z-XOF-z/FT150TS/README.md

<div align="center">

FT150TS Dashboard: tablero digital para la Italika FT150TS

<br/>

**El tablero que la FT150TS no traía de fábrica.**

Tablero digital + launcher para Android que funciona **solo con el teléfono** del manubrio
y está listo para una tarjeta **ESP32** en la moto.

[](#empezar)
[](app/src/main/java/com/xof/ft150ts)
[](app/src/main/java/com/xof/ft150ts/ui)
[](firmware/ft150ts_dashboard)
[](LEEME.md)

### [⬇ Descargar la app (APK v3.4 estable)](https://github.com/z-XOF-z/FT150TS/releases/latest)

**[Qué hace](#qué-hace)** · **[Empezar](#empezar)** · **[La tarjeta ESP32](#la-tarjeta-esp32)** · **[Historial completo](LEEME.md)**

</div>

---

## Por qué

El teléfono ya iba en el manubrio de la moto. En vez de solo mirar el mapa, se vuelve el **tablero completo**:
velocidad, RPM, marcha, inclinación, mantenimiento, gasolina y navegación, con un diseño pixel y deportivo
pensado para la FT150TS. Sin cables extra: las RPM salen de la **vibración del motor** que siente el teléfono.
Cuando llegue la tarjeta ESP32, ella manda los datos que el teléfono no puede medir (voltaje, temperatura, RPM
directas) y la app se cambia sola.

## Qué hace

<div align="center">
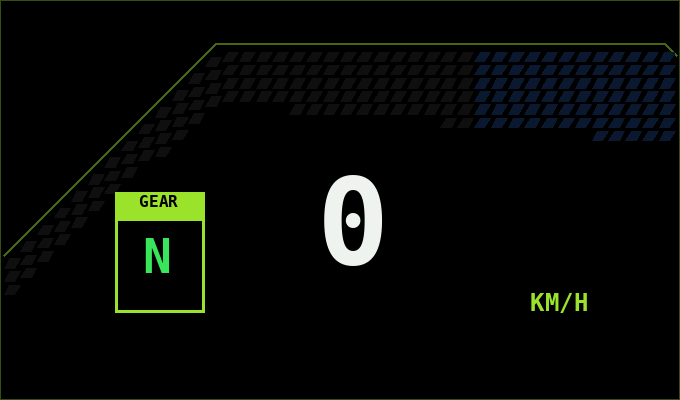
[picture p1: docs/entrada_tablero.gif]
Animación al entrar al tablero

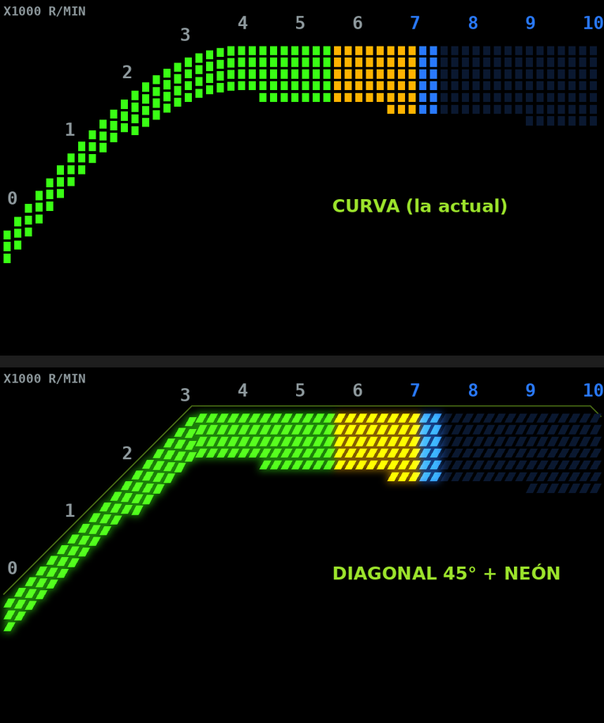
[picture p2: docs/barra_rpm.png]
Barra de RPM curva y diagonal a 45°

</div>

| Capacidad | Qué te da |
| --- | --- |
| **Tablero LCD Sport** | Barra de RPM curva o diagonal a 45°, dígitos de 7 segmentos, marcha, shift light y animación de arranque (las RPM suben al tope y regresan, como al dar switch). |
| **RPM sin sensor** | La vibración del motor por FFT de 3 ejes, peine de armónicos y filtro de Kalman. Se calibra en 6 s en ralentí. |
| **Marcha** | Velocidad + RPM + la marcha anterior en un filtro de probabilidad: no marca "4ª a 17 km/h". |
| **Aguja con PID** | La aguja tiene inercia de verdad; Kp, Ki y Kd ajustables con gráfica de respuesta. |
| **Mapa** | OpenStreetMap que gira suave con la brújula, satélites y doble frecuencia L5, dónde dejé la moto, límite de velocidad, "llévame a casa". |
| **Modo moto** | El cable de la moto hace de switch: carga = tablero, sin carga = tus apps. Etiqueta NFC del soporte y **modo sueño** cuando carga sin moverse. |
| **Launcher** | Pantalla de inicio con tus apps, 4 accesos directos y tres estilos de íconos (normales, pixel, LCD). |
| **Rodadas** | Cada rodada se graba sola; mírala en el mapa pintado por velocidad y **repítela** x10/x30/x60. Aviso de descanso. |
| **Arrancones** | 0-40/60/80, 100 m y 1/8 de milla con semáforo y tiempo de reacción, y prueba de frenado 40→0 (en lugar cerrado). |
| **Lluvia en tu ruta** | Revisa el pronóstico kilómetros adelante en la dirección en que vas y te avisa antes de mojarte. |
| **Velocímetro vs GPS** | Cuánto marca de más tu velocímetro y a cuánto vas de verdad. |
| **Mantenimiento** | Odómetro del teléfono, servicios por km, bitácora de gasolina con rendimiento y **alcance**. |
| **Respaldo** | Todos tus datos en un archivo: guárdalo, compártelo o deja el automático semanal. |
| **Seguridad** | Dashcam en bucle que guarda el video si detecta un golpe, aviso de teléfono caliente, batería del cel. |
| **Clima y alertas** | Lluvia próxima, huracanes (NHC), sismos (USGS) y clima severo en el tablero. |
| **Temas** | **Vértice** (riel lateral, nuevo), Carbono, Vidrio, Filo, Pixel, Táctico, Holo, Ácido y Circuito · efecto neón · 18 colores + uno personalizado · 4 fondos. |
| **Reposo** | Moto parada y cargando: reloj atenuado o pantalla apagada, GPS en pausa; despierta solo al dar marcha. |

### La idea en una línea

> El teléfono que ya va en el manubrio se vuelve el tablero; la ESP32 le da lo que el teléfono no puede medir.

## Empezar

### 1. Instala la app

**La rápida:** descarga el APK del [último release](https://github.com/z-XOF-z/FT150TS/releases/latest) en tu
teléfono (Android 8.0 o más nuevo), ábrelo y permite "Instalar apps desconocidas".

**Actualizar:** desde la 3.2-beta.1, en la app: Ajustes → Acerca de → **Buscar actualización** (prende "Versiones de prueba" para recibir betas). Se instala encima sin
borrar tus datos. Detalles y cómo publicar una versión en [docs/RELEASE.md](docs/RELEASE.md).

**Desde el código:**

Abre esta carpeta en **Android Studio**, conecta el teléfono (depuración USB) y:

```bash
./gradlew installDebug      # normal
./gradlew installRelease    # optimizada, más fluida (misma firma: no borra tus datos)
```

Requiere Android 8.0 o más nuevo. Siempre se instala **encima**: tu odómetro, marchas aprendidas y ajustes se quedan.

### 2. Calibra las RPM (una vez)

Moto en neutral, motor caliente en ralentí y el teléfono en el soporte:
**Ajustes > Sin la tarjeta > Calibrar en ralentí** (6 segundos).

### 3. Escoge tu estilo

**Ajustes > Apariencia**: tema, color de acento, neón, fondo, forma de la barra de RPM y la animación de entrada.

## La tarjeta ESP32

Firmware en [`firmware/ft150ts_dashboard`](firmware/ft150ts_dashboard), placa **ESP32-S3**, particiones *Huge APP*:

```bash
arduino-cli compile --fqbn espressif:esp32:esp32s3:PartitionScheme=huge_app firmware/ft150ts_dashboard
```

Desde la v1.4 cada tarjeta genera su propia clave de WiFi (se ve por USB al encender o con `wifi clave`) y los
comandos delicados solo se aceptan de un teléfono vinculado. Detalles en [SEGURIDAD.md](SEGURIDAD.md).

## Placa base y piezas 3D

- **Placa base v2.3** para el ESP32-S3 N16R8 (10×10 cm, 2 capas, piezas de agujero de tiendas de México): guía de armado y conexiones a la moto en [`pcb/ARMADO.md`](pcb/ARMADO.md), esquemático en [PDF](pcb/esquematico/ft150ts_B_esquema.pdf), gerbers para JLCPCB en [`pcb/fabricar/B_JLCPCB`](pcb/fabricar/B_JLCPCB) y piezas en [`pcb/LISTA_COMPRAS.md`](pcb/LISTA_COMPRAS.md).
- **Placas extra** (expansión I2C con 3 relevadores, fusibles y perforada): [`pcb/extras`](pcb/extras).
- **Simulaciones** de cada bloque (ngspice/KiCad): [`pcb/simulacion`](pcb/simulacion).
- **Piezas 3D** (CadQuery): soporte del teléfono para el manubrio y caja de la placa bajo el asiento, en [`carcasa`](carcasa) (STL y STEP).
- Mapa de todo el proyecto: [`docs/MAPA.md`](docs/MAPA.md).

## Temas

<div align="center">
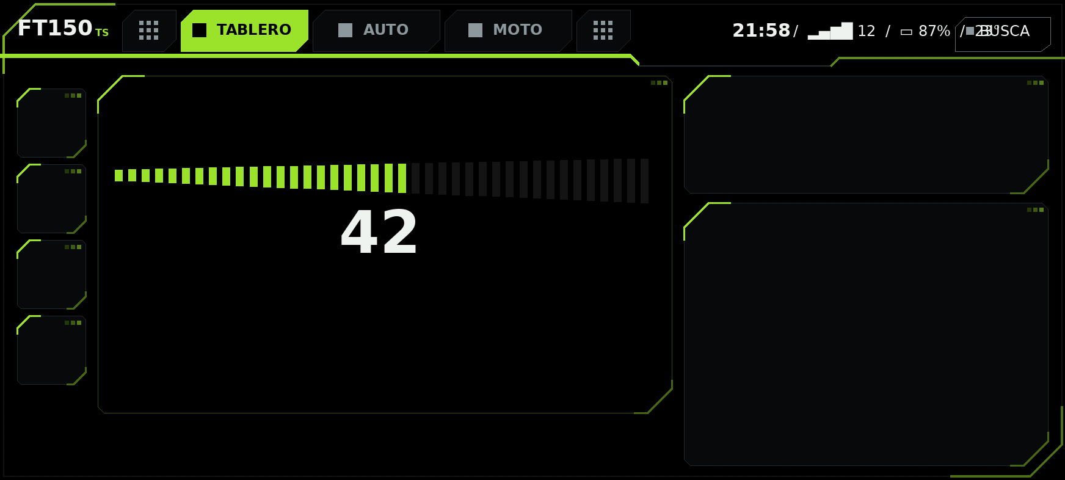
[picture p3: docs/maqueta_filo.png]
Tema Filo

<br/><sub>Tema Filo: barra integrada con segmentos a 45° y todo dentro de un marco tipo visor.</sub>
</div>

## Hoja de ruta

- [x] Tablero LCD Sport y Clásico con aguja PID
- [x] RPM por vibración, marcha por velocidad + RPM
- [x] Modo moto, NFC, modo sueño
- [x] Temas Filo, Pixel y Táctico, neón y colores personalizados
- [x] Respaldo y restaurar todos tus datos en un archivo
- [x] Modo arrancones (0–60 km/h, 1/8 de milla, semáforo) y prueba de frenado
- [x] Lluvia en tu ruta
- [x] Repetición de rodadas coloreada por velocidad
- [x] Error del velocímetro contra el GPS
- [x] Logros pixel (y un secreto)
- [x] Tema Vértice, modo reposo y medidor de fluidez
- [x] Auditoría de seguridad (WiFi y Bluetooth de la tarjeta, respaldo)
- [ ] Antirrobo (con la ESP32)
- [ ] Temperatura del motor, nivel de gasolina real y presión de llantas (con la ESP32)

## Estructura

```
app/                      App de Android (Kotlin + Jetpack Compose)
  src/main/java/com/xof/ft150ts/
    ui/                   Pantallas, temas, barra integrada, animaciones
    *.kt                  GPS, sensores, RPM, marcha, modo moto, modo sueño...
firmware/
  ft150ts_dashboard/      Firmware del ESP32-S3 (Arduino)
docs/                     Banner animado, GIFs e imágenes
releases/                 APK listo para instalar y notas de cada versión
LEEME.md                  Guía completa e historial de versiones
```

---

<div align="center">

Hecho por **XOF** para su Italika FT150TS.

<sub>Tipografías Chakra Petch, Russo One y Press Start 2P con licencia OFL ([LICENCIAS_FUENTES.txt](LICENCIAS_FUENTES.txt)) · Mapas © colaboradores de OpenStreetMap</sub>

</div>

[android-shield]: https://img.shields.io/badge/Android-8.0%2B-9BE22B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
[kotlin-shield]: https://img.shields.io/badge/Kotlin-2.1-9BE22B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
[compose-shield]: https://img.shields.io/badge/Jetpack%20Compose-Material%203-9BE22B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
[esp32-shield]: https://img.shields.io/badge/ESP32--S3-firmware-9BE22B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
[version-shield]: https://img.shields.io/badge/versi%C3%B3n-3.4-9BE22B?style=for-the-badge&labelColor=0E1113
