z-XOF-z/FT150TS/docs/MAPA.md

# Mapa del proyecto FT150TS

Tablero digital para la moto **Italika FT150TS**, en tres partes que trabajan juntas:

1. **App Android** (`app/`): Kotlin + Jetpack Compose. Paquete `com.xof.ft150ts`. Convierte el POCO F4 en tablero y launcher (HOME) de la moto: velocímetro, RPM, marcha, mapas, CarPlay (vía DiPlay), música, SOS, ahorro nocturno con root y temas.
2. **Firmware ESP32-S3** (`firmware/ft150ts_dashboard/`): lee los sensores de la moto, muestra una LCD 20x4 y le manda la telemetría a la app por Bluetooth (BLE).
3. **Hardware** (`pcb/`, `carcasa/`): la placa base para el ESP32 (KiCad → JLCPCB) y las piezas impresas en 3D (soporte del teléfono y caja bajo el asiento).

## Compilar, probar y publicar

| Qué | Comando o pasos |
|---|---|
| App: pruebas + APK | Git Bash: `export JAVA_HOME="/c/Program Files/Android/Android Studio/jbr"; ./gradlew :app:testDebugUnitTest :app:assembleRelease` (sin JAVA_HOME falla al arrancar; Gradle usa JDK 21 por `gradle/gradle-daemon-jvm.properties`) |
| App: instalar | `adb install -r app/build/outputs/apk/release/app-release.apk`. Misma firma (`debug.keystore` de esta PC); **nunca desinstalar** |
| App: publicar | Sube `versionCode`/`versionName` en `app/build.gradle.kts` → APK a `releases/FT150TS-vX.apk` + `releases/NOTAS-vX.md` → release `vX` en `z-XOF-z/FT150TS` con el APK adjunto. Guía: `docs/RELEASE.md`. Esta carpeta **no es repo git**: el código se sube con un clon aparte |
| Firmware | Arduino IDE o arduino-cli, placa "ESP32S3 Dev Module", **core esp32 3.2.1** (el 3.3 rompe el BLE), Flash 16MB, PSRAM OPI y particiones **"16M Flash (3MB APP/9.9MB FATFS)"** (`PartitionScheme=app3M_fat9M_16MB`): dos copias para actualizar desde la app (OTA). Para grabar por la app: Sketch > Exportar binario compilado |
| Placas | Python de KiCad 10: `pcb/generar_pcb.py B --rutear` (placa principal), `pcb/extras/generar_extra.py E|F`, `pcb/extras/generar_perforada.py`. Freerouting necesita Java 25 (JBR) |
| Piezas 3D | `carcasa/.venv` (CadQuery): `python carcasa/caja_tablero/caja_tablero.py`, `caja_bateria.py` |

## Carpetas

| Carpeta | Qué hay |
|---|---|
| `app/src/main/java/com/xof/ft150ts/` | Lógica de la app (≈70 archivos, uno por función) |
| `app/src/main/java/com/xof/ft150ts/ui/` | Pantallas y tableros en Compose (≈36 archivos) |
| `app/src/test/` | Pruebas unitarias (104 a la v3.10.0) de las partes `*Logica.kt` y protocolos |
| `firmware/ft150ts_dashboard/` | El `.ino` (~4 150 líneas) + `certificados.h` (raíces de api.telegram.org, vencen en 2037) |
| `firmware/simulador_wokwi/` | Copia del sketch + `diagram.json` para simular en Wokwi/Velxio |
| `firmware/HARDWARE-CORTE-CHISPA.md` | Circuito del corte de chispa (PC817 + IRF840) |
| `docs/` | `CARPLAY.md`, `AHORRO_NOCTURNO.md`, `SOS.md`, `RELEASE.md`, `ESP32_ARRANQUE_XMC.md` (arranque, particiones y falla XMC del N16R8), este mapa |
| `bootloader_reparado_XMC.bin` | Bootloader de 2.ª etapa con parche XMC `0x70` (ESP-IDF 5.4.2 local). Se graba solo en `0x0`; ver `docs/ESP32_ARRANQUE_XMC.md` |
| `releases/` | APK de cada versión + `NOTAS-v*.md` (la app muestra las notas como "qué hay de nuevo") |
| `modulo-magisk/` | Módulo "ft150ts_sin_barra": quita la barra de 3 puntos de las ventanas libres (CarPlay) |
| `scripts/` | Diagnósticos de solo lectura por ADB (`diagnostico-carplay.ps1`, `diagnostico-energia.ps1`) |
| `pcb/` | Diseño de la placa base (ver la sección Placas) |
| `carcasa/` | Piezas 3D (ver la sección Piezas 3D) |
| `llavero/` | **TamaXOF**, el llavero (ESP32-C3 SuperMini + OLED 0.96" + TP4056 + pila de control de PS4). `firmware/tamaxof/` es el llavero: caritas, llave por ESP-NOW cifrada, paro de motor, música BLE y extras. `moto/tamaxof_moto.h` es el lado moto, **todavía no está en el .ino**. `moto/probador_moto/` es una moto falsa para la mesa. `comun/` tiene el protocolo y la clave (`generar_secreto.py`, la clave no se sube). `pcb/generar_placa.py` es la placa casera de una cara con planchado y revisión de cortos y separación. `carcasa/carcasa_tamaxof.py` es la caja con revisión de choques. Todo explicado en `llavero/LEEME.md` |

## App: archivos por área

| Área | Archivos | Qué hacen |
|---|---|---|
| Arranque y navegación | `MainActivity.kt`, `ui/AppFT150.kt`, `ui/Barra.kt`, `ui/Arranque.kt`, `ui/PantallaInicio.kt`, `ui/InicioNeon.kt` | Launcher HOME; pager Tablero · Auto · Moto · Ajustes; pantallas de inicio |
| Conexión con el ESP32 | `BleManager.kt`, `Moto.kt`, `ServicioMoto.kt`, `Modelo.kt` (`Estado`, `Rapida`) | BLE, comandos a la tarjeta, servicio en segundo plano, modelo de datos |
| Tableros | `ui/PantallaTablero.kt`, `ui/Tableros*.kt`, `ui/Tablero*.kt`, `ui/TinteTableros.kt`, `ui/TableroUniversal.kt` | LCD, deportivos, instrumento, neón, morado, telemetría, dual neón |
| Datos de manejo | `Velocimetro.kt`, `Marcha.kt`, `RpmVibracion.kt`, `Sensores.kt`, `Termico.kt`, `Odometro.kt`, `Gasolina.kt`, `Estadisticas.kt`, `Arrancones.kt`, `Baches.kt`, `LimitesVia.kt` | Velocidad, marcha estimada, RPM por vibración, mantenimiento, consumo |
| Auto, mapas y CarPlay | `ui/PantallaAuto.kt`, `CarPlay.kt`, `CarPlayPestana.kt`, `ui/MapaCarPlay.kt`, `GestosCarPlay*.kt`, `Mapas.kt`, `Ubicacion.kt`, `Gpx.kt`, `Rodadas.kt`, `Rutinas*.kt`, `LluviaRuta.kt`, `Clima.kt` | CarPlay de DiPlay dentro de la pestaña, mapas, rodadas y rutinas |
| Música y audio | `Musica.kt`, `AudioSalida.kt`, `VolumenAuto.kt`, `VolumenLogica.kt`, `Sonoridad.kt`, `ui/AjustesAudio.kt` | Control de música y volumen según la velocidad |
| Teléfono y apps | `Lanzador.kt`, `ui/PantallaApps.kt`, `Acciones.kt`, `NotifListener.kt`, `TelefonoMoto.kt`, `ComandosVoz.kt`, `Voz.kt` | Lista de apps, notificaciones, voz |
| Root y energía | `Root.kt`, `AyudanteRoot.kt`, `Energia.kt`, `Nocturno*.kt`, `Reposo.kt`, `Encendido.kt`, `DiagnosticoEnergia.kt`, `ModoRendimiento*.kt`, `Pantalla.kt`, `Fluidez.kt`, `PantallaEncendidaLogica.kt` | Sesión `su` con lista permitida, ahorro nocturno, modo rendimiento, 90/120 Hz; cuándo se fuerza la pantalla prendida y cuándo se cierra CarPlay escondido (guardián en `CarPlayPestana.kt`) |
| Seguridad | `Emergencia.kt`, `ui/SosUi.kt`, `Dashcam.kt`, `Estacionamiento.kt`, `ZonaWifi.kt`, `NfcMoto.kt` | SOS con cuenta regresiva, dashcam (con `.srt`), dónde quedó la moto |
| Funciones avanzadas | `FuncionesAvanzadas.kt`, `ui/AjustesAvanzadas.kt` | Limitador, launch, quickshifter y diagnóstico (todo apagado; protocolo `av`) |
| Apariencia | `Apariencia.kt`, `Estilos.kt`, `ui/Tema.kt`, `ui/MotorEstilos.kt`, `ui/Vertice.kt`, `ui/IconosApp.kt` | Temas, estilos de tablero, íconos |
| Ajustes y respaldo | `ui/PantallaAjustes.kt`, `ui/Ajustes*.kt`, `Respaldo.kt`, `Actualizador.kt` | Configuración, respaldo y actualizador desde GitHub |
| Herramientas de la tarjeta | `TarjetaHerramientas.kt` (`OtaTarjeta`, `RegistrosTarjeta`, `CasaTarjeta`, `OtaLogica`, `LogicaTelegram`), `ui/TarjetaHerramientasUi.kt` | Actualizar el firmware por Bluetooth, bajar los CSV de la SD a Descargas/FT150TS, WiFi de casa + bot de Telegram (firmware v1.6+) |
| Placa B | `PlacaB.kt`, `ui/PlacaBUi.kt` | Nombres y control de los relevadores 2/3 y la salida, alarma, IA de vibraciones, luz del teléfono a la tarjeta (`luz N` cada 10 s), avisos de direccional olvidada / vibración rara |
| Antirrobo del teléfono | `Vigilancia.kt` (+ `TelegramTel`), `VigilanciaLogica.kt`, `ui/MotoExtrasUi.kt` | Con la moto estacionada: si mueven el teléfono (o la tarjeta manda `m`) y no eres tú en 20 s, fotos de las 2 cámaras + audio + ubicación por Telegram. Cámara y micrófono con la pantalla apagada: `ServicioMoto` con tipos camera/microphone |
| Estado y baterías | `Voltajes.kt`, `ui/MotoExtrasUi.kt` (`SeccionEstadoMoto`, `SeccionBaterias`) | Estado de la moto (`salud`) y gráficas de voltaje de 24 h |
| Red de seguridad | `Seguro.kt` | `Seguro.manejador` en todas las `CoroutineScope`: un error de fondo se anota (`FT150-ERR`) en vez de cerrar el launcher |
| Otros | `Logros.kt`, `Alertas.kt`, `ui/AlertasUi.kt`, `BateriaTel.kt`, `Brujula.kt`, `Luz.kt`, `Pid.kt`, `Sueno.kt`, `BluetoothAdmin.kt` | Logros, alertas, sensores del teléfono |

Archivos `*Logica.kt`: lógica pura sin Android, para que se pueda probar en `app/src/test/`.

## Firmware: secciones del `.ino`

| Línea aprox. | Sección |
|---|---|
| 64 | 0) Interruptores generales (`MODO_SIMULADOR`, `USAR_*`) |
| 292 | 2) Configuración: pines, valores `<-- X` que hay que llenar |
| 620 / 674 | 5) Memoria NVS · 6) Tarjeta SD (CSV) |
| 724–1044 | 7) Analógicos · 8) RPM y velocidad (interrupciones) · 9) GPS · 10) MPU6050 · 11) DS18B20 · 12) Marcha e ignición · 13) Botones |
| 1076–1617 | 14) Pantalla · 15) Mantenimiento · 16) Viajes · 17) Motor · 18) Baterías · 19) Shift light · 20) Modo pista · 21) Corte de motor |
| 1617 | 21b) Funciones avanzadas (`USAR_CORTE_CHISPA 0`, tarea FreeRTOS `tareaChispa`) |
| ~1850 | 21c) Placa B: entradas (freno, direccional olvidada), relevadores 2/3 y salida (`rele`), carga de la celda · 21d) Alarma de movimiento (`alarma`, MPU en modo ciclo + INT despierta a la tarjeta, 20 s para girar la llave) · 21e) IA de vibraciones (`vibra`: FIFO del MPU a 100 Hz, Goertzel, promedio y variación por rango de 500 rpm, alerta > 3.5) |
| ~2530 | 21g) Placa E (`placaETick`, PCF8574 0x20 leído cada 100 ms, BOMBA con tope 10 min/descanso 5, corte por batería < 10.5 V o moto en movimiento; `FUNCION_E` para sus 4 entradas) · 21h) Guardián (`guardianBegin/Tick/Vigilar`: vigilante de 30 s en loop, motivo del reinicio, modo seguro tras 3 fallas, temperatura del chip, memoria, regulador, componentes; bitácora NVS de 12 renglones → Telegram y evento `w`) |
| ~2900 | 21i) IA del motor (`iaMotorTick`: embrague que patina = relación RPM/vel vs lo aprendido a velocidad constante por marcha (Welford), acelerando en 3a+; aceite por km efectivos con factor por RPM/temperatura/frío; NVS "ia"; comando `ia`, renglón "Embrague" en `salud`). `USAR_PLACA_E` (sección 0) apaga la búsqueda de la placa E |
| ~2300 | 21f) IA de baches (`bachesRevisar`, adaptativa, `baches.csv` + evento `b`), estado de los componentes (`salud`), llave de proximidad (`llave`, APAGADA de fábrica, código de botones), resumen semanal (Telegram los lunes) |
| 1851–2310 | 22) Alertas · 23) Vistas · 24) Menú · 25) Modo demo · 26) Lectura real |
| 2328 / 2478 | 27) Notificaciones · 27b) iPhone |
| 2903 | 28) Consola (Serial y web, mismos comandos) |
| ~3090 | 28b) `ota …` (firmware desde la app), `sd lista/leer` (registros), `casa …` (WiFi de casa + Telegram: `casaAlDespertar`, `casaTick`, `tgRevisarMensajes`) |
| 3175 / 3296 | 29) WiFi · 29b) Telemetría BLE para la app |
| 3488 / 3548 | 30) Sueño profundo · 31) setup/loop |

## Cómo fluye la información

- Sensores (bobina → RPM, Hall → velocidad, GPS, MPU6050, temperatura, voltajes) → **ESP32** → LCD 20x4.
- ESP32 → **BLE** (sección 29b) → `BleManager` → `Moto` → `Estado` → tableros de la app.
- App → comandos de texto por BLE (`Moto.comando`, protocolo de la consola, sección 28): calibración y funciones avanzadas (`av ...`).
- Respuestas especiales: JSON `{"av":1,...}` (estado avanzado) y `"d"` cada 3 s (diagnóstico).
- **v1.6 / app v3.11:**
  - Al conectar, la app pide `tel bin`: el mensaje rápido llega en **binario**, 18 bytes, 10 veces por segundo (`binRapido` ↔ `Protocolo.parseRapidaBin`). Una tarjeta vieja lo ignora y sigue con JSON.
  - **OTA:** característica `…0006` (solo enlace cifrado). La app manda `ota inicio <bytes> <md5>`, después los pedazos `[desde 4 B][datos]` con escritura confirmada y al final `ota fin`.
  - **Registros:** `sd lista` → `@SDL [...]`; `sd leer <archivo> <desde>` → `@SD archivo desde n total\n` + texto.
  - **Casa:** `casa` → `{"casa":1,...}` (sin claves); `casa ssid|clave|tg|cada|prueba|borrar`.
  - Delicados (solo enlace cifrado o USB): `ota …`, `casa …`, `borrar`, `dormir`.
- **Eventos de la tarjeta a la app:** `m` (movieron la moto), `b` (bache), `g` (cargaste gasolina), `w` (el guardián anotó una falla), por `bleEvento`.
- **v1.7 / app 3.11.0-beta.2:** `e` → `{"e":{"hay","s":[bomba,r2,r3,sal],"in":[4],"bt","des","corto","mot"}}`; `e bomba|2|3|s on [seg]|off` (delicado). `errores` → `{"err":[{t,c,x}],"seguro","tc","hp"}`; `errores borrar`. cfgjson trae `pe` (placa E) y `seg` (modo seguro). Telegram `/errores`. App: `ui/PlacaEUi.kt` (`SeccionPlacaE`, `SeccionGuardian`), `PlacaB.placaE/errores`, prueba `PlacaETest`.
- **Telegram:** también `/salud` y `/semana`. La tarjeta despierta cada `casa cada` min (15 de fábrica), se conecta a tu WiFi, avisa (batería baja, la movieron) y obedece `/estado`, `/bloquear`, `/desbloquear` y `/ubicacion`, solo de tu chat. Con la batería de la moto < 11.8 V despierta cada 4 h y no prende el WiFi.

## Placas (`pcb/`)

| Archivo | Qué es |
|---|---|
| `diseno.py` | Netlist de la placa A/B en texto: pieza, huella, valor y red de cada pin. **Se edita aquí, no en KiCad** |
| `generar_pcb.py` | Acomoda (ANCLAS + acomodo automático), rutea con Freerouting y pone el plano de tierra |
| `esquematico/generar_esquematico.py` | Esquemático de la B a partir de `diseno.py` |
| `simulacion/` | 6 circuitos para simular con ngspice + `modelos.lib` |
| `extras/` | Placas E (expansión I2C), F (fusibles) y P (perforada) |
| `fabricar/<X>_JLCPCB/` | Gerbers en zip, listos para JLCPCB |
| `LISTA_COMPRAS.md`, `LEEME.md` | Piezas (tiendas de México) y guía |
| `guia_armado_B.html` | Guía interactiva para soldar la B (publicada como artifact "Armado Placa B"). `agregar_cuerpos_guia.py` le dibuja las piezas en su posición real leyendo `ft150ts_B.kicad_pcb` con `leer_huellas.py` (capas, zoom, altura y orden); se puede volver a correr |

**Pines de la placa B:** ya aplicados en el firmware v1.6 (sección 2). Relevadores 40/38/45 (alto = prendido), carga 43, entradas aisladas 21 llave / 18 neutral / 3 freno / 46 direccionales (LOW = el cable tiene voltaje), salida 44, corte de chispa 47, quickshifter 48 y la INT del MPU en GPIO5 (J11, en lugar de la LDR). Guía: `pcb/ARMADO.md`.

## Piezas 3D (`carcasa/`)

- `*.py` en la raíz + `stl/`: soporte del POCO F4 con rótula de 24.5 mm (bandeja, marco, tapa, perilla, sockets y anillos de calibración).
- `caja_tablero/`: caja de la placa (`caja_tablero.py`), que se atornilla a los 4 birlos M6 del asiento, y porta-batería (`caja_bateria.py`).

## Si quiero… → toca aquí

| Quiero | Archivo |
|---|---|
| Un tablero nuevo | Composable en `ui/Tableros*.kt` → valor en `enum EstiloTablero` (`Apariencia.kt`) → nombre en `ui/Tableros.kt` → caso en `ui/PantallaTablero.kt` → botón en `ui/PantallaAjustes.kt` |
| Un ajuste nuevo | `ui/PantallaAjustes.kt` (o su `ui/Ajustes*.kt`) |
| Un dato nuevo de la moto en la app | Firmware 29b (enviarlo) → `Modelo.kt` (`Estado`) → `Moto.kt` (leerlo) |
| Un comando nuevo para la tarjeta | Firmware sección 28 (consola) → `Moto.comando(...)` en la app |
| Cambiar un pin | Firmware sección 2 (y `pcb/diseno.py` si es de la placa) |
| Cambiar la placa | `pcb/diseno.py` → `generar_pcb.py B --rutear` → revisar DRC → exportar gerbers |
| Publicar versión | `docs/RELEASE.md` |
| Algo de CarPlay | `CarPlay.kt` / `CarPlayPestana.kt` + `docs/CARPLAY.md` |
| Una orden nueva de Telegram | Firmware `tgResponder` (28b) |
| Un dato nuevo en la telemetría rápida | Firmware `binRapido` + `Protocolo.parseRapidaBin` (subir el tamaño en los dos) + prueba en `LogicaTarjetaTest` |

## Trampas conocidas

- **App:**
  - No cambiar `applicationId` ni la firma: se perderían los datos del teléfono.
  - El `versionCode` siempre debe subir.
  - El modo demo nunca se deja prendido.
  - Las apps que se abren desde VS Code heredan `ELECTRON_RUN_AS_NODE=1`, y Arduino IDE y Code se cierran al instante: hay que quitar esa variable antes de abrirlas.
  - La pantalla de CarPlay de DiPlay trae `FLAG_KEEP_SCREEN_ON`: escondida fuera de la pantalla (modo Pestaña) sigue manteniendo el teléfono prendido. Para ver quién la mantiene: `adb shell dumpsys window | grep mHoldScreenWindow`.
  - "Cargando" no siempre es la moto: `Energia.cargaDeMoto()` excluye la computadora (`enComputadora`, aviso del sistema `USB_STATE` con `configured=true`). Úsalo en lugar de `Energia.cargando` cuando quieras decir "switch prendido".
  - Para medir el tablero: `gfxinfo framestats` o Perfetto (`-a com.xof.ft150ts gfx view sched`) con el modo demo. En Git Bash hace falta `MSYS_NO_PATHCONV=1` para rutas `/data/...`. Medido en v3.10.1: ~43 cuadros/s en demo, el costo está repartido (no hay un solo efecto caro).
- **HyperOS (POCO F4):**
  - `grep` no soporta `\|`: usa `grep -E`.
  - SurfaceFlinger imprime la escala como fila de matriz.
  - DiPlay reinicia las medidas de su ventana.
  - Más detalles en `docs/CARPLAY.md`.
- **Firmware:**
  - No actualizar el core del ESP32 a 3.3 (NimBLE rompe el BLE).
  - Con la N16R8 no usar GPIO35–37 (los ocupa la PSRAM).
  - Falla `XMC flash startup fail`: es del bootloader, no del `.ino`. No usar "Subir" ni `merged`/`-completo.bin` (reponen el bootloader sin parche); la app va sola a `0x10000` ("Subir con programador"). Detalles en `docs/ESP32_ARRANQUE_XMC.md`.
- **Arduino:** un `struct` que use una función con prototipo automático tiene que ir arriba, con los tipos (sección 1). Si no, falla con "was not declared".
- **Placas:**
  - El archivo de reglas de Freerouting debe llamarse igual que el DSN.
  - Una pieza del lado equivocado del DevKit hace que Freerouting reporte "0 sin rutear" sin haberla ruteado: siempre revisar el DRC.

Última revisión: 2026-10-30 (v3.11.0-beta.2, firmware v1.7 con placa E y guardián, placa B v2.3)
