z-XOF-z/FT150TS/llavero/pcb/cobre_1200dpi.pdf

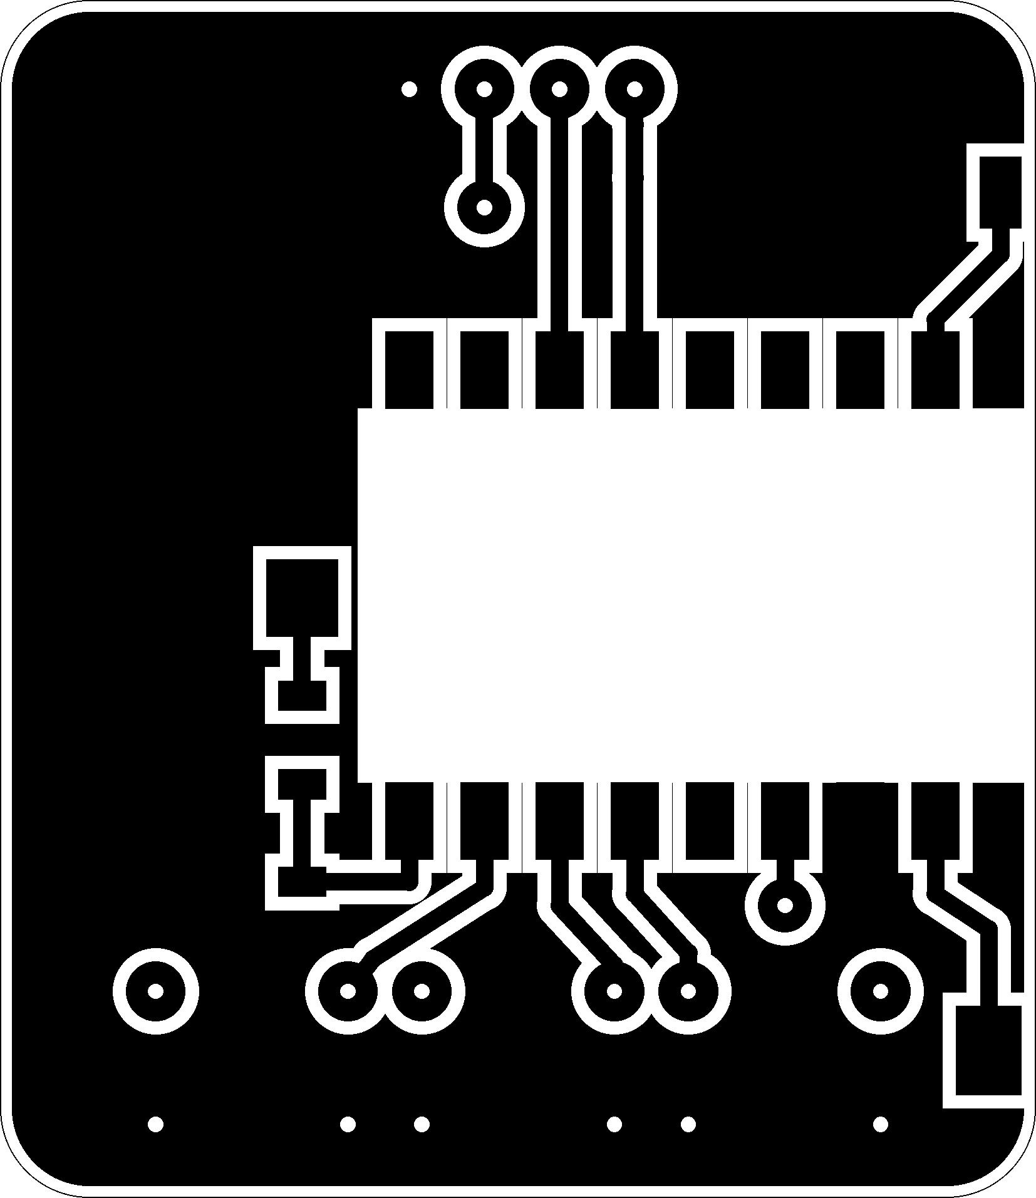
[picture p4: page 1]
