z-XOF-z/FT150TS/releases/NOTAS-v3.8.0.md

## FT150TS Dashboard v3.8.0 (estable)

### Zona Wi-Fi con el switch (root)
Abres el switch → se prende tu zona Wi-Fi guardada (la que conoce el iPhone para CarPlay). Lo cierras → se apaga 1 min después; si lo vuelves a abrir antes, sigue prendida. Solo apaga la zona que prendió la app. Ajustes > Modo moto.

### Rutinas: el mapa aprende a dónde vas
Con tus rodadas aprende Casa, Escuela y tus horarios (también entre semana con días distintos). Una tarjeta en Tablero y Auto: "Escuela · 18 min · llegas 7:36 (14 min antes)" contra tu horario de entrada. Aviso por voz opcional si vas tarde. Todo se queda en el teléfono. Ajustes > Rutinas.

### Gestos de CarPlay (root)
En Widgets desliza a la derecha → Tablero; en tu última página de apps, a la izquierda → Moto. FT150TS reconoce la página de CarPlay mirando el botón del dock y los puntitos (sirve con cualquier tamaño de CarPlay); dentro de una app o del mapa no hace nada.

### Bluetooth y audio (Ajustes)
- Tus dispositivos con su estado real, buscar y emparejar, conectar y desconectar (root) y un preferido que se reconecta al abrir el switch.
- Volumen progresivo con la velocidad: suave, con histéresis, respeta tus cambios y regresa tu volumen.
- Sonoridad +: hasta +6 dB sin saturar (+3.5 dB ≈ 150 %). Botón directo a Efectos de sonido (Dolby Atmos).
- Música al cerrar el switch: baja suave, sigue bajita 30 s (configurable) y luego se pausa; si abres antes, regresa.

### Interfaz principal
- Con bloqueo sin PIN, el tablero lo quita solo al prender la pantalla (CarPlay ya aparece). Con PIN no se salta nada.
- HyperOS le quita a FT150TS sus permisos (inicio automático, sobre el bloqueo) en cada actualización: la app se los vuelve a dar con root.
- Si la app se cierra sola estando en la moto, el tablero vuelve al frente.

88 pruebas pasan. Probado en un POCO F4 con HyperOS 1 (zona Wi-Fi, gestos de CarPlay, bloqueo, rutinas con 38 rodadas reales y la música al cerrar el switch).
