z-XOF-z/FT150TS/carcasa/caja_tablero/placa_B_reles_SRD.png

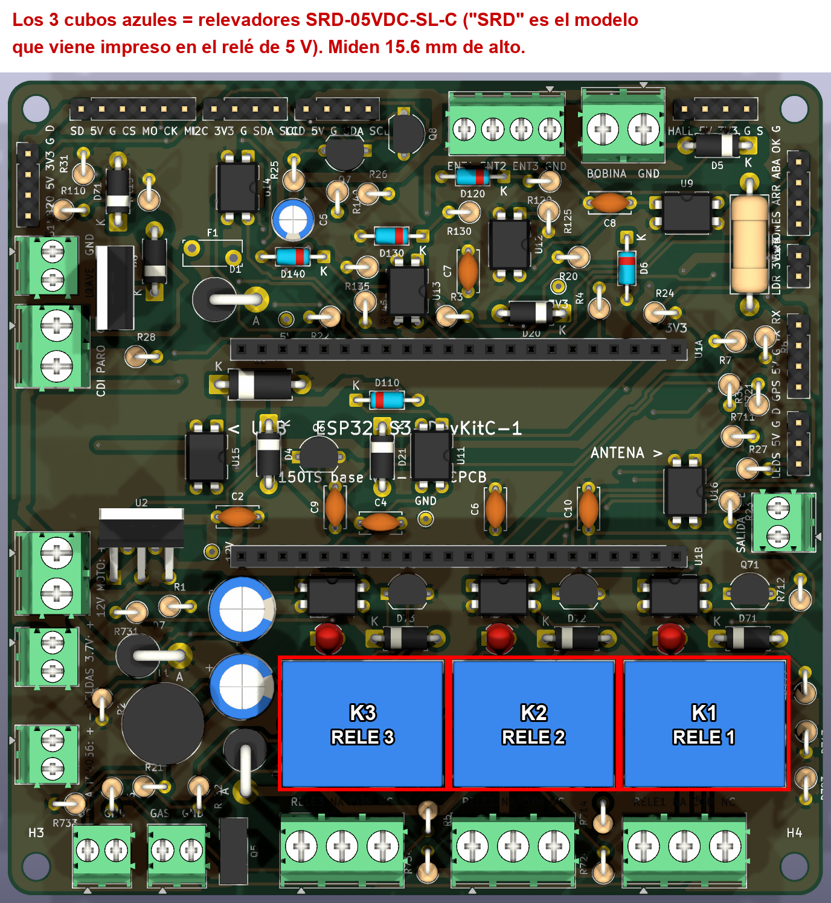
carcasa/caja_tablero/placa_B_reles_SRD.png
