z-XOF-z/FT150TS/carcasa/caja_tablero/vista_caja_v5.png

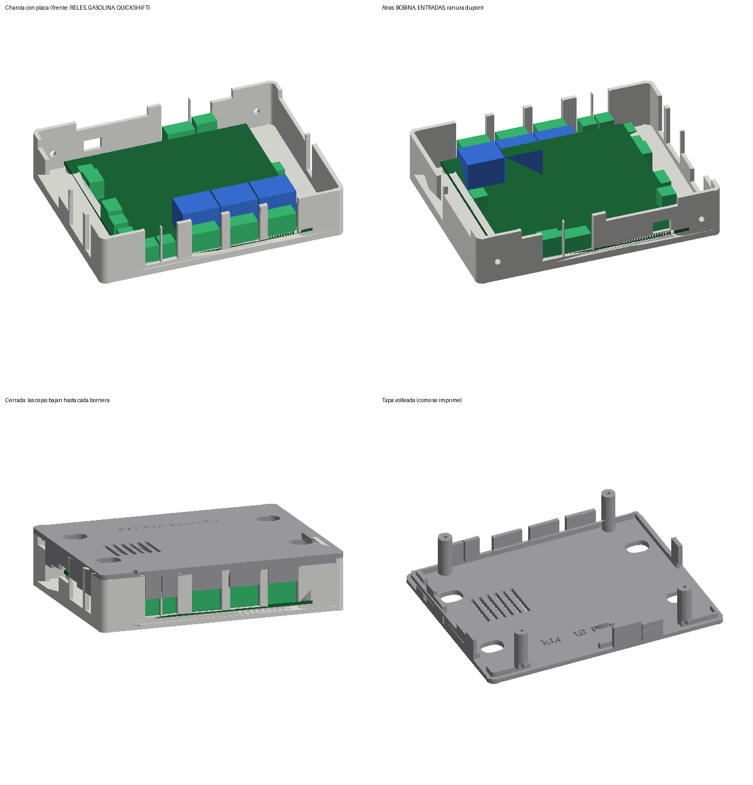
carcasa/caja_tablero/vista_caja_v5.png
