z-XOF-z/FT150TS/carcasa/caja_tablero/vista_charola.png

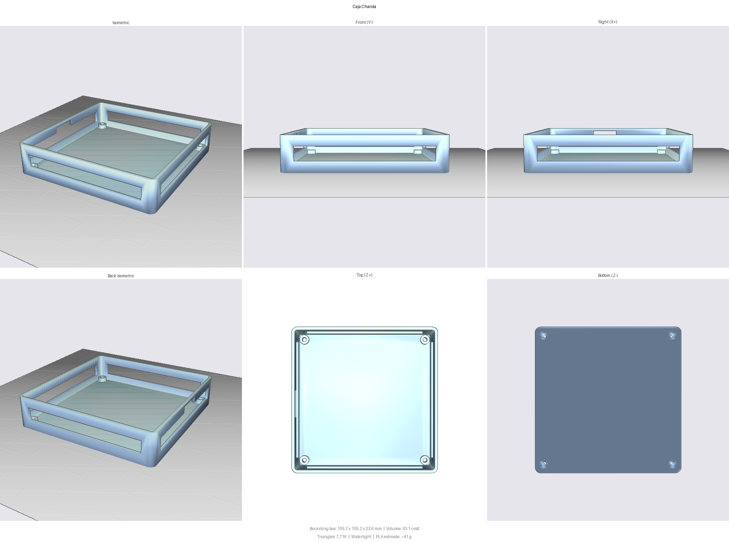
carcasa/caja_tablero/vista_charola.png
