z-XOF-z/FT150TS/carcasa/caja_tablero/vista_con_bateria.png

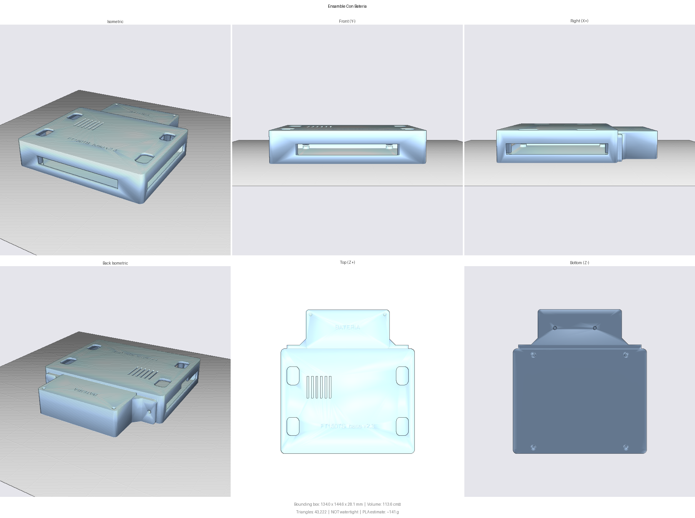
carcasa/caja_tablero/vista_con_bateria.png
