z-XOF-z/FT150TS/carcasa/caja_tablero/vista_tapa.png

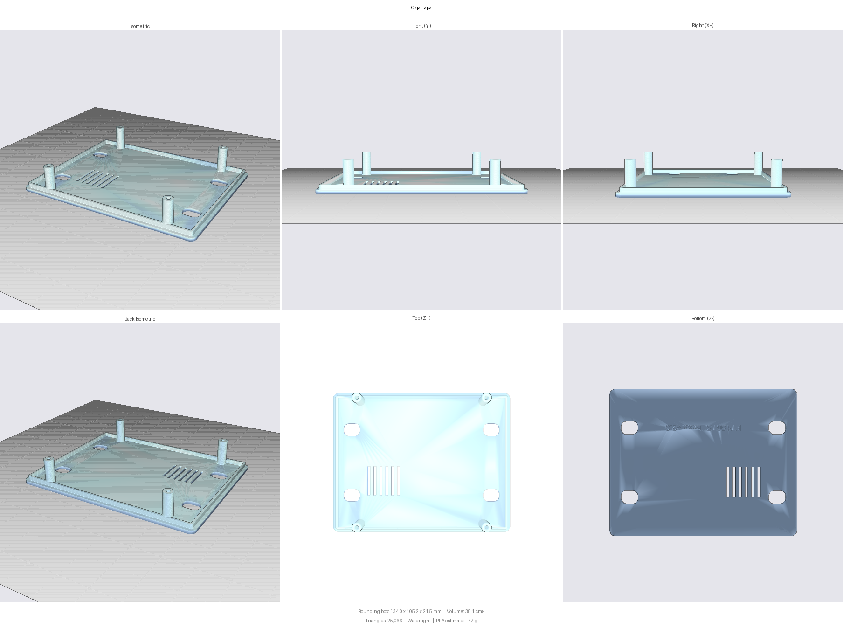
carcasa/caja_tablero/vista_tapa.png
