z-XOF-z/FT150TS/carcasa/vistas/esc_bola_ajuste.png

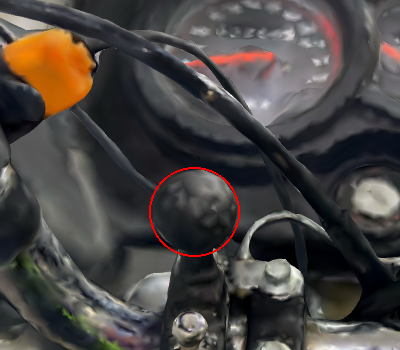
carcasa/vistas/esc_bola_ajuste.png
