z-XOF-z/FT150TS/carcasa/vistas/esc_cerca.png

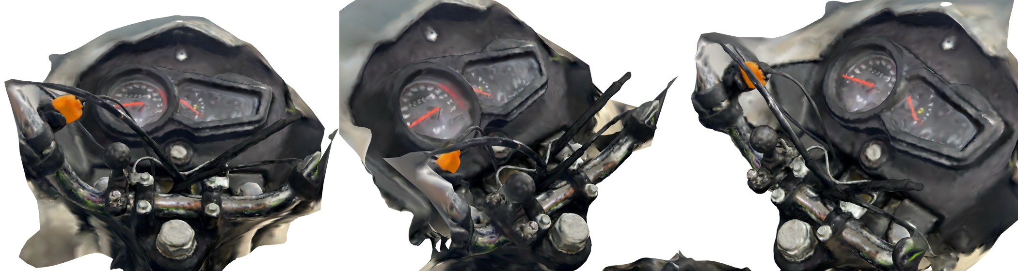
carcasa/vistas/esc_cerca.png
