z-XOF-z/FT150TS/carcasa/vistas/esc_der.png

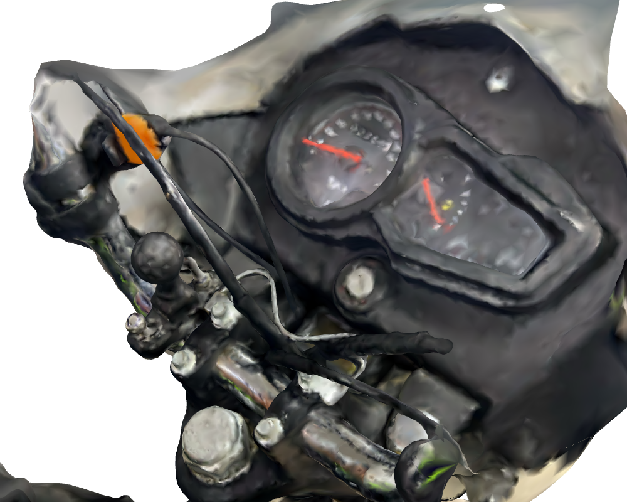
carcasa/vistas/esc_der.png
