z-XOF-z/FT150TS/carcasa/vistas/esc_frente.png

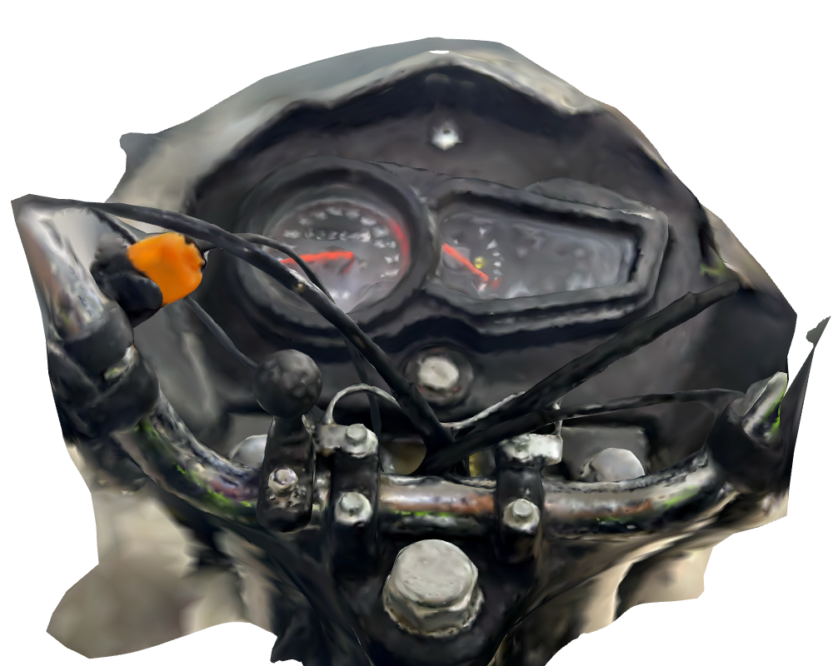
carcasa/vistas/esc_frente.png
