z-XOF-z/FT150TS/carcasa/vistas/esc_izq.png

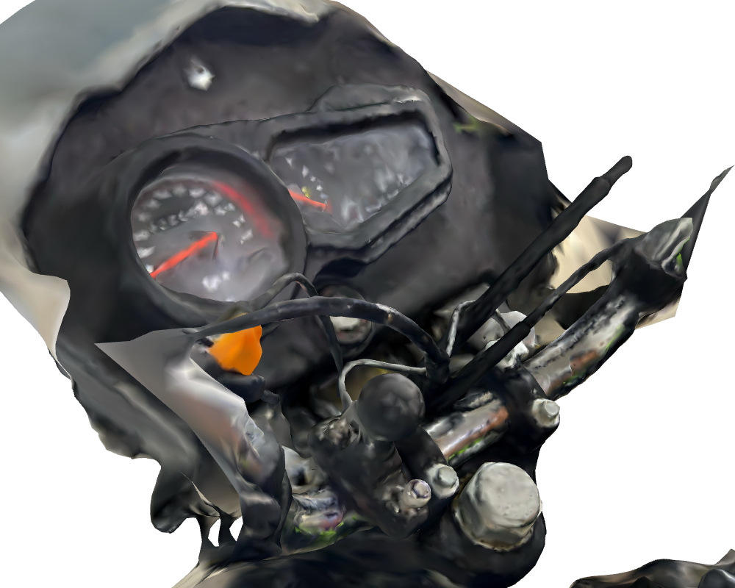
carcasa/vistas/esc_izq.png
