z-XOF-z/FT150TS/carcasa/vistas/escaneo_22-10.png

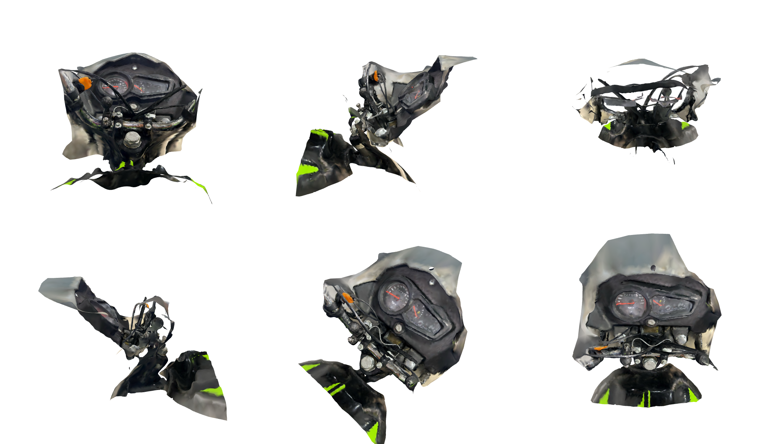
carcasa/vistas/escaneo_22-10.png
