z-XOF-z/FT150TS/carcasa/vistas/escaneo_con_carcasa.png

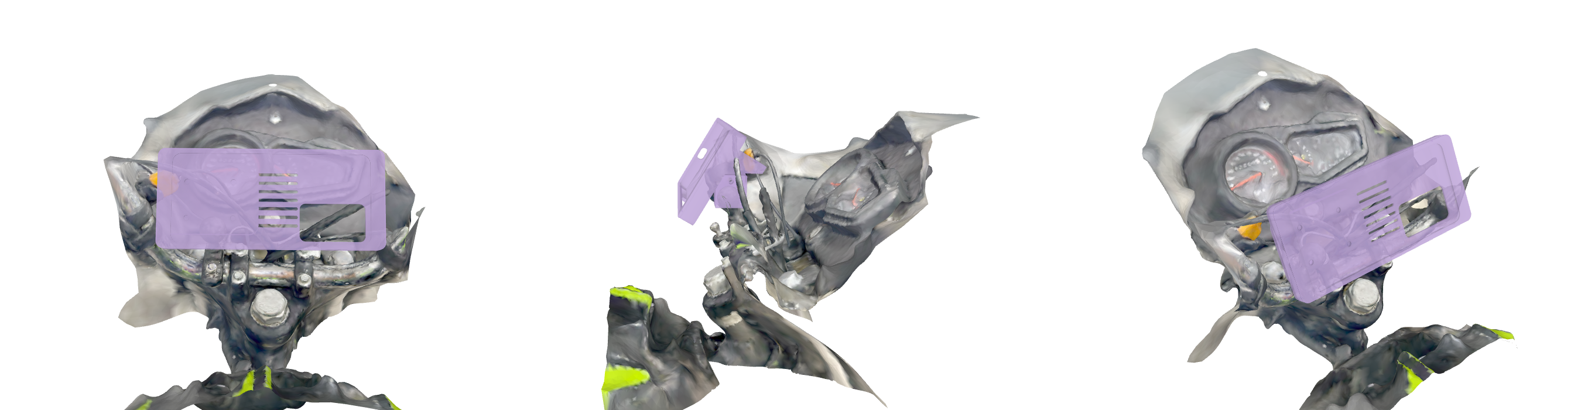
carcasa/vistas/escaneo_con_carcasa.png
