z-XOF-z/FT150TS/carcasa/vistas/piezas_por_color.png

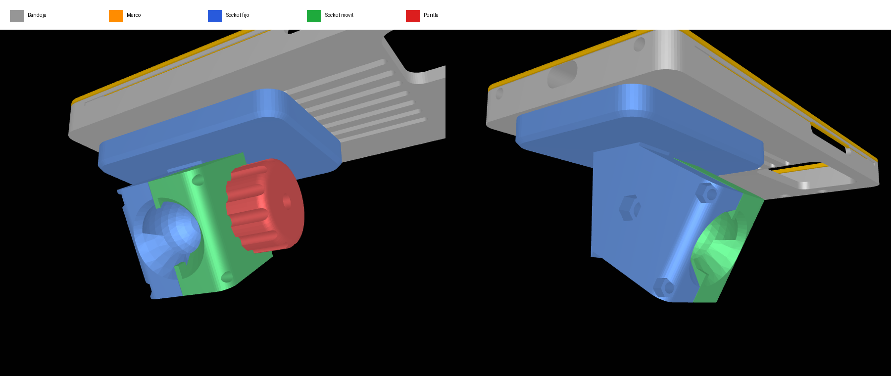
carcasa/vistas/piezas_por_color.png
