z-XOF-z/FT150TS/carcasa/vistas/ref_ball_mount.png

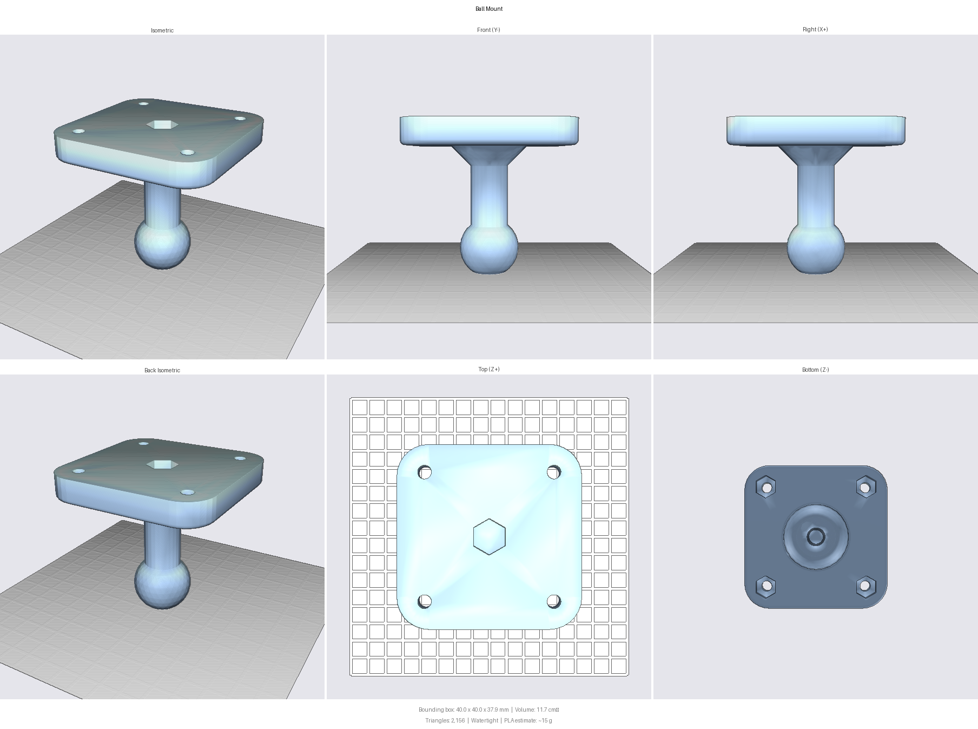
carcasa/vistas/ref_ball_mount.png
