z-XOF-z/FT150TS/carcasa/vistas/ref_bottom.png

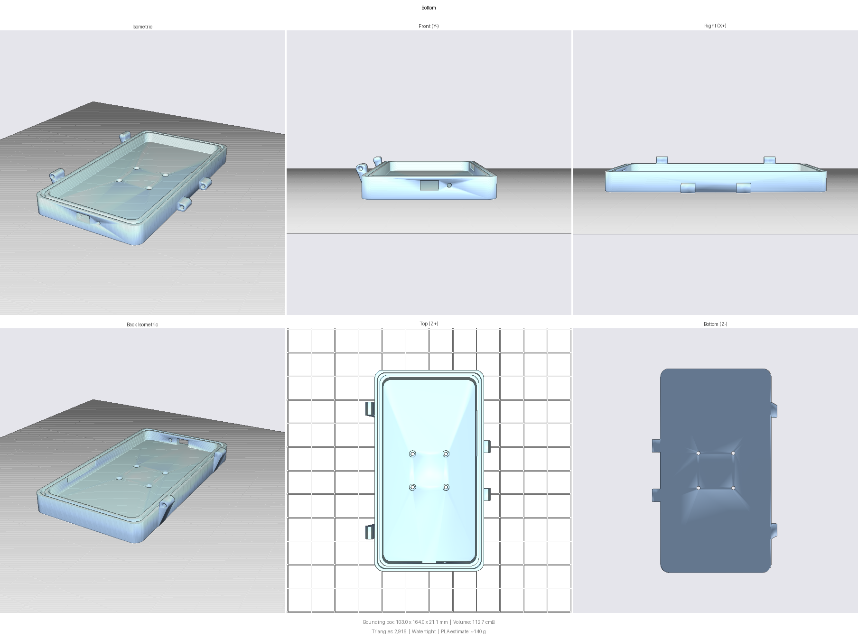
carcasa/vistas/ref_bottom.png
