z-XOF-z/FT150TS/carcasa/vistas/ref_latch.png

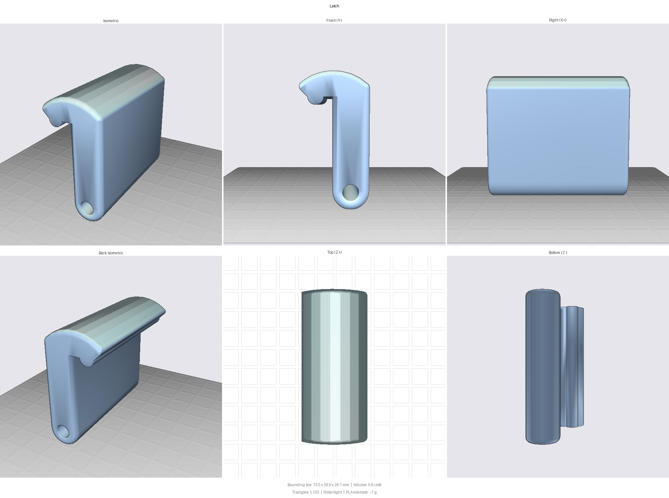
carcasa/vistas/ref_latch.png
