z-XOF-z/FT150TS/carcasa/vistas/revision_marco.png

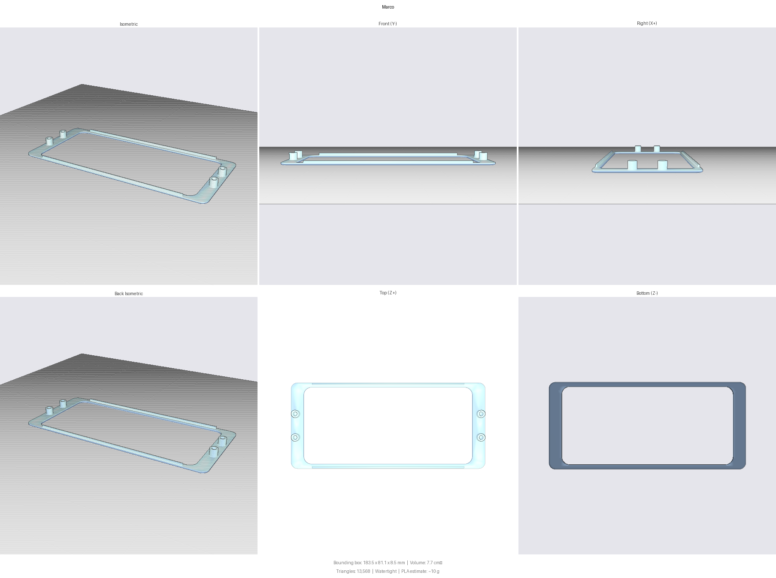
carcasa/vistas/revision_marco.png
