z-XOF-z/FT150TS/carcasa/vistas/revision_socket_movil.png

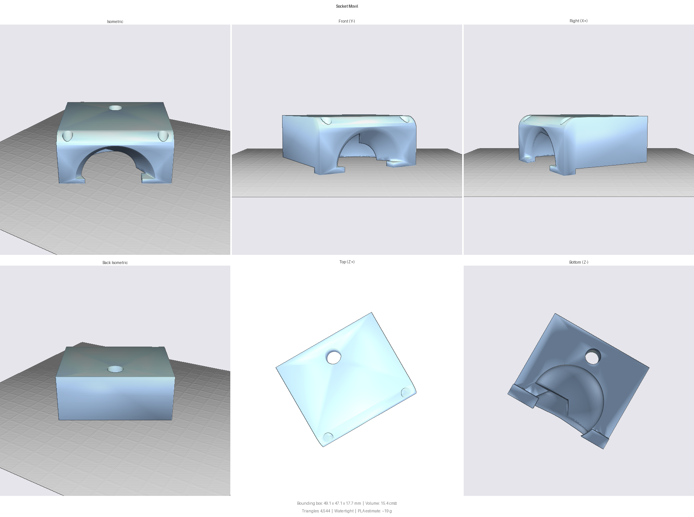
carcasa/vistas/revision_socket_movil.png
