z-XOF-z/FT150TS/carcasa/vistas/socket_fijo.png

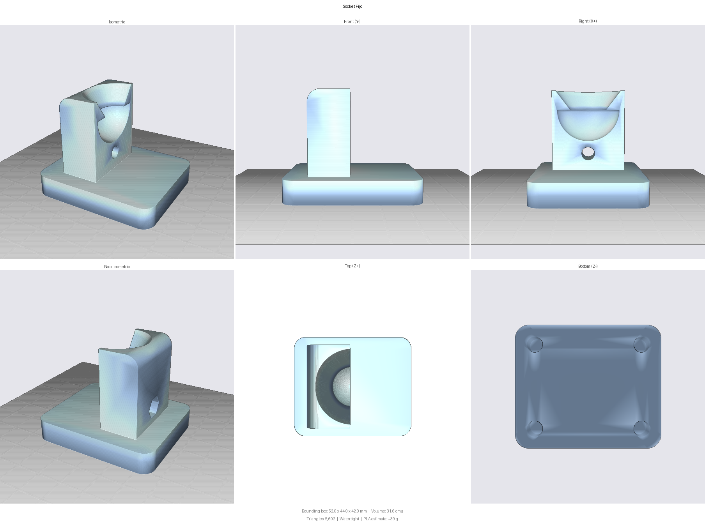
carcasa/vistas/socket_fijo.png
