z-XOF-z/FT150TS/carcasa/vistas/socket_movil.png

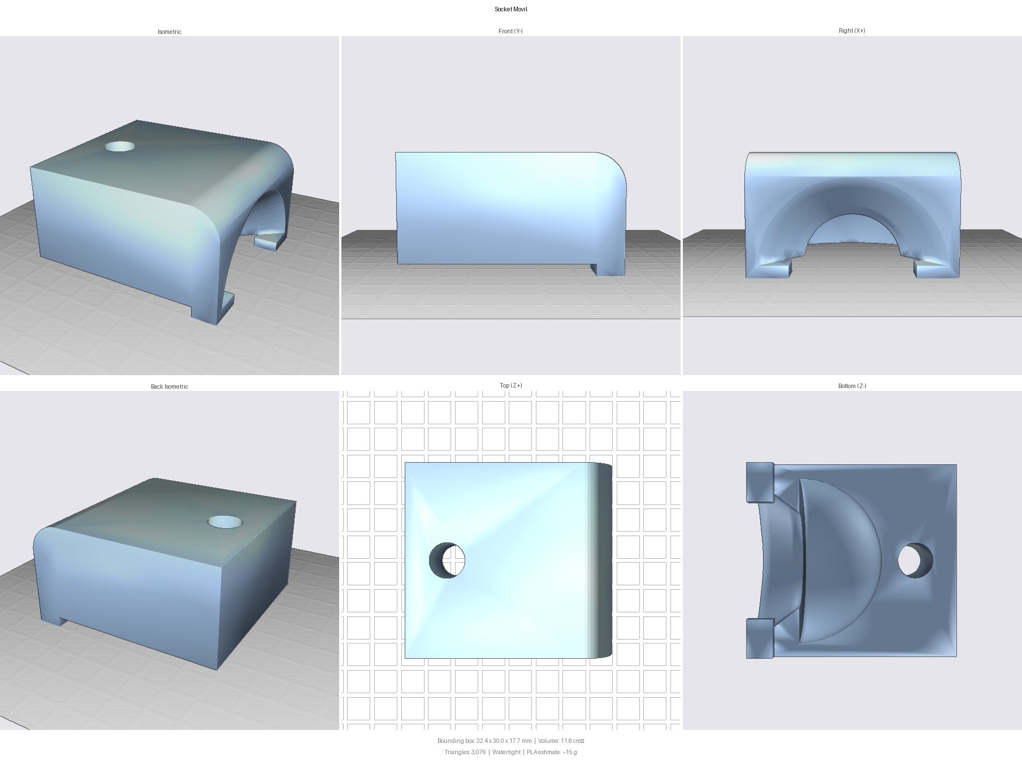
carcasa/vistas/socket_movil.png
