z-XOF-z/FT150TS/docs/social_preview.png

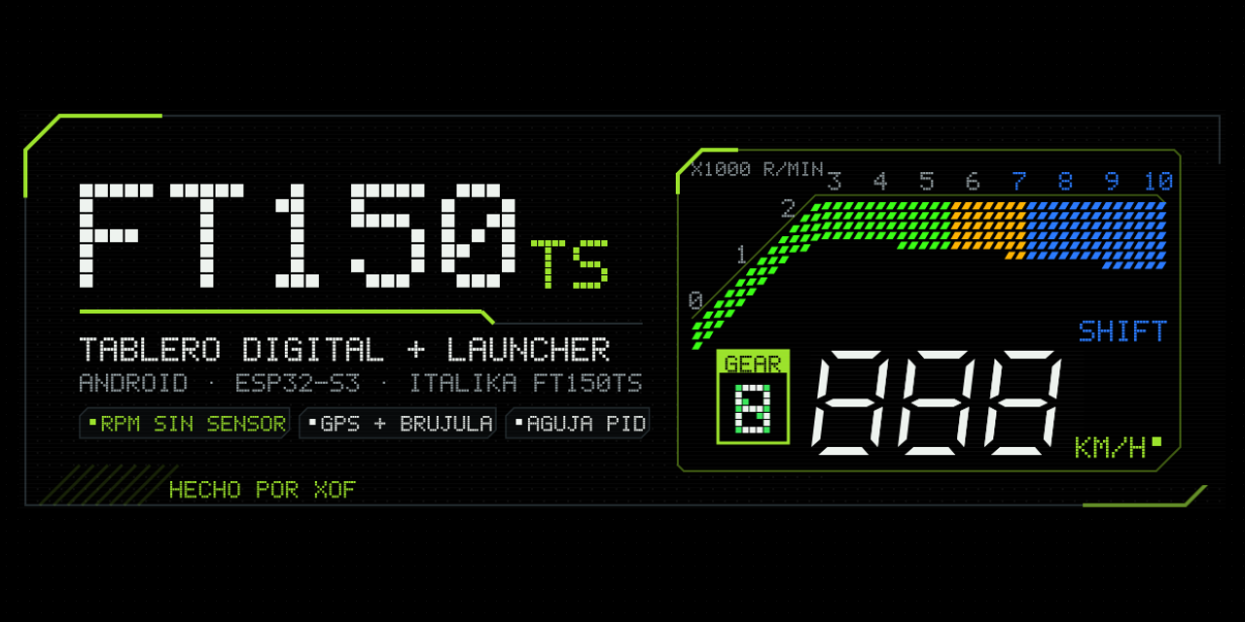
docs/social_preview.png
