z-XOF-z/FT150TS/docs/tablero_lcd_sport.png

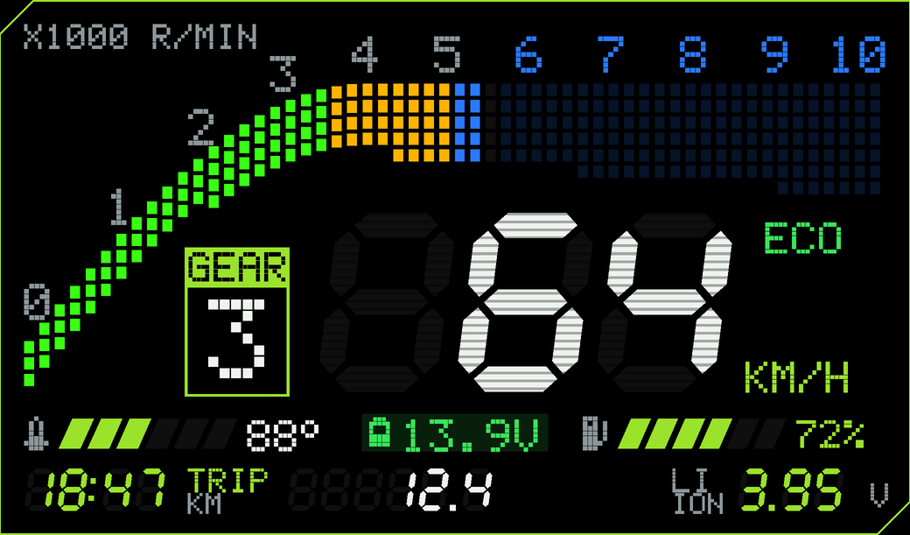
docs/tablero_lcd_sport.png
