z-XOF-z/FT150TS/llavero/carcasa/vista.png

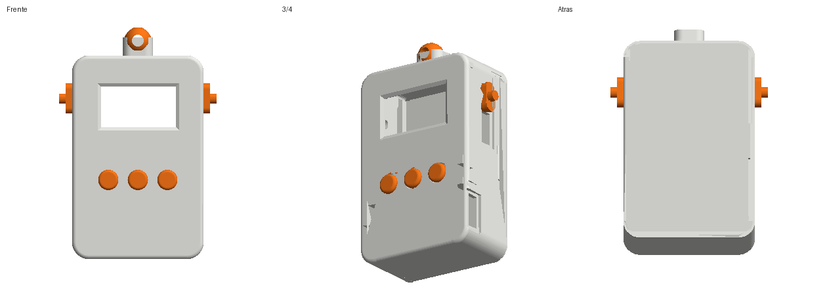
llavero/carcasa/vista.png
