z-XOF-z/FT150TS/llavero/pcb/barrenos.png

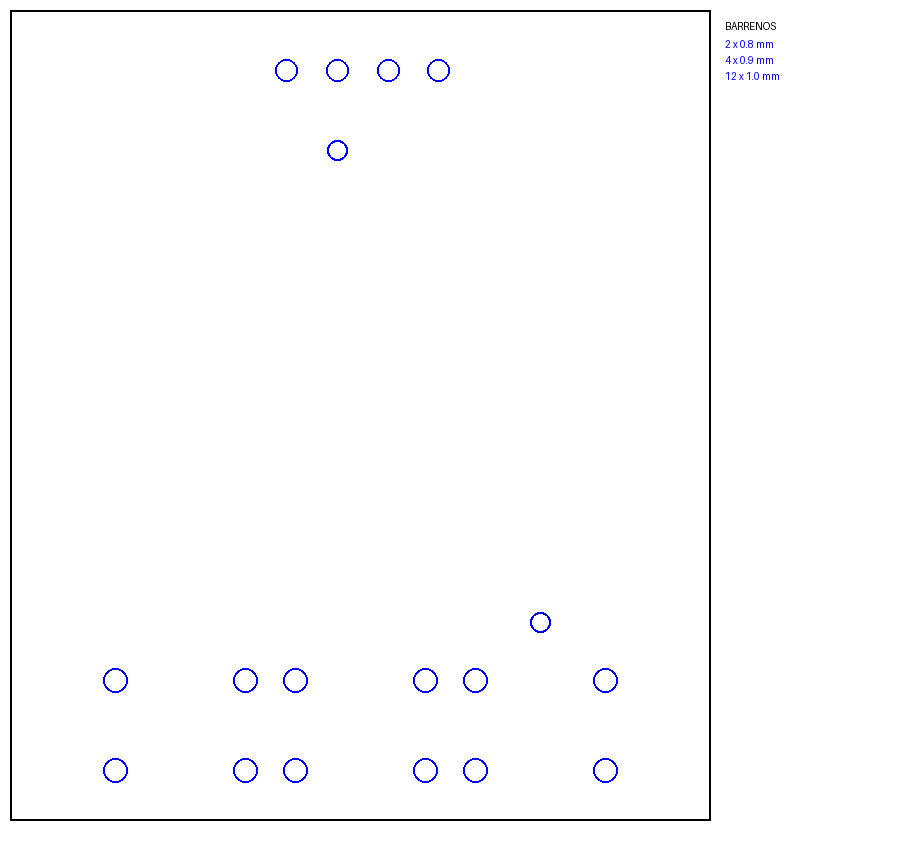
llavero/pcb/barrenos.png
