z-XOF-z/FT150TS/pcb/vista_A.png

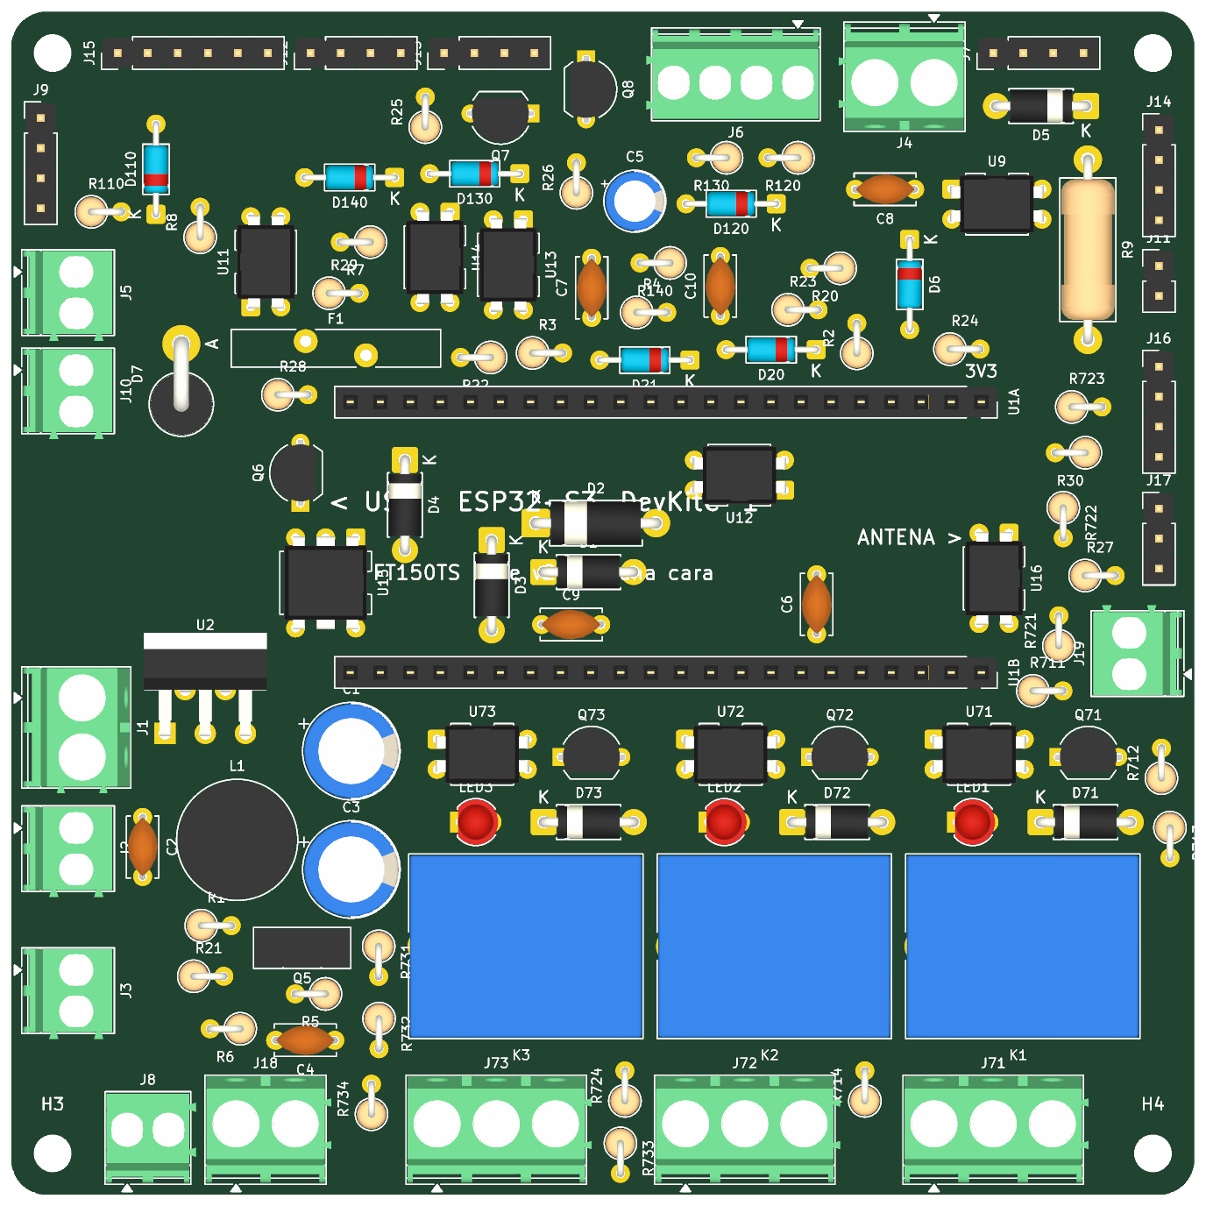
pcb/vista_A.png
