z-XOF-z/FT150TS/pcb/vista_abajo.png

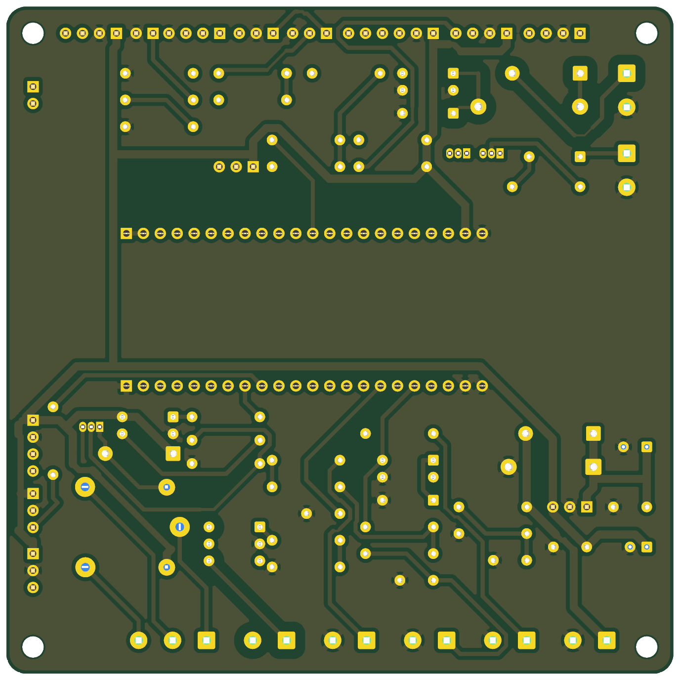
pcb/vista_abajo.png
