z-XOF-z/FT150TS/pcb/vista_arriba.png

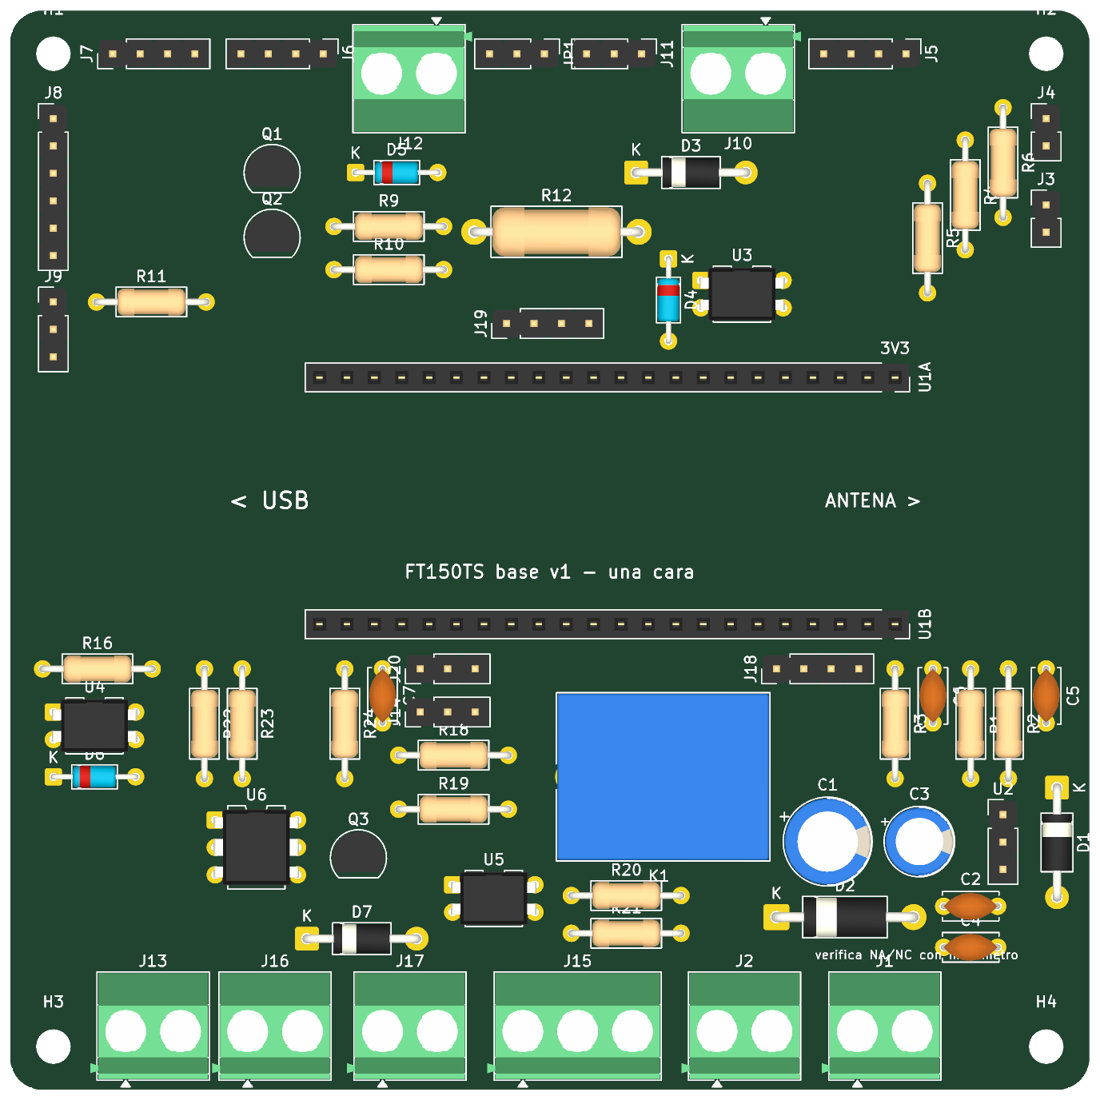
pcb/vista_arriba.png
