z-XOF-z/FT150TS/pcb/vista_B_v2c.png

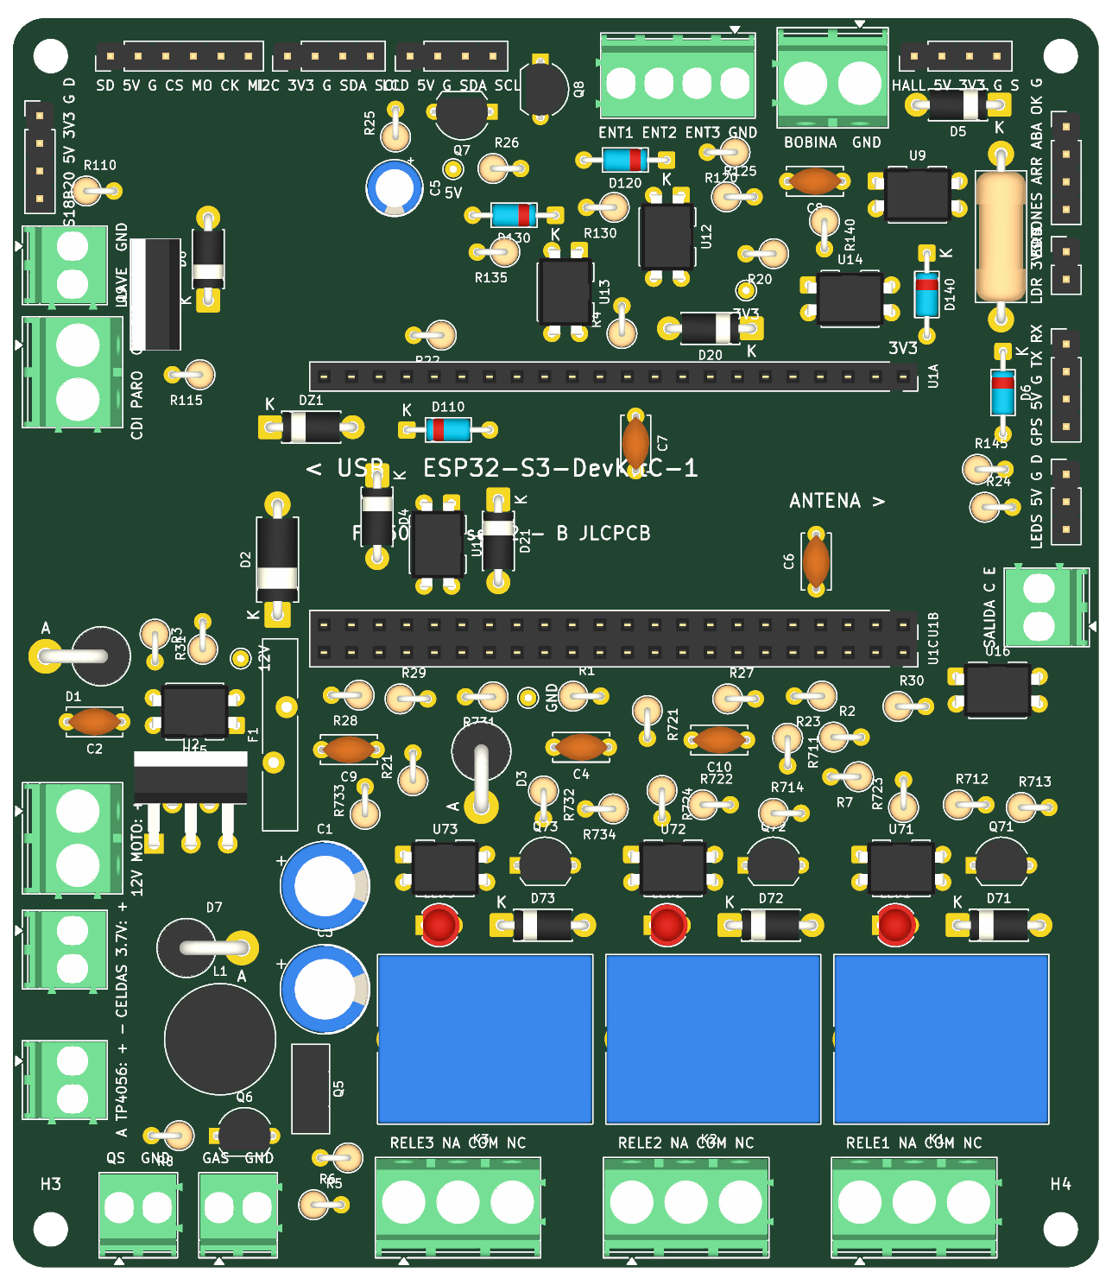
pcb/vista_B_v2c.png
