z-XOF-z/FT150TS/pcb/vista_C.png

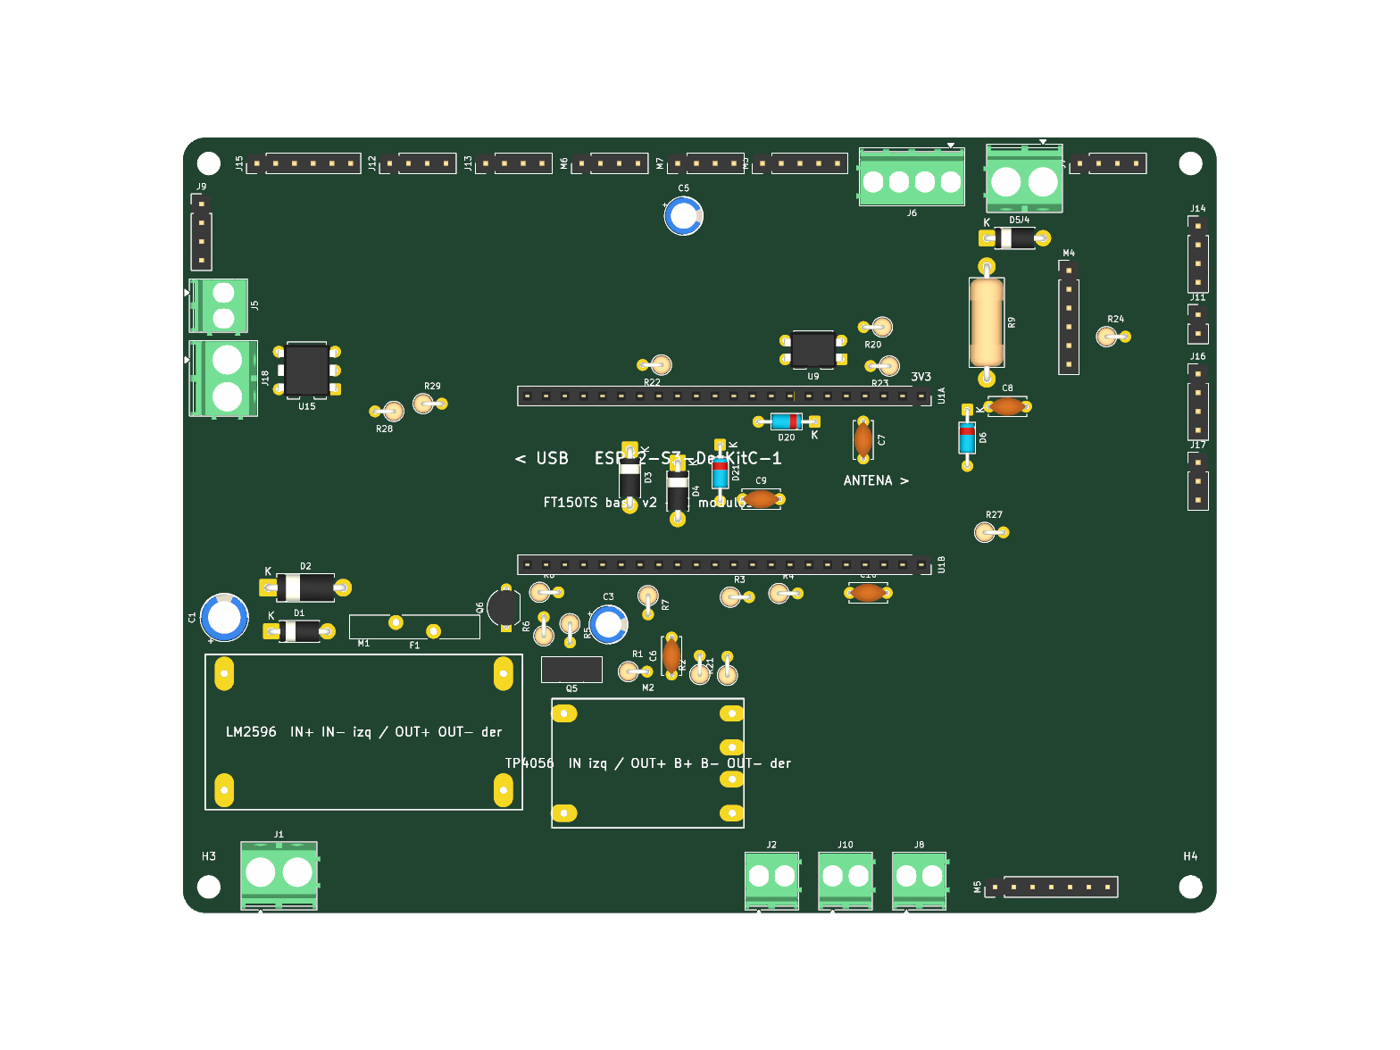
pcb/vista_C.png
