z-XOF-z/FT150TS/carcasa/caja_tablero/caja_ensamble.stl

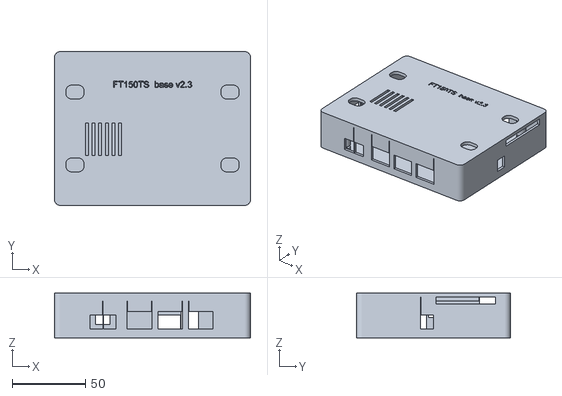
[picture p35: CAD file, 2026-11-08]
carcasa/caja_tablero/caja_ensamble.stl
134.0 x 105.2 x 30.6
