z-XOF-z/FT150TS/llavero/carcasa/stl/tamaxof_ensamble_con_piezas.stl

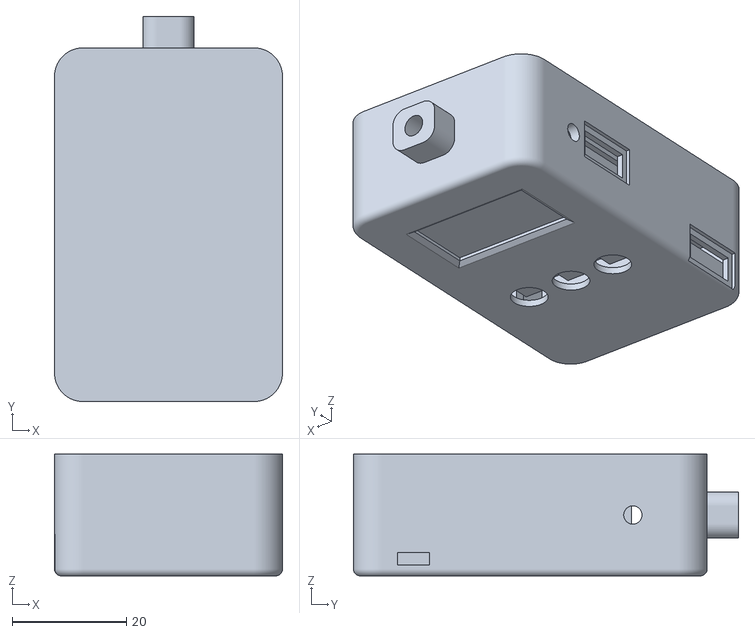
[picture p36: CAD file, 2026-11-08]
llavero/carcasa/stl/tamaxof_ensamble_con_piezas.stl
39.9 x 67.4 x 21.3
