z-XOF-z/FT150TS/carcasa/autocad/ensamble_completo.step

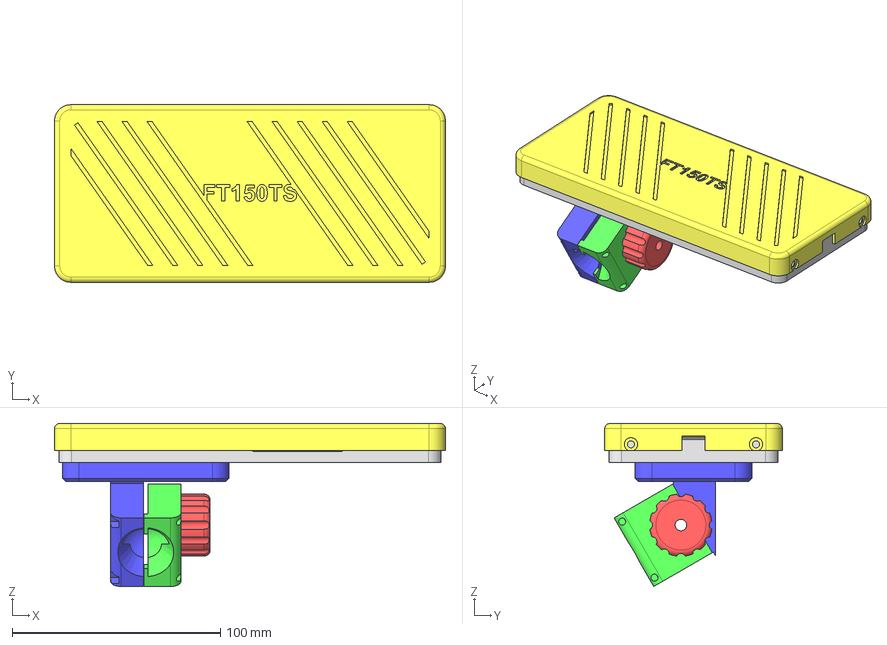
[picture p37: CAD file, 2026-10-26]
carcasa/autocad/ensamble_completo.step
187.6 x 85.2 x 78.2 mm
bandeja
marco
socket_fijo
socket_movil
perilla
tapa
