z-XOF-z/FT150TS/carcasa/caja_tablero/bateria_ensamble.stl

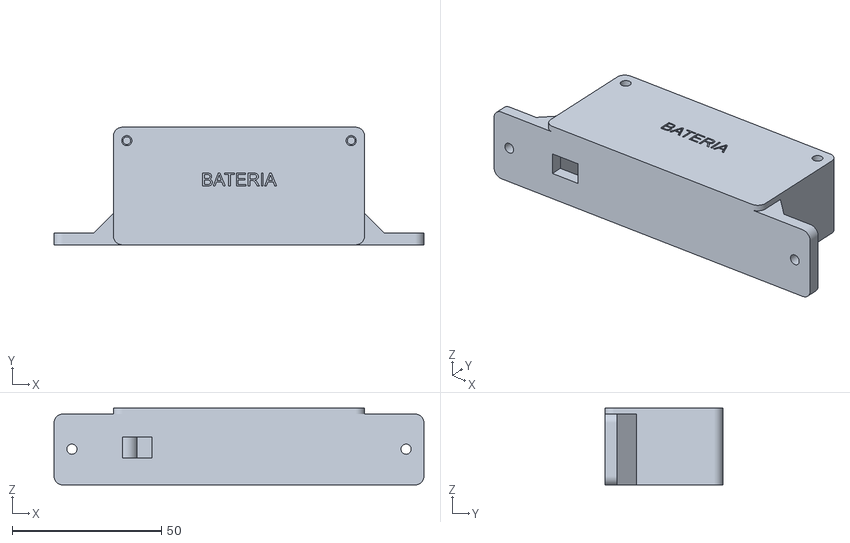
[picture p38: CAD file, 2026-10-26]
carcasa/caja_tablero/bateria_ensamble.stl
124.0 x 39.4 x 25.8
