z-XOF-z/FT150TS/carcasa/caja_tablero/ensamble_con_bateria.stl

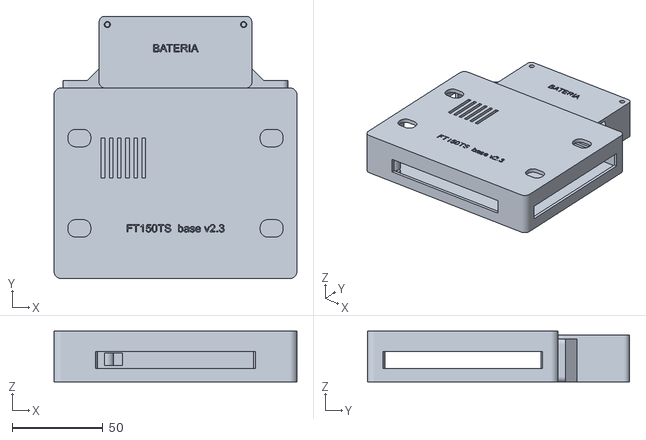
[picture p39: CAD file, 2026-10-26]
carcasa/caja_tablero/ensamble_con_bateria.stl
134.0 x 144.6 x 28.1
