z-XOF-z/FT150TS/carcasa/stl/ensamble_vista.stl

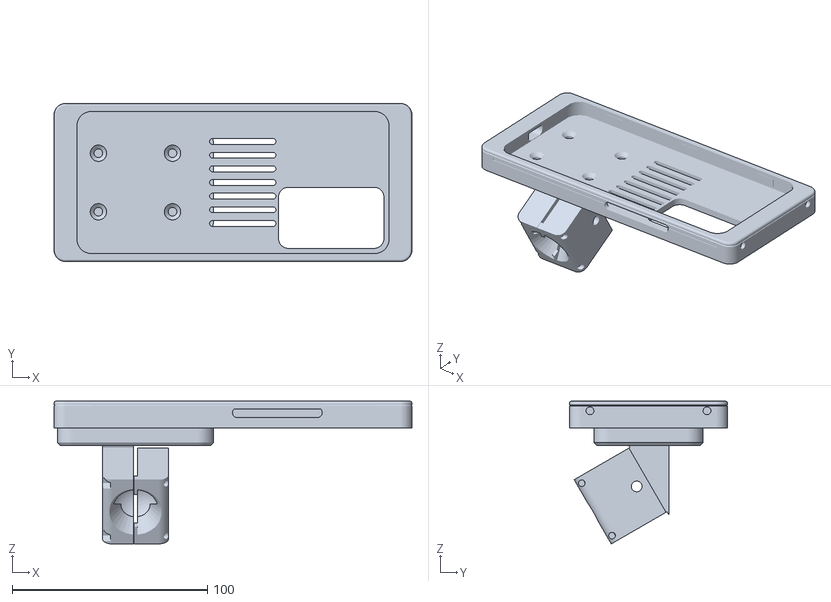
[picture p40: CAD file, 2026-10-26]
carcasa/stl/ensamble_vista.stl
183.5 x 81.1 x 73.2
