z-XOF-z/FT150TS/carcasa/stl/ensamble_con_tapa.stl

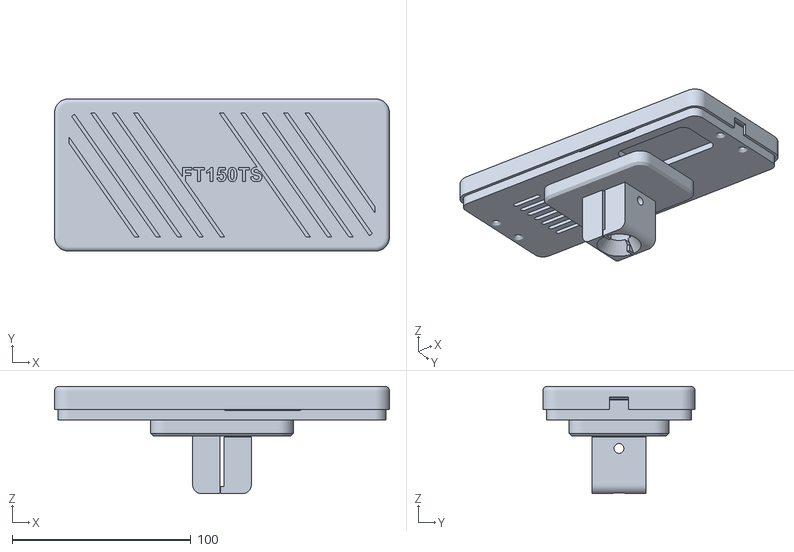
[picture p41: CAD file, 2026-10-26]
carcasa/stl/ensamble_con_tapa.stl
187.6 x 85.2 x 60.1
