z-XOF-z/FT150TS/carcasa/autocad/tapa.step

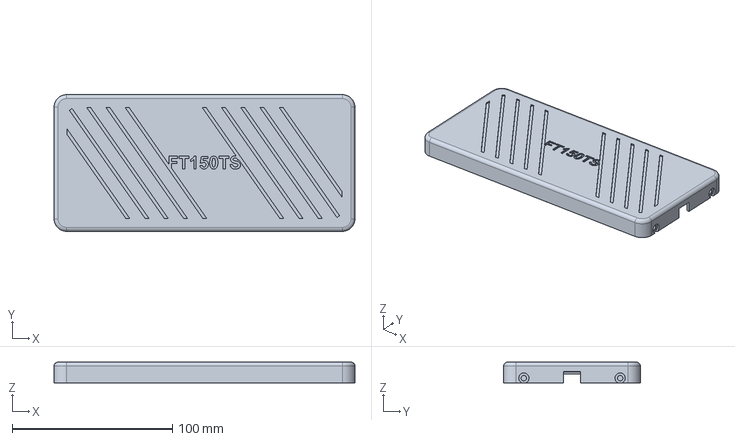
[picture p42: CAD file, 2026-10-26]
carcasa/autocad/tapa.step
187.6 x 85.2 x 13.0 mm
