z-XOF-z/FT150TS/carcasa/caja_tablero/caja_charola.step

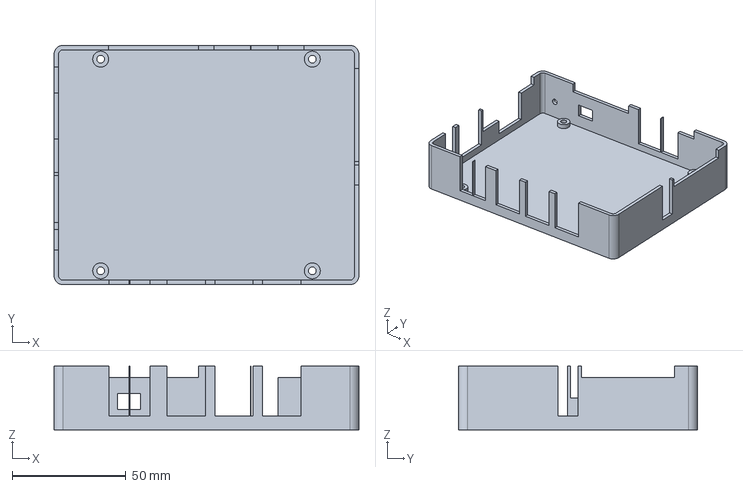
[picture p43: CAD file, 2026-11-08]
carcasa/caja_tablero/caja_charola.step
134.0 x 105.2 x 28.1 mm
