z-XOF-z/FT150TS/carcasa/stl/calibracion_05.stl

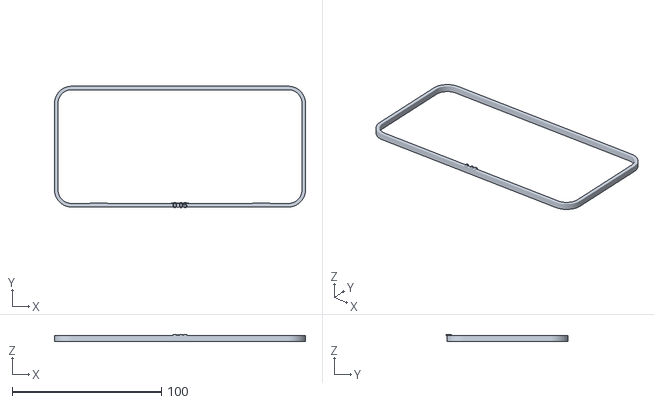
[picture p44: CAD file, 2026-10-26]
carcasa/stl/calibracion_05.stl
168.1 x 81.4 x 4.60
