z-XOF-z/FT150TS/llavero/carcasa/stl/tamaxof_tapa.step

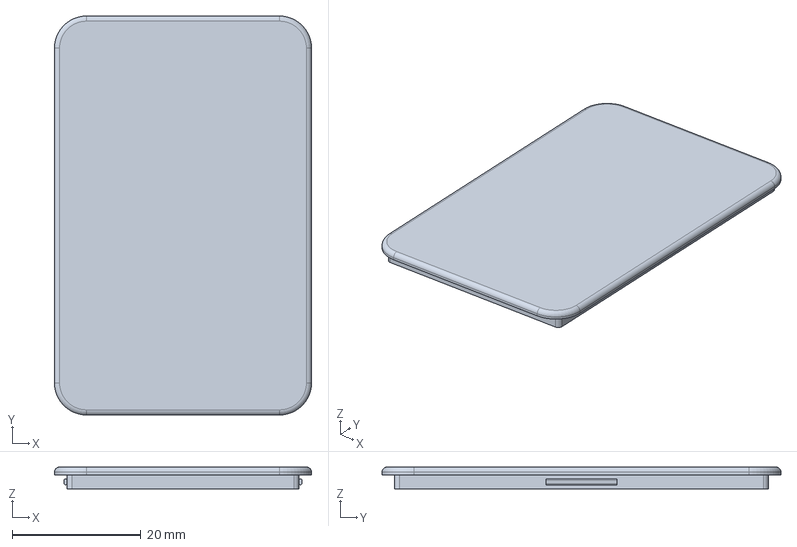
[picture p45: CAD file, 2026-11-08]
llavero/carcasa/stl/tamaxof_tapa.step
39.9 x 61.9 x 3.40 mm
