z-XOF-z/FT150TS/carcasa/autocad/socket_fijo.step

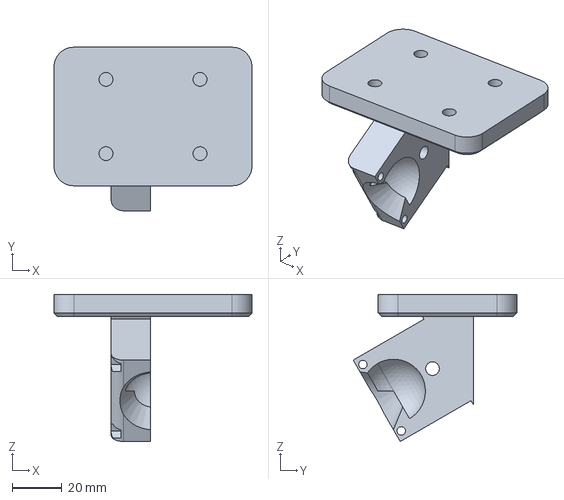
[picture p46: CAD file, 2026-10-26]
carcasa/autocad/socket_fijo.step
80.0 x 66.1 x 59.4 mm
