z-XOF-z/FT150TS/carcasa/stl/calibracion_25.stl

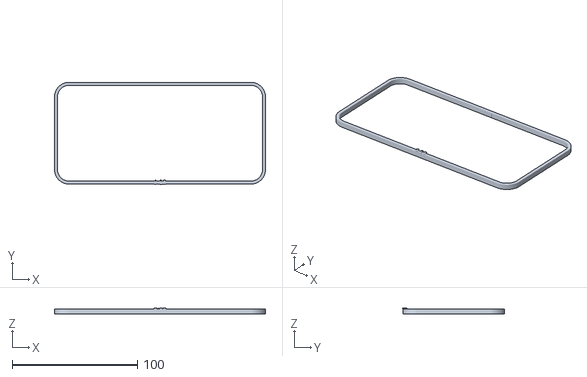
[picture p47: CAD file, 2026-10-26]
carcasa/stl/calibracion_25.stl
168.5 x 81.8 x 4.60
