z-XOF-z/FT150TS/carcasa/caja_tablero/cama_220_caja_ft150ts.stl

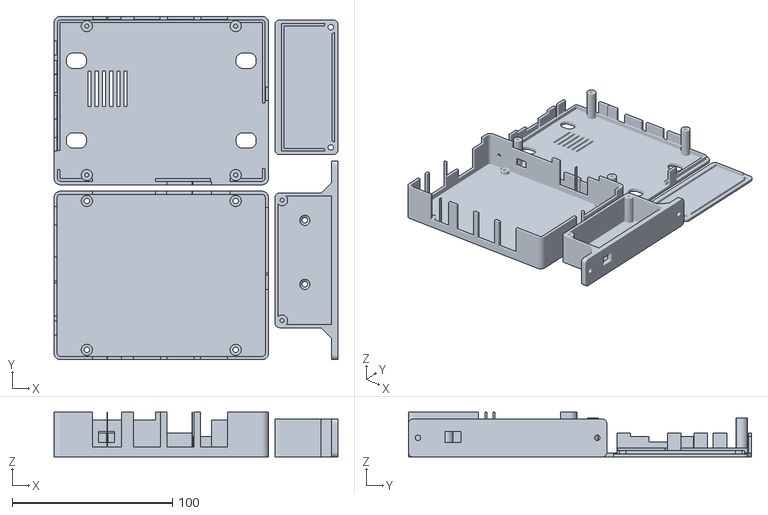
[picture p48: CAD file, 2026-11-08]
carcasa/caja_tablero/cama_220_caja_ft150ts.stl
177.4 x 214.4 x 28.1
