z-XOF-z/FT150TS/llavero/carcasa/stl/tamaxof_botones.step

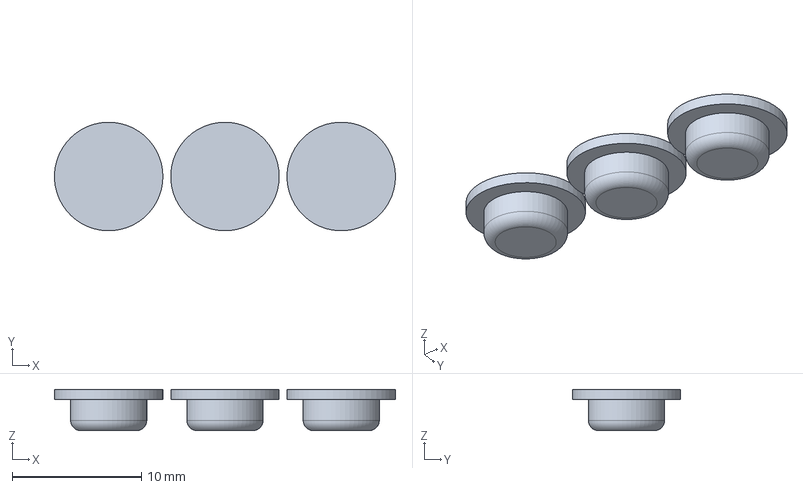
[picture p49: CAD file, 2026-11-08]
llavero/carcasa/stl/tamaxof_botones.step
26.4 x 8.40 x 3.20 mm
