z-XOF-z/FT150TS/carcasa/caja_tablero/caja_tapa.step

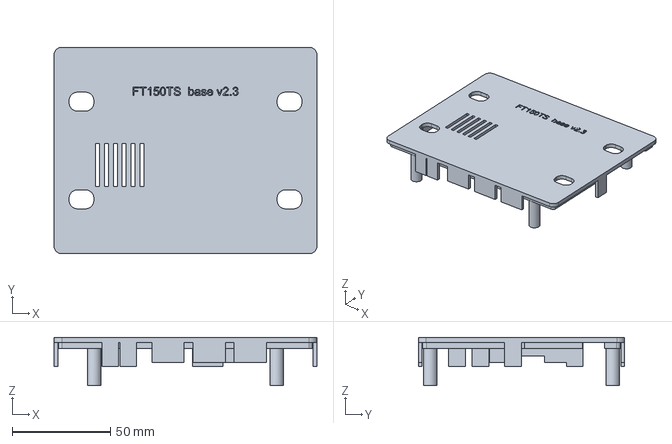
[picture p50: CAD file, 2026-11-08]
carcasa/caja_tablero/caja_tapa.step
134.0 x 105.2 x 24.5 mm
