z-XOF-z/FT150TS/llavero/carcasa/stl/tamaxof_bolita.step

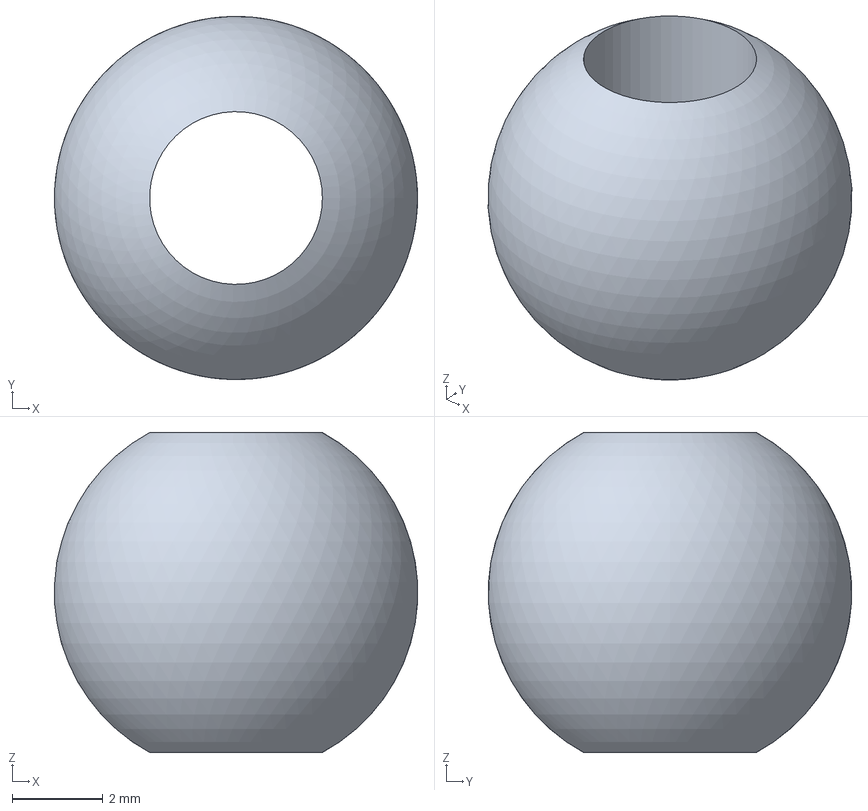
[picture p51: CAD file, 2026-11-08]
llavero/carcasa/stl/tamaxof_bolita.step
7.99 x 7.98 x 7.04 mm
