z-XOF-z/FT150TS/carcasa/caja_tablero/bateria_cuerpo.step

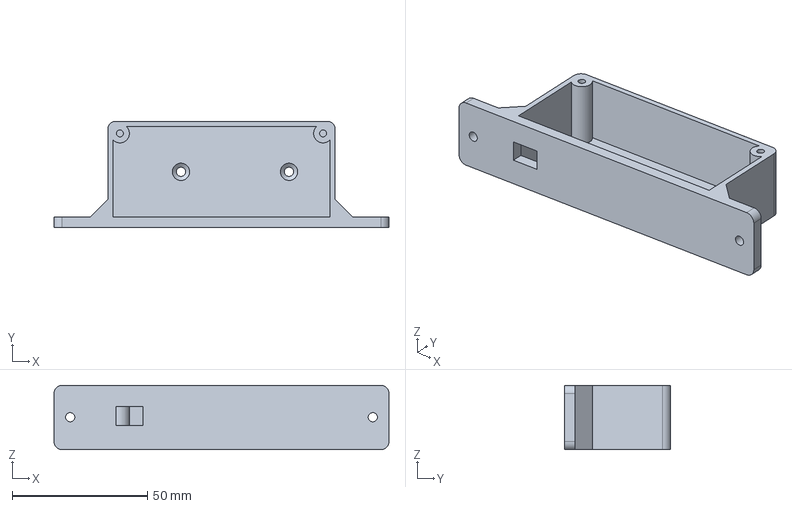
[picture p52: CAD file, 2026-10-26]
carcasa/caja_tablero/bateria_cuerpo.step
124.0 x 39.4 x 23.8 mm
