z-XOF-z/FT150TS/carcasa/stl/socket_movil.stl

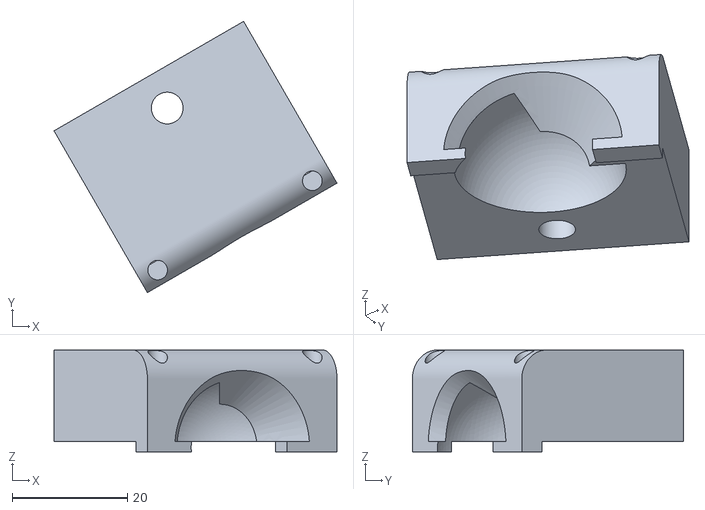
[picture p53: CAD file, 2026-10-26]
carcasa/stl/socket_movil.stl
49.1 x 47.1 x 17.7
