z-XOF-z/FT150TS/llavero/carcasa/stl/tamaxof_frente.step

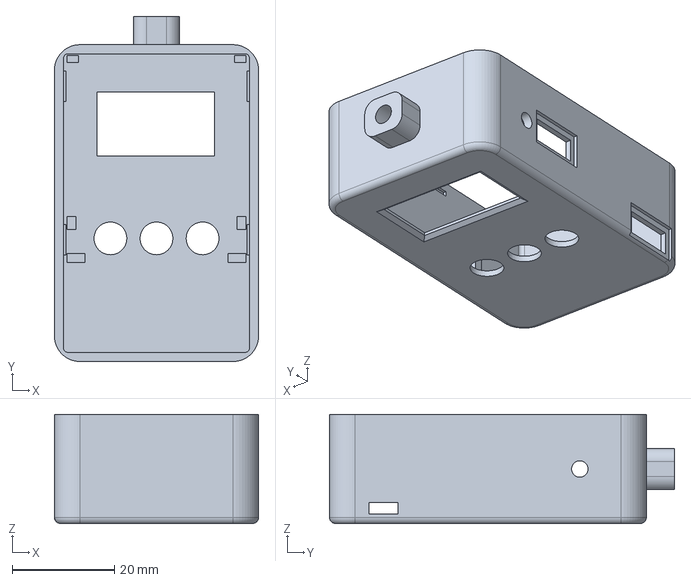
[picture p54: CAD file, 2026-11-08]
llavero/carcasa/stl/tamaxof_frente.step
39.9 x 67.4 x 21.3 mm
