z-XOF-z/FT150TS/carcasa/autocad/marco.step

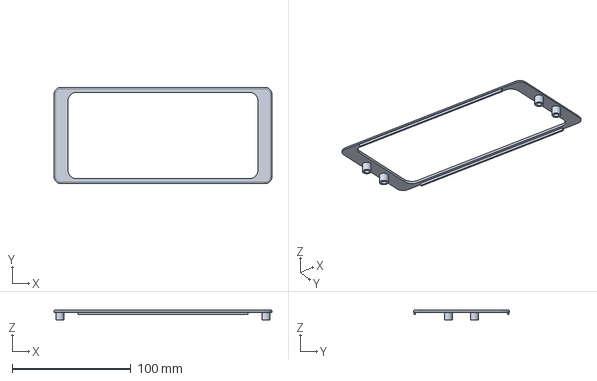
[picture p55: CAD file, 2026-10-26]
carcasa/autocad/marco.step
183.5 x 81.1 x 8.50 mm
