z-XOF-z/FT150TS/carcasa/stl/perilla.stl

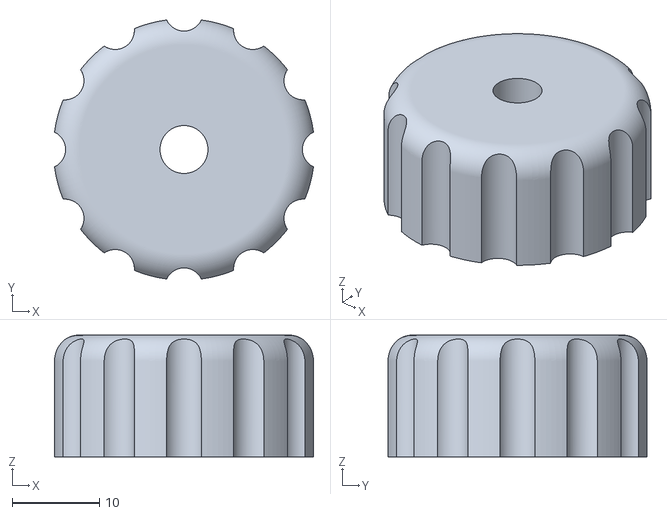
[picture p56: CAD file, 2026-10-26]
carcasa/stl/perilla.stl
29.7 x 29.7 x 14.0
