z-XOF-z/FT150TS/llavero/carcasa/stl/tamaxof_orejas.step

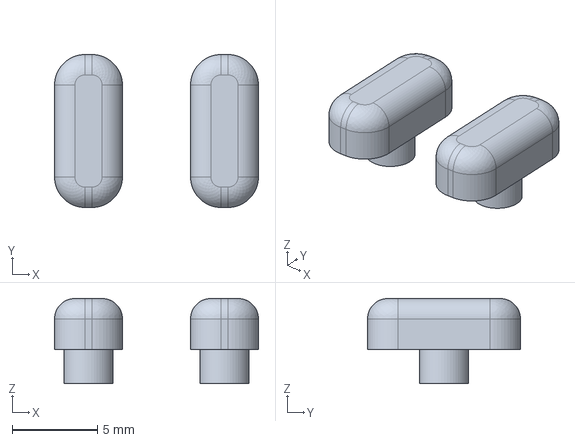
[picture p57: CAD file, 2026-11-08]
llavero/carcasa/stl/tamaxof_orejas.step
12.0 x 9.00 x 5.00 mm
