z-XOF-z/FT150TS/carcasa/stl/socket_armado_vista.stl

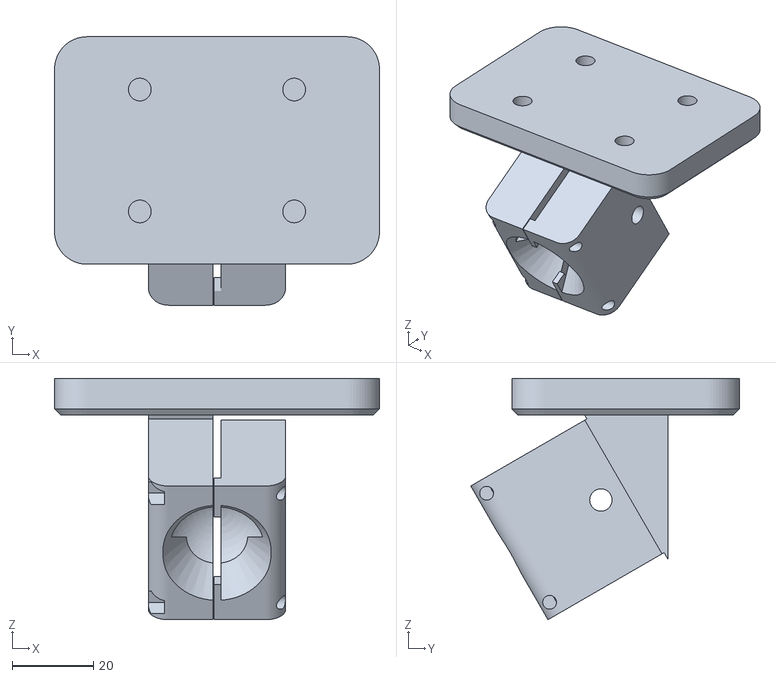
[picture p58: CAD file, 2026-10-26]
carcasa/stl/socket_armado_vista.stl
80.0 x 66.1 x 59.4
