z-XOF-z/FT150TS/carcasa/caja_tablero/bateria_tapa.step

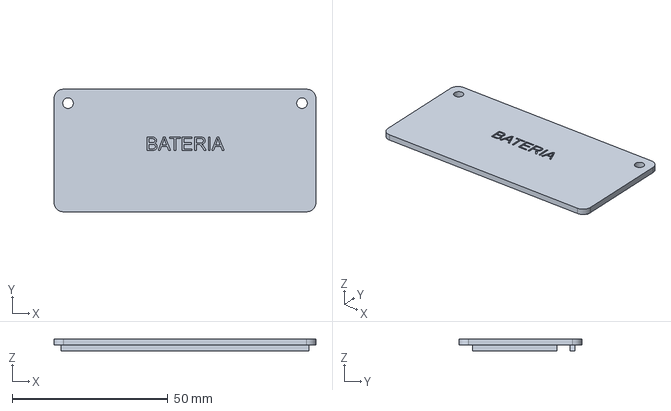
[picture p59: CAD file, 2026-10-26]
carcasa/caja_tablero/bateria_tapa.step
84.2 x 39.4 x 4.00 mm
