z-XOF-z/FT150TS/carcasa/stl/bandeja.stl

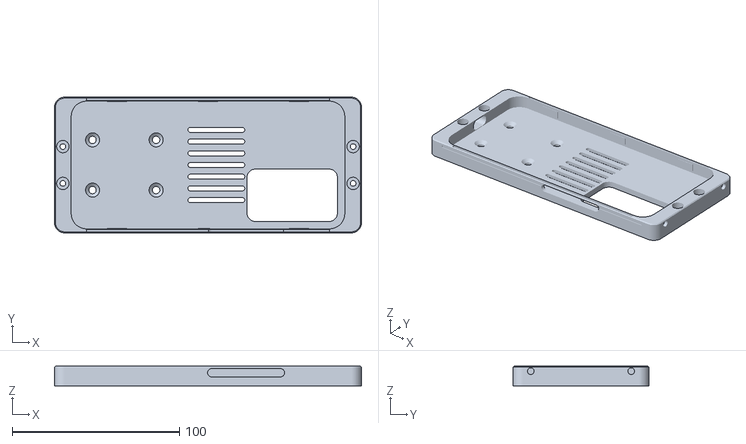
[picture p60: CAD file, 2026-10-26]
carcasa/stl/bandeja.stl
183.5 x 81.1 x 11.8
