z-XOF-z/FT150TS/(list of files, cad)

Other CAD files:
carcasa/autocad/calibracion_05.step
carcasa/stl/tapa.stl
carcasa/autocad/calibracion_15.step
carcasa/stl/calibracion_15.stl
carcasa/autocad/socket_movil.step
carcasa/autocad/perilla.step
carcasa/autocad/calibracion_25.step
carcasa/autocad/bandeja.step
carcasa/stl/marco.stl
carcasa/stl/socket_fijo.stl
carcasa/caja_tablero/bateria_cuerpo.stl
carcasa/caja_tablero/bateria_tapa.stl
carcasa/caja_tablero/caja_charola.stl
carcasa/caja_tablero/caja_charola_v4.stl
carcasa/caja_tablero/caja_tapa.stl
carcasa/caja_tablero/caja_tapa_v4.stl
llavero/carcasa/stl/tamaxof_bolita.stl
llavero/carcasa/stl/tamaxof_botones.stl
llavero/carcasa/stl/tamaxof_frente.stl
llavero/carcasa/stl/tamaxof_orejas.stl
llavero/carcasa/stl/tamaxof_tapa.stl
