z-XOF-z/FT150TS/pcb/guia_armado_B.html

FT150TS · placa base B v2.3 · 100 × 100 mm · 119 piezas

# Guía de armado

0 / 0 soldadas

pad pad cuadrado (pata 1, cátodo, +) pieza elegida ya soldada

Piezas encima Transparencia Serigrafía real Pistas de cobre ESP32 puesto

＋ － Acercar a la pieza Ver toda

Estas piezas solo funcionan en una posición. Revisa cada una contra el dibujo antes de soldar: al revés, no funcionan o se queman.

Pieza | Valor | Cómo va

Qué se conecta en cada bornera y tira. El pin 1 es siempre el pad cuadrado. Confirma cada cable de la moto con el multímetro antes de conectarlo: los colores cambian según el año.

Conector | Para qué | Pines (1 → último)

Lo básico para que cada soldadura quede bien. Las piezas de cada etapa ya están ordenadas de la más baja a la más alta: si las sueldas en ese orden, la placa se apoya sola en la mesa al voltearla.

1. Herramienta: cautín de 40–60 W (mejor con control, a 330–350 °C), estaño 60/40 o 63/37 de 0.8 mm con resina, pasta o pluma de flux, pinzas de corte, malla o chupón para desoldar y el multímetro.
2. Limpia la punta en la esponja húmeda o la lana de latón y ponle un poquito de estaño antes de empezar (que brille).
3. Mete la pieza por el lado de la serigrafía (la cara con letras), revisa el lado con el dibujo de esta guía y abre un poco las patas por abajo para que no se salga al voltear.
4. Calienta pad y pata a la vez 1–2 s, acerca el estaño al otro lado de la pata (no a la punta) y deja que corra solo. Quita el estaño y luego el cautín. En total 2–3 s; en patas gruesas (borneras, relevadores, L1, 1N5822) hasta 4–5 s.
5. Una buena soldadura es un cono brillante que cubre todo el pad. Si quedó una bola o se ve gris y rugosa, ponle flux y recaliéntala.
6. Corta las patas a ~1 mm sobre la soldadura, con la pinza de lado y tapando con el dedo (las patas salen volando).
7. Revisa puentes entre pads vecinos (sobre todo en las tiras del ESP32 y los PC817) con una lupa o la cámara del cel. Para quitar uno: flux y pasa el cautín limpio entre los pads, o usa la malla.
8. Al terminar cada etapa: limpia el flux con alcohol isopropílico y un cepillo de dientes, y haz la prueba de la etapa antes de seguir.
9. Antes de dar 12 V: con el multímetro en continuidad, revisa que TP1–TP4 (12V, 5V, 3V3) no estén en corto con GND.

Lo máximo que aguanta cada entrada y salida. "Normal" es para usarlo todo el día; pasarse del máximo quema la pieza. Antes de conectar, mide cada cable de la moto con el multímetro: con la llave puesta y quitada, y con el motor prendido.

### Placa B: alimentación

Conector | Normal | Máximo | Notas
J1 BAT MOTO 12V | 11 – 14.8 V | 16 V seguido · picos hasta ~22 V | El PTC de 2 A corta en un corto y se rearma solo. El 1N5822 protege si inviertes los cables. El TVS P6KE22A se come los picos del arranque. La placa gasta 0.3 – 1 A.
5 V interno (LM2596) | hasta 1.5 A | 2 A (3 A con disipador) | Reparte así: ESP32 0.25 A, LCD 0.1, GPS 0.05, relevadores 0.07 c/u, LEDs WS2812 hasta 0.06 A c/u. Con 16 LEDs a blanco total ya son 1 A: deja el brillo en la mitad.
J2 BATERIA 3.7V | 3.0 – 4.2 V | 4.2 V | Una celda 18650, o varias en paralelo con su BMS. Nunca en serie (8.4 V quema el ESP32).
J3 CARGADOR 5V | 5 V, 1 A | 1 A | Va a IN+/IN- del TP4056. El BD140 aguanta 1.5 A. No le conectes otra cosa.

### Placa B: entradas

Conector | Normal | Máximo | Notas
LLAVE y J6 ENT1-3 | 3.3 – 14.8 V | 18 V seguido | Aisladas con PC817 (1.5k + 2.2k): detectan desde ~1.9 V y consumen ~10 mA a 12 V. Arriba de 18 V la resistencia de 1.5k se calienta de más.
J4 BOBINA | pulsos del primario | ~400 V en pulsos | Solo el cable que va del CDI a la bobina (no el de la bujía). La 47k de 1 W y el 1N4007 bajan el pulso.
J7 HALL · J8 QS | señal de 3.3 o 5 V | 5.5 V | Llevan 2.2k + Schottky: aceptan colector abierto. La tira da 5 V y 3V3 para el sensor; del 3V3 no saques más de ~100 mA en total.
J9 DS18B20 | 3.3 V | 3.6 V en el dato | Pull-up de 4.7k a 3.3 V. Cable de hasta ~5 m.
J10 GASOLINA | flotador a tierra | 0 V externos | La placa le pone 3.3 V por la R23. Nunca le llegue voltaje de la moto: lee abajo "Medidor de gasolina".
J11 · J12 I2C 3V3 | lógica de 3.3 V | 3.6 V | J11 = INT del MPU (GPIO5). J12: RTC, MPU y placa E. Cable I2C de menos de 50 cm.

### Placa B: salidas

Conector | Normal | Máximo | Notas
J71-J73 RELE 1-3 | hasta 3 A, 12 V | 3 A (la pista; el relevador dice 10 A) | Contacto seco NA / COM / NC (SRD-05VDC). Para algo de más de 3 A (claxon de aire, faros extra), úsalo para prender un relevador automotriz de 30/40 A.
J18 CDI PARO | solo el cable de paro | 500 V / 8 A (IRF840) | Únicamente el cable que apaga el motor (el del switch de paro). Sin señal la moto sigue normal.
J19 SALIDA AISLADA | hasta 30 mA | 50 mA · 30 V | Transistor del PC817, colector abierto: C al negativo de lo que quieras prender y E a tierra. Si es una bobina, ponle un 1N4007 en paralelo.
J13 · J16 · J17 (5 V) | LCD · GPS · LEDs | ver los 2 A del LM2596 | LEDs WS2812: hasta 16 a medio brillo sin problema.

### Placa E (expansión I2C)

Conector | Normal | Máximo | Notas
12V MOTO | 11 – 14.8 V | 16 V | Solo alimenta las bobinas de los relevadores (30 mA c/u). Tiene diodo contra polaridad invertida. Fusible de 1 A en el cable.
BOMBA (BAT+ MOT+ MOT- BAT-) | hasta 3 A | 5 A con fusible de 5 A | Pistas de 3 mm y diodo 1N5408. Un inflador de auto jala 8 – 15 A: no lo conectes directo, mira abajo.
RELE2 · RELE3 | hasta 3 A, 12 V | 3 A | NA / COM / NC, como en la placa B.
SAL (C E) | hasta 30 mA | 50 mA · 30 V | Igual que J19.
IN1-IN4 | 3.3 – 14.8 V | 18 V | Aisladas. En el firmware se eligen en FUNCION_E (libre, freno, direccional).
I2C ENTRADA | 3V3 GND SDA SCL | 3.6 V | Del J12 de la placa B. Dirección 0x20: sin puentes en A0-A2.

### Inflador (BOMBA) bien conectado

1. Mide cuánto jala tu inflador: la etiqueta dice watts o amperes (watts ÷ 12 = amperes). Los de auto jalan 8 – 15 A; los mini de bicicleta, 3 – 5 A.
2. Hasta 4 A: directo a la bornera BOMBA: BAT+ al positivo de la batería con fusible de 5 A, MOT+ y MOT- al inflador, BAT- a tierra.
3. Más de 4 A: usa la bornera BOMBA solo para prender un relevador automotriz de 30/40 A (de 4 o 5 patas, se consigue en refaccionarias y Steren): MOT+ a la pata 86 y MOT- a la 85. La 30 va a la batería con un fusible de 15 A, y la 87 al inflador.
4. Infla con el motor prendido: el estator de una 150 da poco, y con el motor apagado un inflador de 10 A deja la batería muerta en minutos. Por eso la tarjeta no arranca la BOMBA con la batería abajo de 11.8 V.
5. El firmware la apaga sola: al terminar el tiempo, a los 10 min (luego descansa 5), si la moto se mueve o si la batería baja de 10.5 V.

### Medidor de gasolina (J10)

El flotador del tanque es una resistencia variable a tierra: cambia de valor según el nivel. La placa le pone 3.3 V por la R23 y lee el voltaje que queda (GPIO2).

1. Mide tu flotador. Desconecta su conector y pon el multímetro en ohms entre el cable de señal y tierra. Anota el valor con el tanque casi vacío y otra vez recién llenado (o saca el flotador y muévelo de tope a tope). En motos chinas e Italika suele estar entre ~10 Ω y ~100 – 250 Ω; según el modelo, el valor alto puede ser vacío o lleno.
2. Escoge la R23 cerca de la raíz de (mínimo × máximo), sin bajar de 150 Ω para no calentar el flotador (que no pase de 20 mA). Ejemplos: 10 – 100 Ω → 150 Ω; 30 – 250 Ω → 150 Ω; 100 – 1000 Ω → 330 Ω. Con la de 1k de fábrica, un flotador de 10 – 100 Ω casi no se mueve.
3. ¿Quieres seguir usando la aguja original? Entonces el cable del flotador ya trae voltaje del tablero de la moto: no lo conectes directo a J10, porque podría meterle hasta 12 V al ESP32. En ese caso quita la R23 y pon un divisor (10k del cable a GPIO2 y 3.3k de GPIO2 a tierra). Así lees el voltaje que ya pone el tablero, hasta 13 V → 3.2 V.
4. Calibra: con el tanque vacío manda cal gas vacio, y lleno, cal gas lleno (desde la consola de la app). La tarjeta guarda los dos y sola sabe cuál es vacío y cuál lleno.
5. Si marca "falla" (abajo de 80 mV o arriba de 3.2 V): cable suelto o flotador abierto.

Referencias de valores medidos en otros flotadores: Fazer Owners Club (https://foc-u.co.uk/mybb/printthread.php?tid=78483), Polaris (https://sites.google.com/view/polaris-pwc-knowledge/Home/electrical/fuel-and-oil-level-senders), For A-Bodies Only (https://www.forabodiesonly.com/mopar/threads/fuel-level-sender-resistance.601753/). Siempre manda tu medición.
