z-XOF-z/FT150TS/carcasa/caja_tablero/vista_ensamble.png

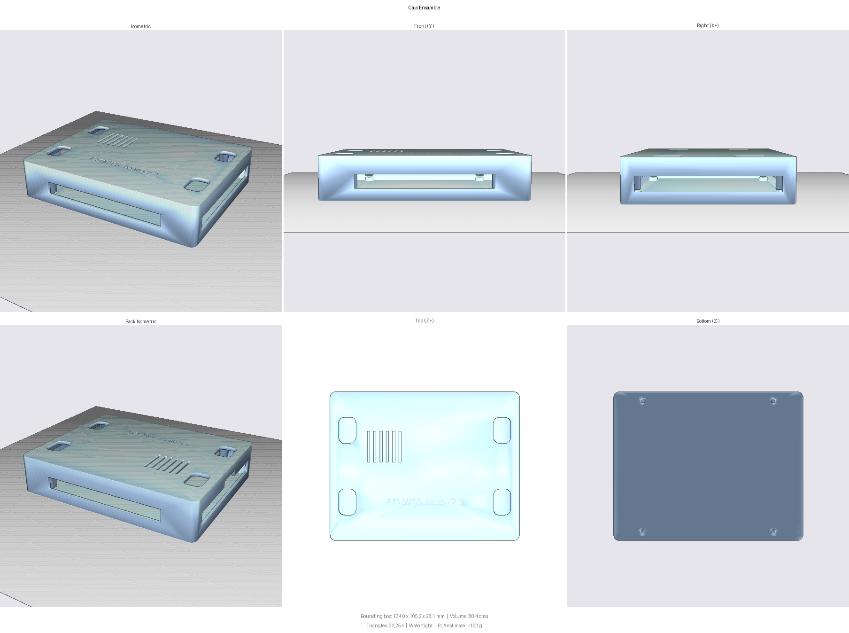
carcasa/caja_tablero/vista_ensamble.png
