z-XOF-z/FT150TS/carcasa/vistas/ensamble_con_tapa.png

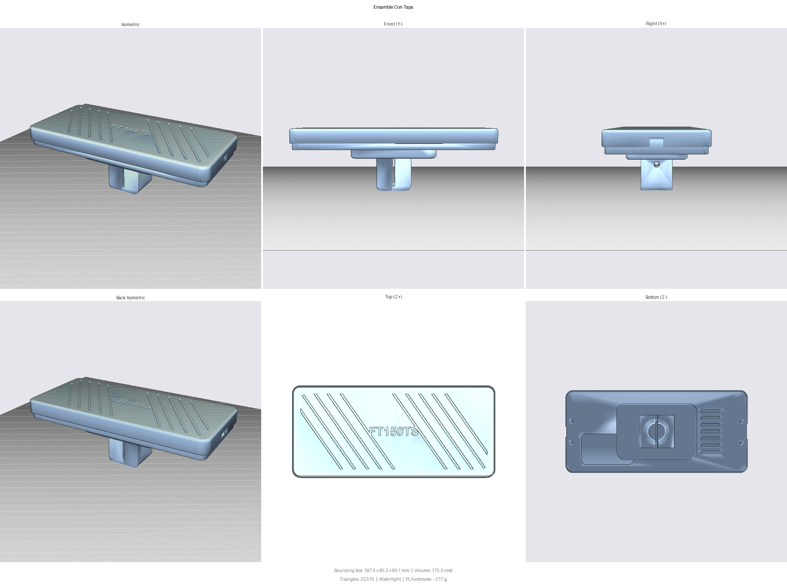
carcasa/vistas/ensamble_con_tapa.png
