z-XOF-z/FT150TS/carcasa/vistas/ensamble_vista.png

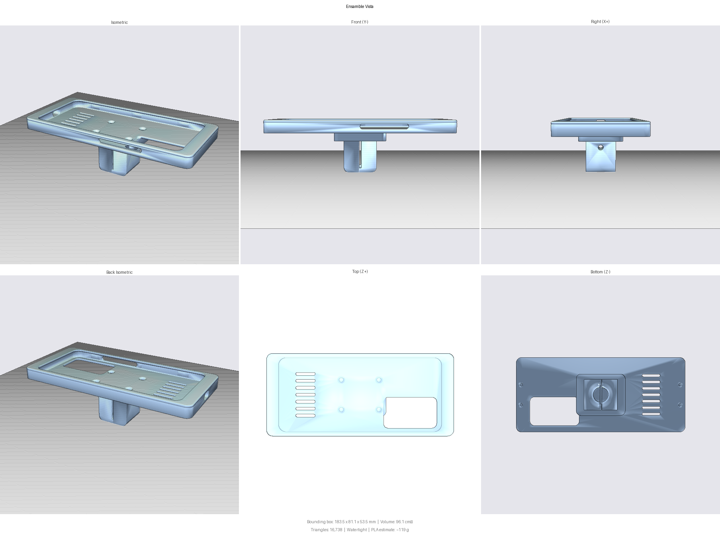
carcasa/vistas/ensamble_vista.png
