z-XOF-z/FT150TS/carcasa/vistas/socket_armado.png

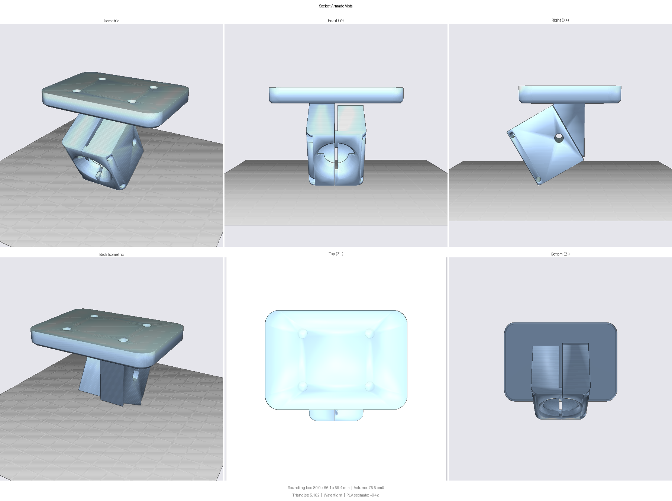
carcasa/vistas/socket_armado.png
