z-XOF-z/FT150TS/llavero/pcb/armado.png

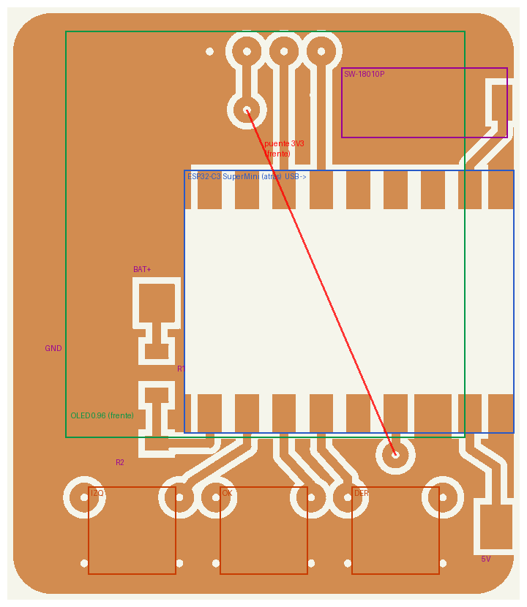
llavero/pcb/armado.png
