z-XOF-z/FT150TS/pcb/fabricar/B_JLCPCB/B_bottom.png

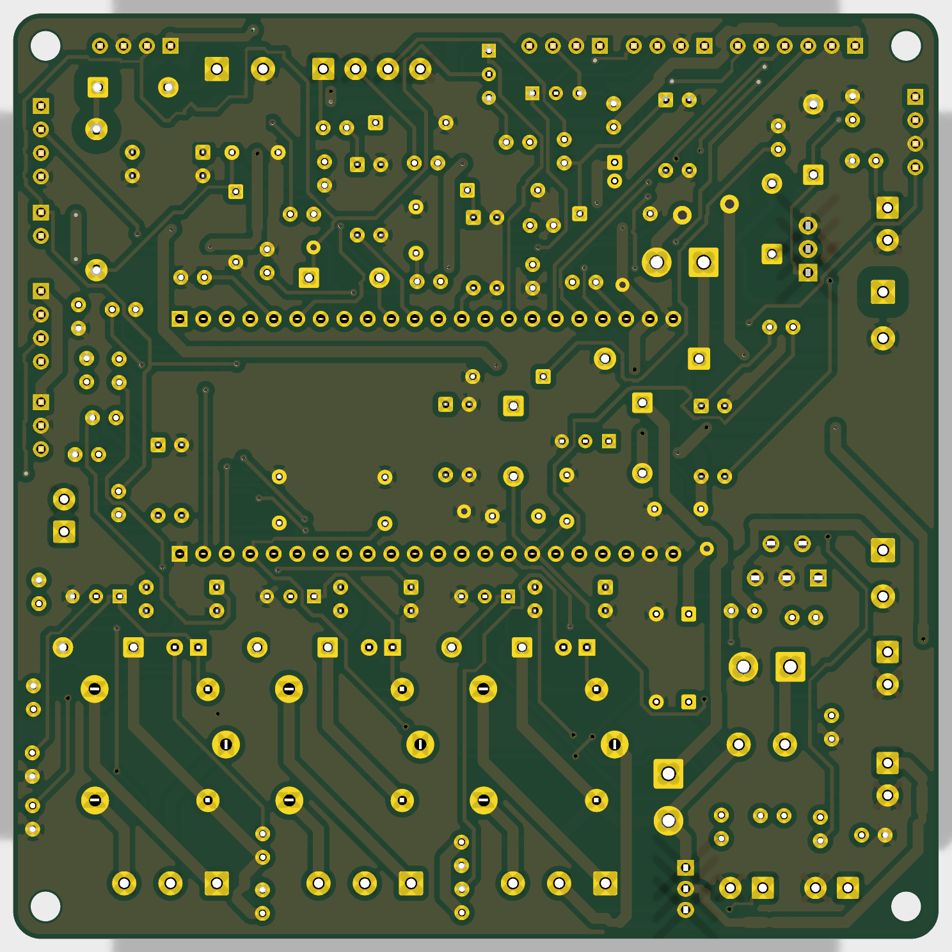
pcb/fabricar/B_JLCPCB/B_bottom.png
