z-XOF-z/FT150TS/pcb/fabricar/B_JLCPCB/B_top.png

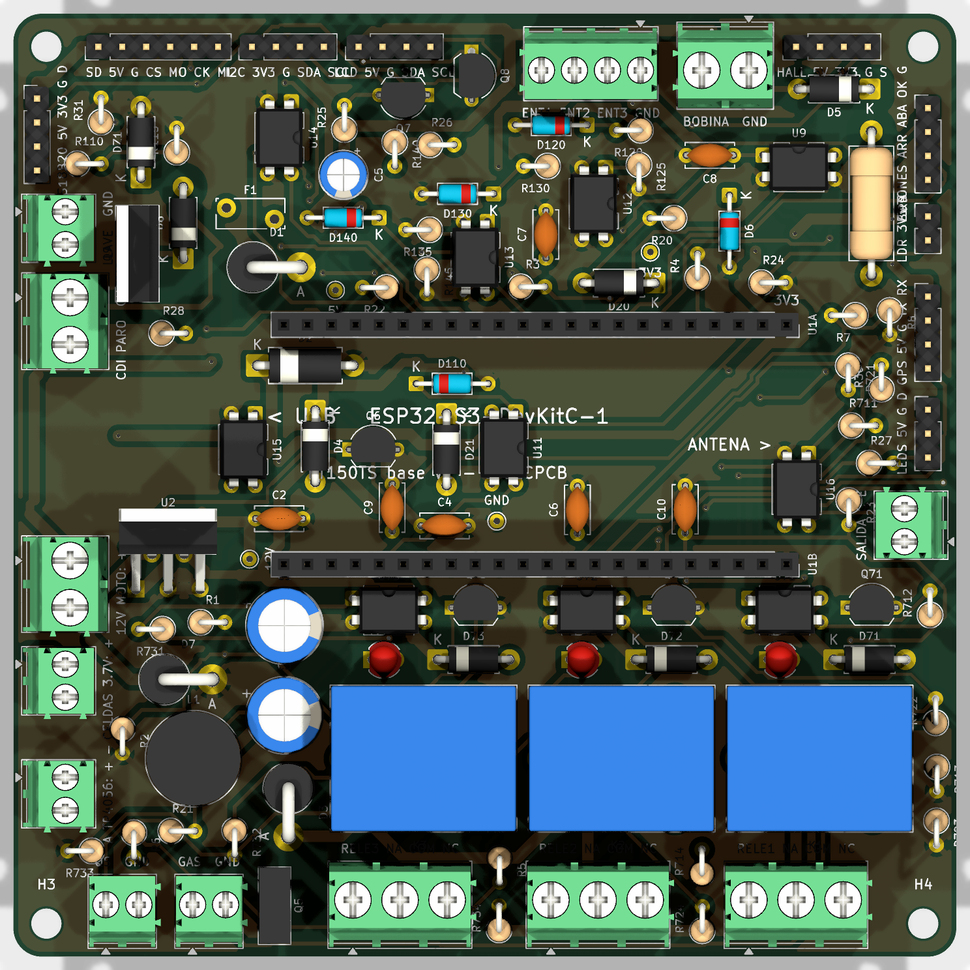
pcb/fabricar/B_JLCPCB/B_top.png
