z-XOF-z/FT150TS/pcb/fabricar/E_JLCPCB/E_bottom.png

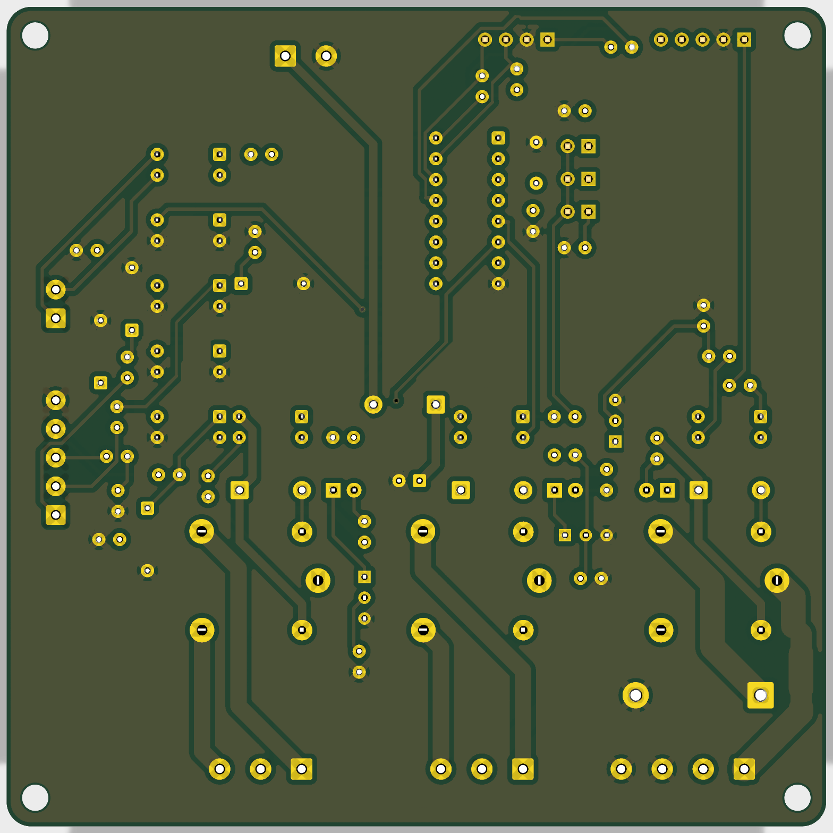
pcb/fabricar/E_JLCPCB/E_bottom.png
