z-XOF-z/FT150TS/pcb/fabricar/E_JLCPCB/E_top.png

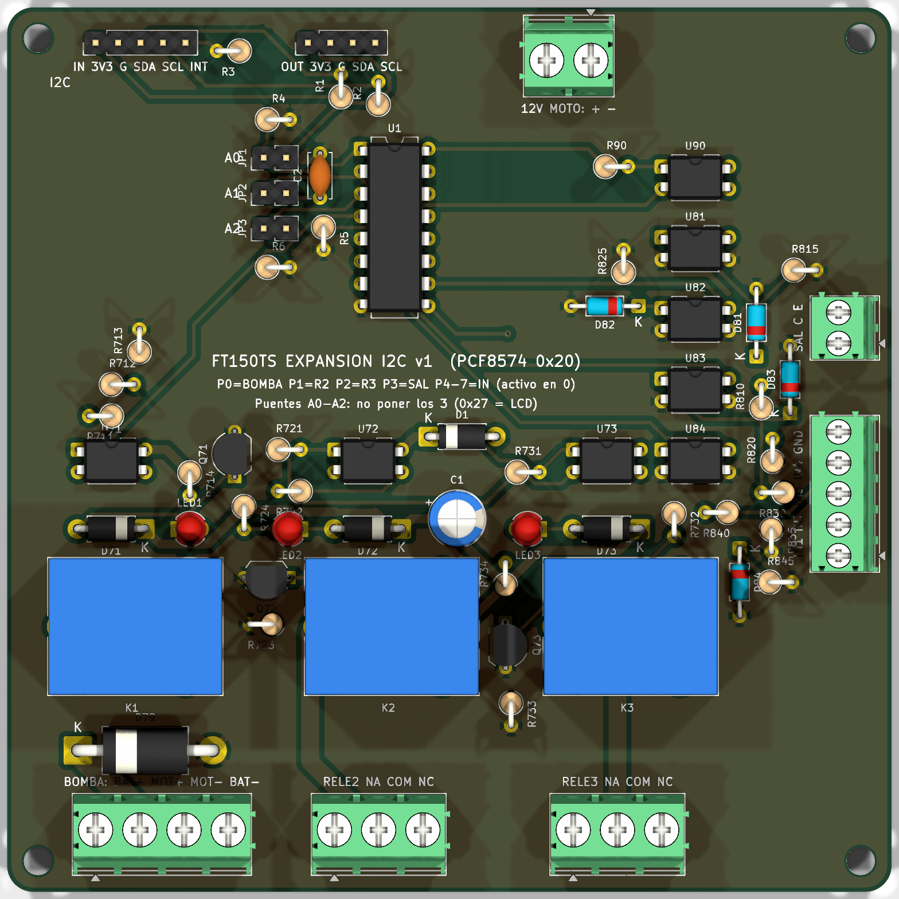
pcb/fabricar/E_JLCPCB/E_top.png
