z-XOF-z/FT150TS/pcb/fabricar/F_JLCPCB/F_bottom.png

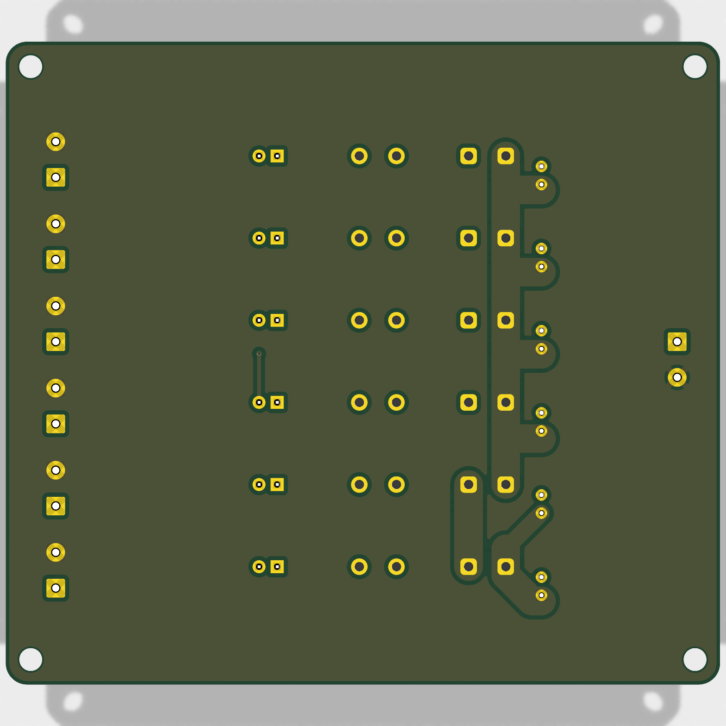
pcb/fabricar/F_JLCPCB/F_bottom.png
