z-XOF-z/FT150TS/pcb/fabricar/F_JLCPCB/F_top.png

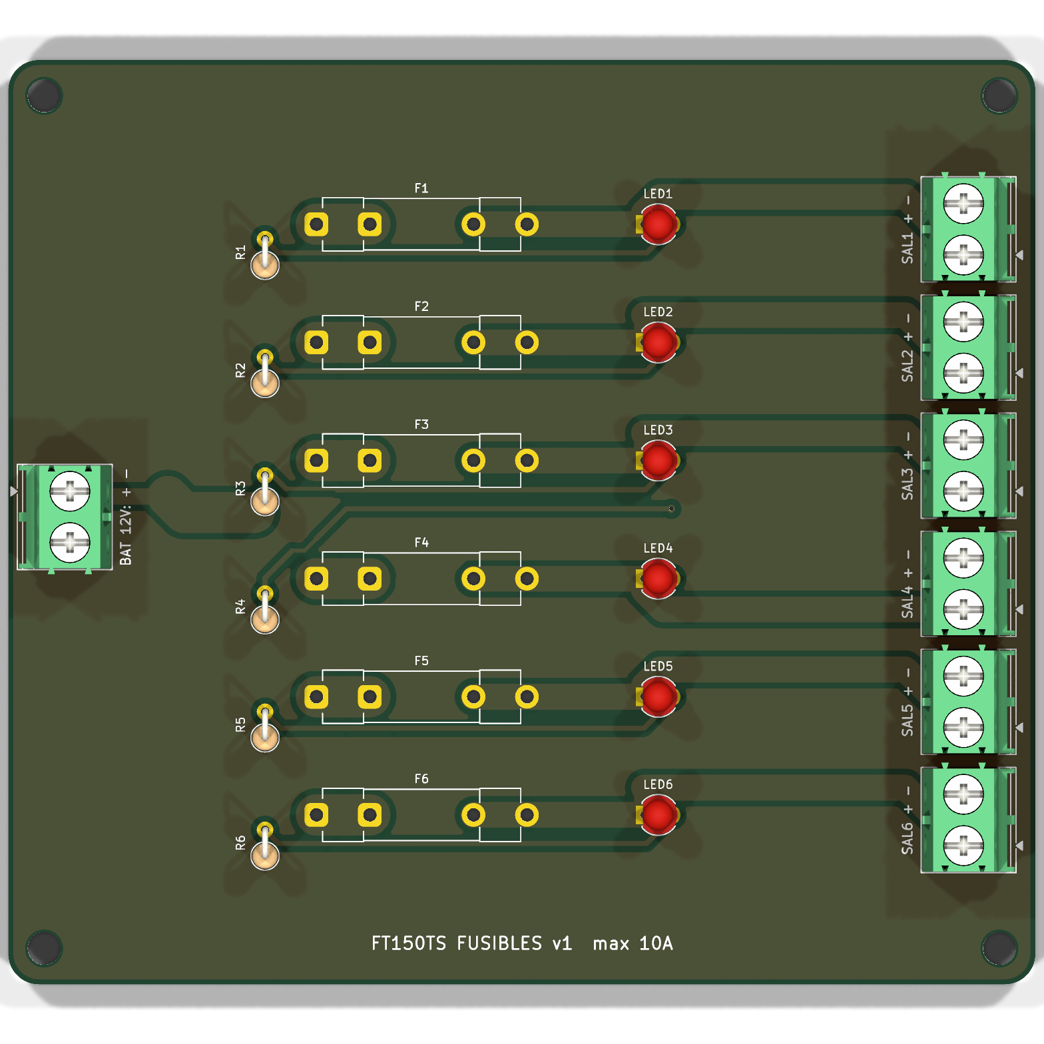
pcb/fabricar/F_JLCPCB/F_top.png
