z-XOF-z/FT150TS/pcb/fabricar/P_JLCPCB/P_bottom.png

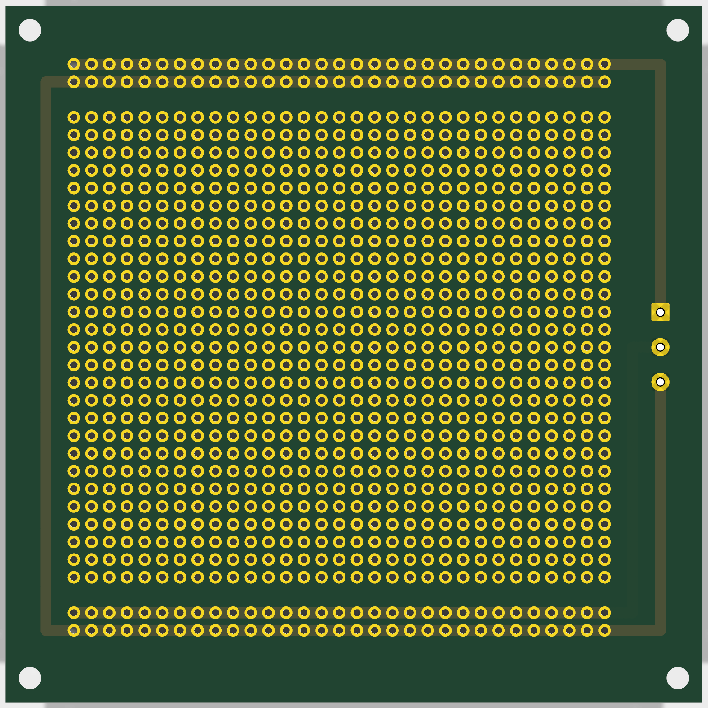
pcb/fabricar/P_JLCPCB/P_bottom.png
