z-XOF-z/FT150TS/pcb/fabricar/P_JLCPCB/P_top.png

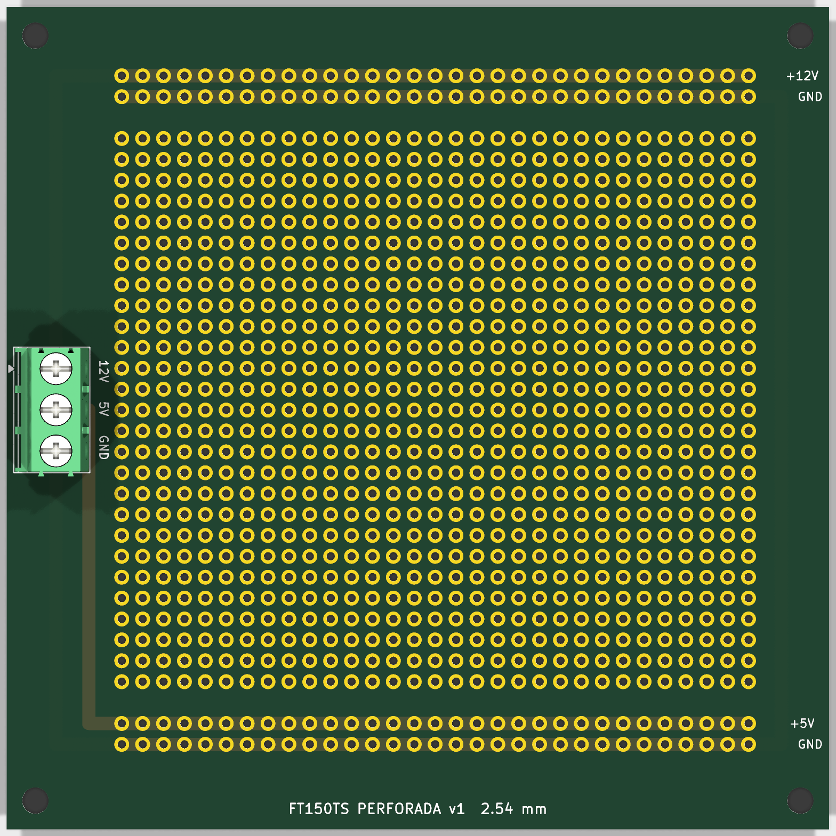
pcb/fabricar/P_JLCPCB/P_top.png
