z-XOF-z/FT150TS/pcb/esquematico/ft150ts_B_esquema.pdf

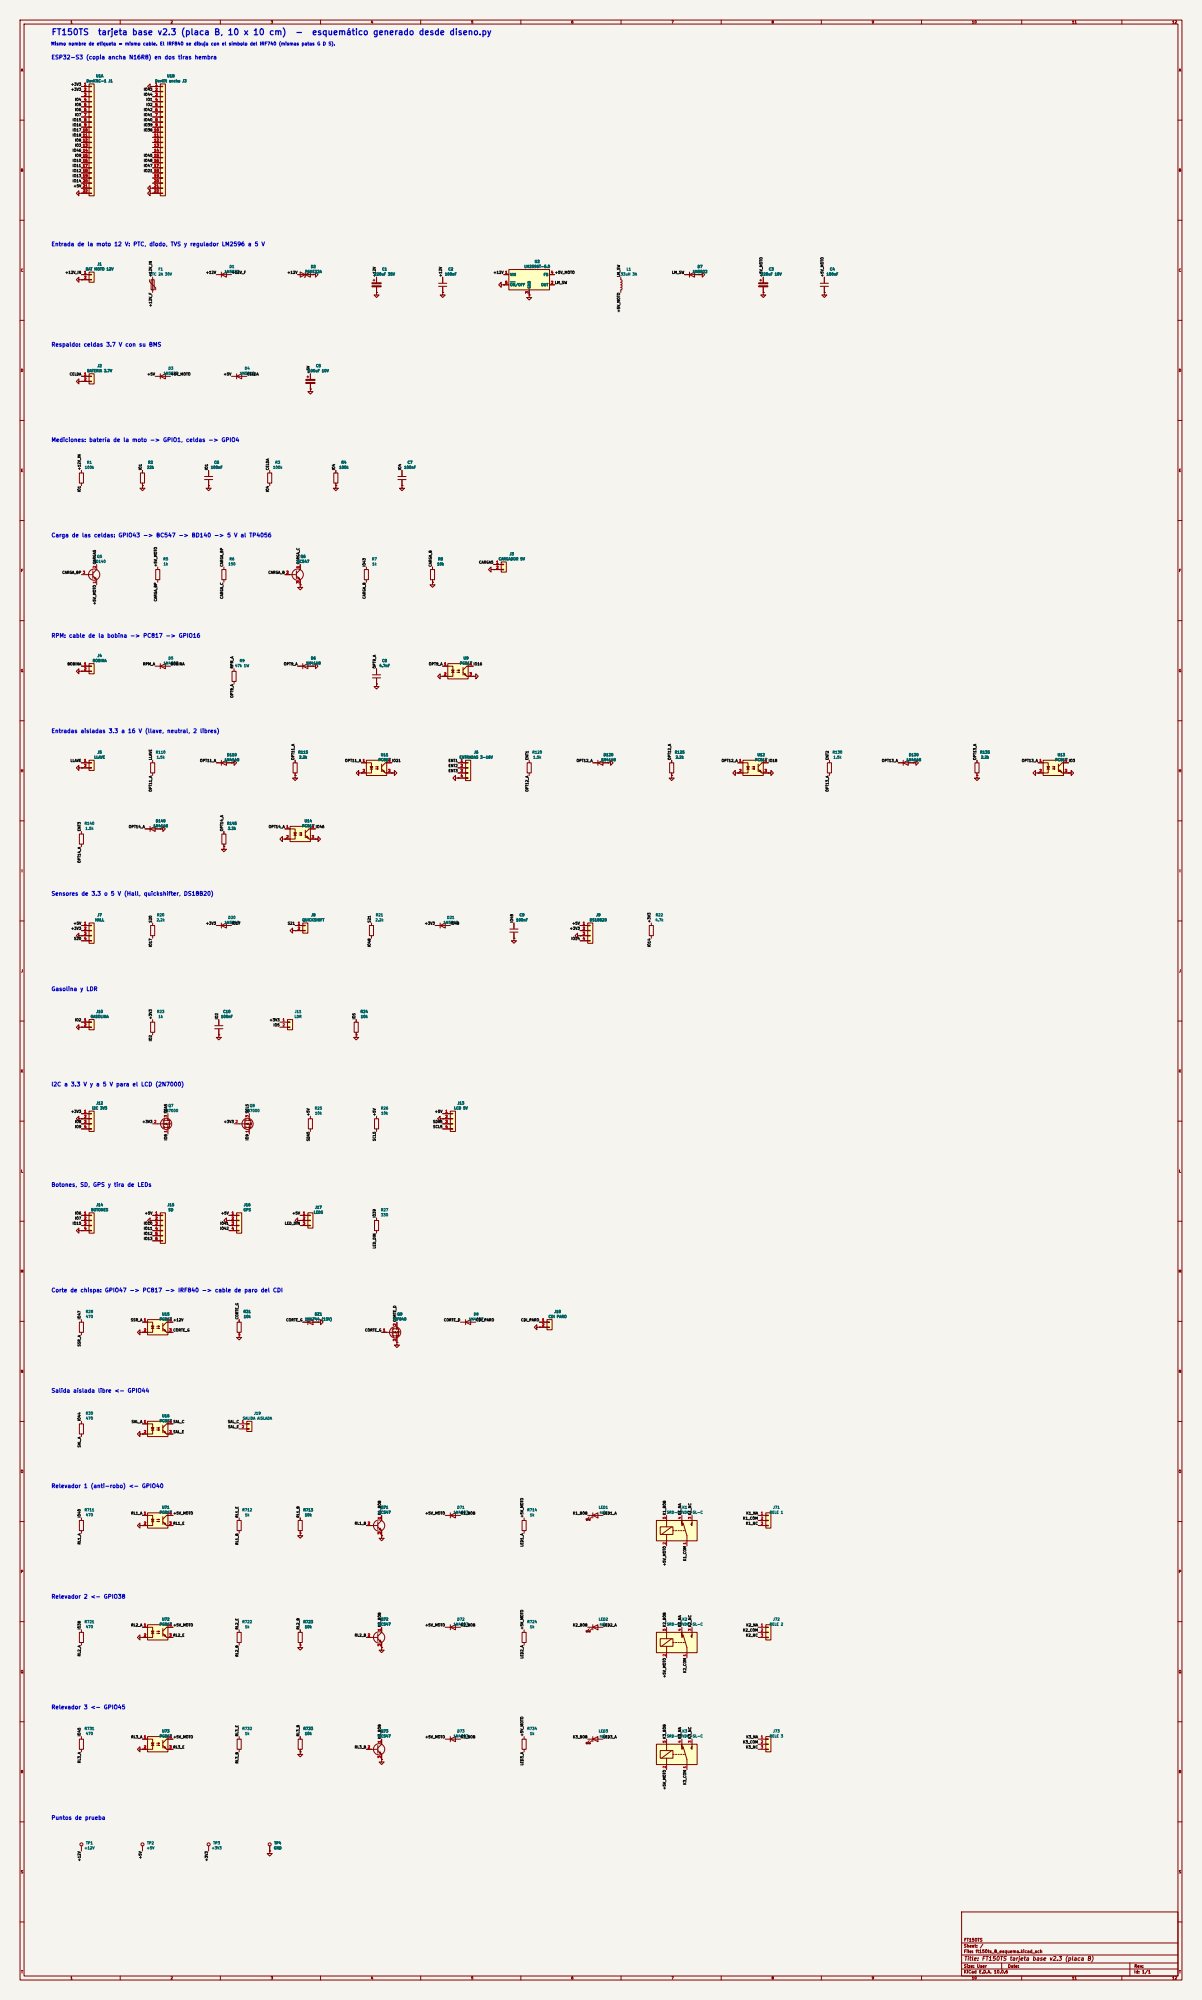
[picture p74: page 1]

FT150TS tarjeta base v2.3 (placa B, 10 x 10 cm) - esquemático generado desde diseno.py

Mismo nombre de etiqueta = mismo cable. El IRF840 se dibuja con el símbolo del IRF740 (mismas patas G D S).
ESP32-S3 (copia ancha N16R8) en dos tiras hembra

Entrada de la moto 12 V: PTC, diodo, TVS y regulador LM2596 a 5 V

Respaldo: celdas 3.7 V con su BMS

Mediciones: batería de la moto -> GPIO1, celdas -> GPIO4

Carga de las celdas: GPIO43 -> BC547 -> BD140 -> 5 V al TP4056

RPM: cable de la bobina -> PC817 -> GPIO16

Entradas aisladas 3.3 a 16 V (llave, neutral, 2 libres)

Sensores de 3.3 o 5 V (Hall, quickshifter, DS18B20)

Botones, SD, GPS y tira de LEDs

Corte de chispa: GPIO47 -> PC817 -> IRF840 -> cable de paro del CDI

Size: User | Rev: | T Date:
KiCad E.D.A. 10.0.6 | Id: 1/1
