z-XOF-z/FT150TS/pcb/extras/ft150ts_P.kicad_pcb

## KiCad design pcb/extras/ft150ts_P.kicad_pcb (2026-10-26)

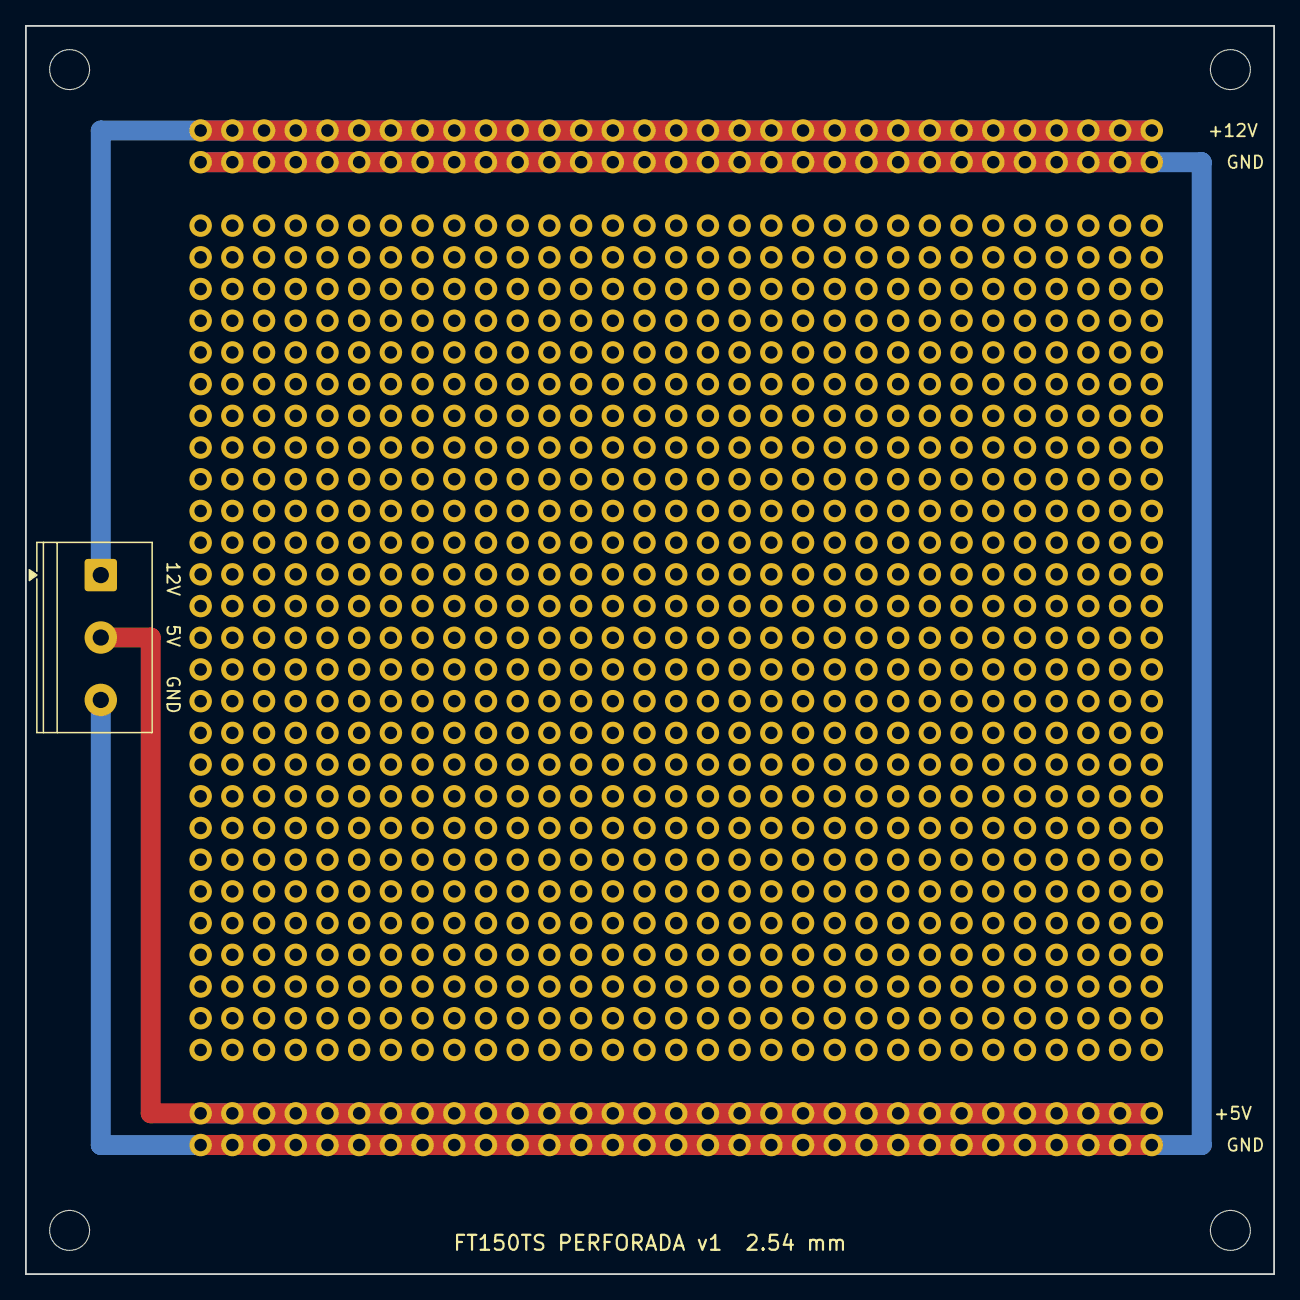
[picture p75: board ft150ts_P.kicad_pcb from above]

Board: 2 copper layers, 100.0 x 100.0 mm, 6 parts (0 on the bottom side), 3 nets.

Parts:
H1, H2, H3, H4: MountingHole_3.2mm_M3
J1: TerminalBlock_Phoenix_PT-1,5-3-5.0-H_1x03_P5.00mm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; TerminalBlock_Phoenix_PT-1,5-3-5.0-H_1x03_P5.00mm_Horizontal
PERF: (no value)

Connections:
+5V: J1.2, PERF.30, PERF.61, PERF.92, PERF.123, PERF.154, PERF.185, PERF.216, PERF.247, PERF.278, PERF.309, PERF.340, PERF.371, PERF.402, PERF.433, PERF.464, PERF.495, PERF.526, PERF.557, PERF.588, PERF.619, PERF.650, PERF.681, PERF.712, PERF.743, PERF.774, PERF.805, PERF.836, PERF.867, PERF.898, PERF.929, PERF.960
+12V: J1.1, PERF.28, PERF.59, PERF.90, PERF.121, PERF.152, PERF.183, PERF.214, PERF.245, PERF.276, PERF.307, PERF.338, PERF.369, PERF.400, PERF.431, PERF.462, PERF.493, PERF.524, PERF.555, PERF.586, PERF.617, PERF.648, PERF.679, PERF.710, PERF.741, PERF.772, PERF.803, PERF.834, PERF.865, PERF.896, PERF.927, PERF.958
GND: J1.3, PERF.29, PERF.31, PERF.60, PERF.62, PERF.91, PERF.93, PERF.122, PERF.124, PERF.153, PERF.155, PERF.184, PERF.186, PERF.215, PERF.217, PERF.246, PERF.248, PERF.277, PERF.279, PERF.308, PERF.310, PERF.339, PERF.341, PERF.370, PERF.372, PERF.401, PERF.403, PERF.432, PERF.434, PERF.463, PERF.465, PERF.494, PERF.496, PERF.525, PERF.527, PERF.556, PERF.558, PERF.587, PERF.589, PERF.618, PERF.620, PERF.649, PERF.651, PERF.680, PERF.682, PERF.711, PERF.713, PERF.742, PERF.744, PERF.773, PERF.775, PERF.804, PERF.806, PERF.835, PERF.837, PERF.866, PERF.868, PERF.897, PERF.899, PERF.928, PERF.930, PERF.959, PERF.961
