z-XOF-z/FT150TS/pcb/ft150ts_C.kicad_pcb

## KiCad design pcb/ft150ts_C.kicad_pcb (2026-10-26)

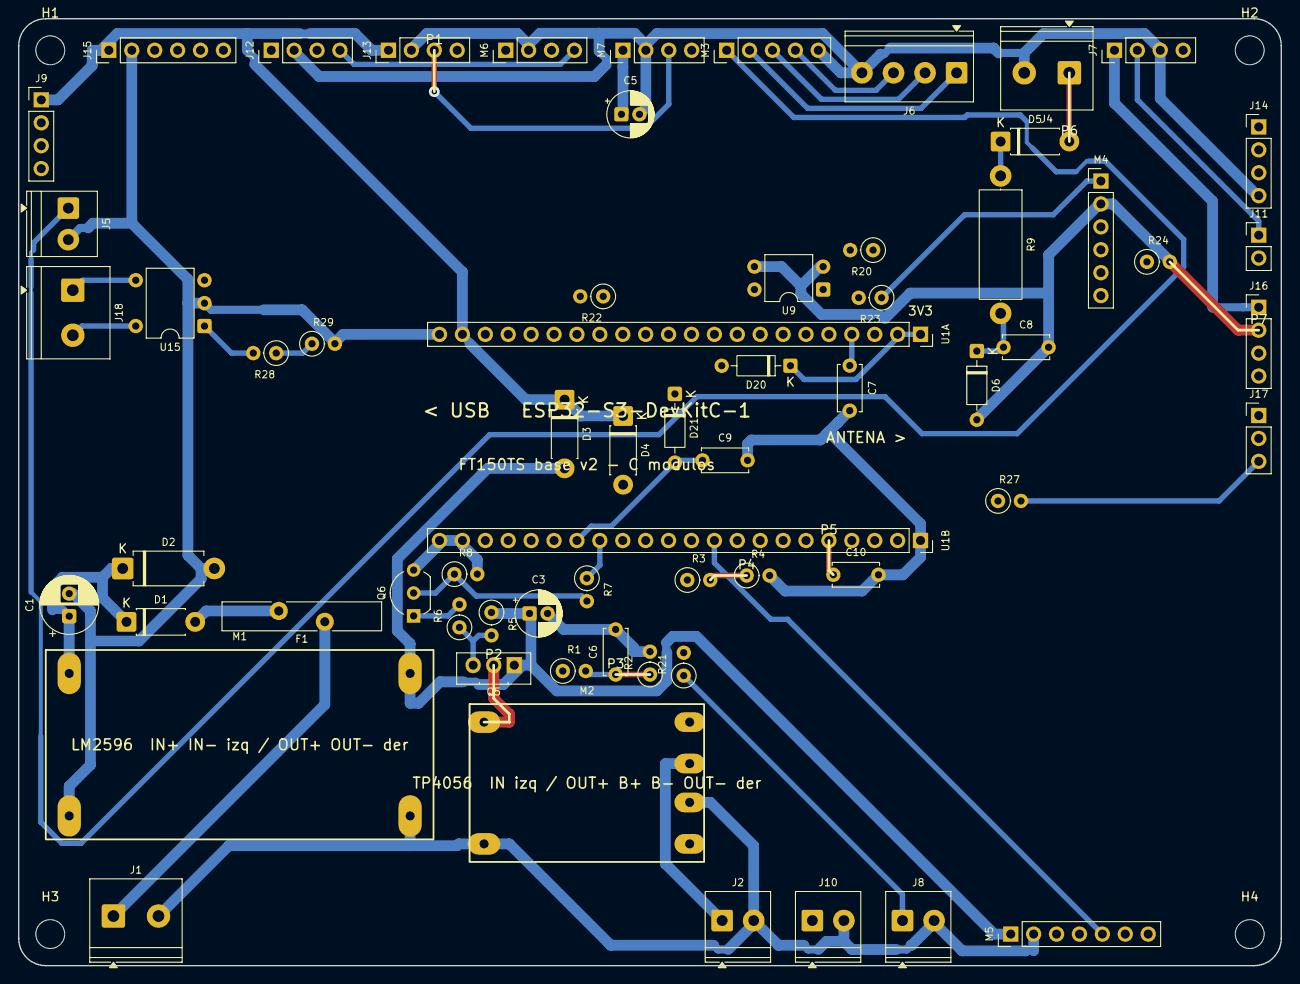
[picture p76: board ft150ts_C.kicad_pcb from above]

Board: 2 copper layers, 140.0 x 105.0 mm, 68 parts (0 on the bottom side), 57 nets.

Parts:
C1: 100uF 35V; CP_Radial_D6.3mm_P2.50mm
C3, C5: 100uF 10V; CP_Radial_D5.0mm_P2.00mm
C6, C7, C9, C10: 100nF; C_Disc_D5.0mm_W2.5mm_P5.00mm
C8: 4.7nF; C_Disc_D5.0mm_W2.5mm_P5.00mm
D1, D3, D4: 1N5819; D_DO-41_SOD81_P7.62mm_Horizontal
D2: P6KE22A; D_DO-15_P10.16mm_Horizontal
D5: 1N4007; D_DO-41_SOD81_P7.62mm_Horizontal
D6: 1N4148; D_DO-35_SOD27_P7.62mm_Horizontal
D20, D21: BAT85; D_DO-35_SOD27_P7.62mm_Horizontal
F1: MF-R110 1.1A; Fuse_Bourns_MF-RG1100
H1, H2, H3, H4: MountingHole_3.2mm_M3
J1: BAT MOTO 12V; TerminalBlock_Phoenix_PT-1,5-2-5.0-H_1x02_P5.00mm_Horizontal
J2: BATERIA 3.7V; TerminalBlock_Phoenix_PT-1,5-2-3.5-H_1x02_P3.50mm_Horizontal
J4: BOBINA; TerminalBlock_Phoenix_PT-1,5-2-5.0-H_1x02_P5.00mm_Horizontal
J5: LLAVE; TerminalBlock_Phoenix_PT-1,5-2-3.5-H_1x02_P3.50mm_Horizontal
J6: ENTRADAS 3-16V; TerminalBlock_Phoenix_PT-1,5-4-3.5-H_1x04_P3.50mm_Horizontal
J7: HALL; PinHeader_1x04_P2.54mm_Vertical
J8: QUICKSHIFT; TerminalBlock_Phoenix_PT-1,5-2-3.5-H_1x02_P3.50mm_Horizontal
J9: DS18B20; PinHeader_1x04_P2.54mm_Vertical
J10: GASOLINA; TerminalBlock_Phoenix_PT-1,5-2-3.5-H_1x02_P3.50mm_Horizontal
J11: LDR; PinHeader_1x02_P2.54mm_Vertical
J12: I2C 3V3; PinHeader_1x04_P2.54mm_Vertical
J13: LCD 5V; PinHeader_1x04_P2.54mm_Vertical
J14: BOTONES; PinHeader_1x04_P2.54mm_Vertical
J15: SD; PinHeader_1x06_P2.54mm_Vertical
J16: GPS; PinHeader_1x04_P2.54mm_Vertical
J17: LEDS; PinHeader_1x03_P2.54mm_Vertical
J18: CDI PARO; TerminalBlock_Phoenix_PT-1,5-2-5.0-H_1x02_P5.00mm_Horizontal
M1: LM2596; Modulo_LM2596_43x21
M2: TP4056; Modulo_TP4056_26x17
M3: OPTO 4CH ENTRADA; PinHeader_1x05_P2.54mm_Vertical
M4: OPTO 4CH SALIDA; PinHeader_1x06_P2.54mm_Vertical
M5: RELES 4CH; PinHeader_1x07_P2.54mm_Vertical
M6: NIVEL LV; PinHeader_1x04_P2.54mm_Vertical
M7: NIVEL HV; PinHeader_1x04_P2.54mm_Vertical
Q5: BD140; TO-126-3_Vertical
Q6: BC547; TO-92_Inline_Wide
R1, R3, R4: 100k; R_Axial_DIN0207_L6.3mm_D2.5mm_P2.54mm_Vertical
R2: 22k; R_Axial_DIN0207_L6.3mm_D2.5mm_P2.54mm_Vertical
R5, R7, R23: 1k; R_Axial_DIN0207_L6.3mm_D2.5mm_P2.54mm_Vertical
R6: 150; R_Axial_DIN0207_L6.3mm_D2.5mm_P2.54mm_Vertical
R8, R24, R29: 10k; R_Axial_DIN0207_L6.3mm_D2.5mm_P2.54mm_Vertical
R9: 47k 1W; R_Axial_DIN0414_L11.9mm_D4.5mm_P15.24mm_Horizontal
R20, R21: 2.2k; R_Axial_DIN0207_L6.3mm_D2.5mm_P2.54mm_Vertical
R22: 4.7k; R_Axial_DIN0207_L6.3mm_D2.5mm_P2.54mm_Vertical
R27, R28: 330; R_Axial_DIN0207_L6.3mm_D2.5mm_P2.54mm_Vertical
U1A: DevKitC-1 J1; PinSocket_1x22_P2.54mm_Vertical
U1B: DevKitC-1 J3; PinSocket_1x22_P2.54mm_Vertical
U9: PC817; DIP-4_W7.62mm
U15: PhotoMOS 600V; DIP-6_W7.62mm_SinPin5

Connections:
+3V3: D20.1, D21.1, J7.2, J9.2, J11.1, J12.1, M4.1, M5.3, M6.1, R22.1, R23.1, U1A.1, U1A.2
+5V: C5.1, D3.1, D4.1, J7.1, J9.1, J13.1, J15.1, J16.1, J17.1, M7.1, U1A.21
+5V_MOTO: C3.1, D3.2, M1.3, M5.1, Q5.1, R5.1
+12V: C1.1, D1.1, D2.1, M1.1
+12V_F: D1.2, F1.2
+12V_IN: F1.1, J1.1, R1.1
BOBINA: D5.2, J4.1
CARGA5: M2.1, Q5.2
CARGA_B: Q6.2, R7.2, R8.1
CARGA_BP: Q5.3, R5.2, R6.1
CARGA_C: Q6.1, R6.2
CDI_PARO: J18.1, U15.4
CDI_TIERRA: J18.2, U15.6
CELDA: D4.2, J2.1, M2.3, R3.1
ENT1: J6.1, M3.2
ENT2: J6.2, M3.3
ENT3: J6.3, M3.4
GND: C1.2, C3.2, C5.2, C6.2, C7.2, C8.2, C9.2, C10.2, D2.2, D6.2, J1.2, J2.2, J4.2, J5.2, J6.4, J7.3, J8.2, J9.3, J10.2, J12.2, J13.2, J14.4, J15.2, J16.2, J17.2, M1.2, M1.4, M2.2, M2.4, M3.5, M4.2, M5.2, M6.2, M7.2, Q6.3, R2.2, R4.2, R8.2, R24.2, R29.2, U1A.22, U1B.1, U1B.21, U1B.22, U9.2, U9.3, U15.2
IO1: C6.1, R1.2, R2.1, U1B.4
IO2: C10.1, J10.1, R23.2, U1B.5
IO3: M4.5, U1A.13
IO4: C7.1, R3.2, R4.1, U1A.4
IO5: J11.2, R24.1, U1A.5
IO6: J14.1, U1A.6
IO7: J14.2, U1A.7
IO8: J12.3, M6.3, U1A.12
IO9: J12.4, M6.4, U1A.15
IO10: J15.3, U1A.16
IO11: J15.4, U1A.17
IO12: J15.5, U1A.18
IO13: J15.6, U1A.19
IO14: J9.4, R22.2, U1A.20
IO15: J14.3, U1A.8
IO16: U1A.9, U9.4
IO17: D20.2, R20.2, U1A.10
IO18: M4.4, U1A.11
IO21: M4.3, U1B.18
IO38: M5.5, U1B.10
IO39: R27.1, U1B.9
IO40: M5.4, U1B.8
IO41: J16.3, U1B.7
IO42: J16.4, U1B.6
IO43: M5.7, U1B.2
IO44: M5.6, U1B.3
IO45: R7.1, U1B.15
IO46: M4.6, U1A.14
IO47: R28.1, R29.1, U1B.17
IO48: C9.1, D21.2, R21.2, U1B.16
LED_DIN: J17.3, R27.2
LLAVE: J5.1, M3.1
OPT9_A: C8.1, D6.1, R9.2, U9.1
RPM_A: D5.1, R9.1
S20: J7.4, R20.1
S21: J8.1, R21.1
SCL5: J13.4, M7.4
SDA5: J13.3, M7.3
SSR_A: R28.2, U15.1
