z-XOF-z/FT150TS/pcb/ft150ts_base.kicad_pcb

## KiCad design pcb/ft150ts_base.kicad_pcb (2026-10-26)

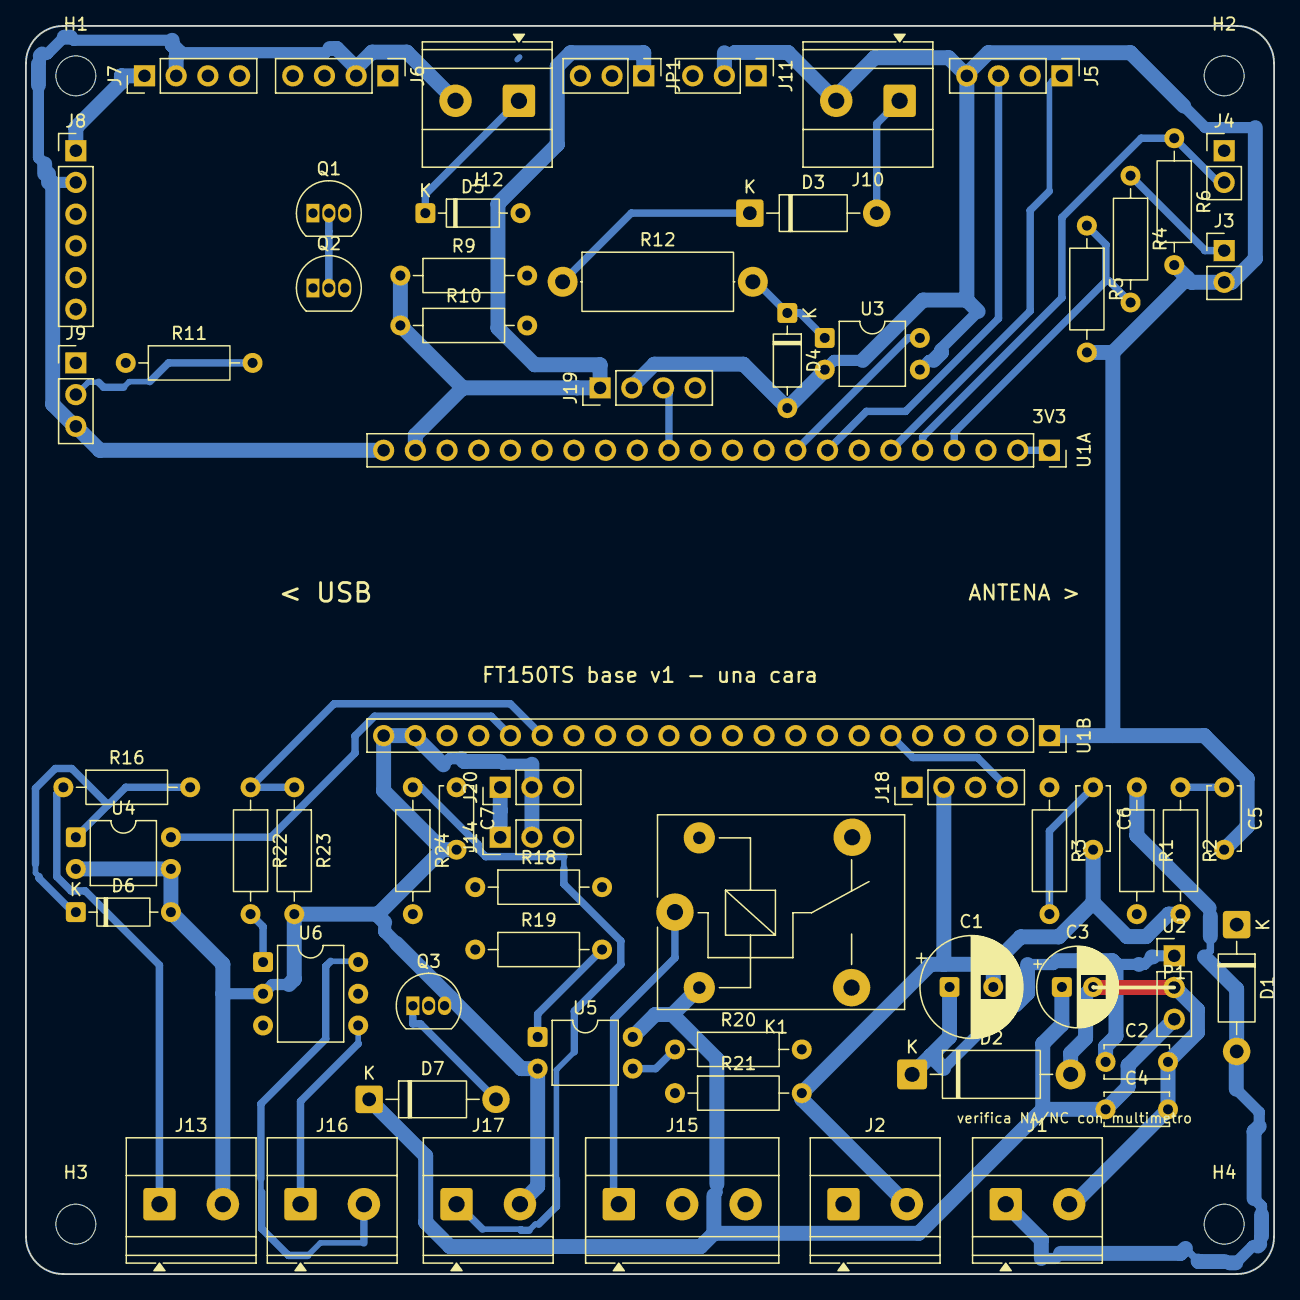
[picture p77: board ft150ts_base.kicad_pcb from above]

Board: 2 copper layers, 100.0 x 100.0 mm, 68 parts (0 on the bottom side), 54 nets.

Parts:
C1: 100uF 35V; CP_Radial_D8.0mm_P3.50mm
C2, C4, C5, C6, C7: 100nF; C_Disc_D5.0mm_W2.5mm_P5.00mm
C3: 100uF 10V; CP_Radial_D6.3mm_P2.50mm
D1: 1N5819; D_DO-41_SOD81_P10.16mm_Horizontal
D2: P6KE24A; D_DO-15_P12.70mm_Horizontal
D3, D7: 1N4007; D_DO-41_SOD81_P10.16mm_Horizontal
D4, D5, D6: 1N4148; D_DO-35_SOD27_P7.62mm_Horizontal
H1, H2, H3, H4: MountingHole_3.2mm_M3
J1: 12V MOTO; TerminalBlock_Phoenix_MKDS-1,5-2-5.08_1x02_P5.08mm_Horizont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
J2: GASOLINA; TerminalBlock_Phoenix_MKDS-1,5-2-5.08_1x02_P5.08mm_Horizont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
J3: 18650; PinHeader_1x02_P2.54mm_Vertical
J4: LDR; PinHeader_1x02_P2.54mm_Vertical
J5: BOTONES; PinHeader_1x04_P2.54mm_Vertical
J6: I2C 3V3; PinHeader_1x04_P2.54mm_Vertical
J7: LCD 5V; PinHeader_1x04_P2.54mm_Vertical
J8: SD; PinHeader_1x06_P2.54mm_Vertical
J9: DS18B20; PinHeader_1x03_P2.54mm_Vertical
J10: BOBINA; TerminalBlock_Phoenix_MKDS-1,5-2-5.08_1x02_P5.08mm_Horizont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
J11: HALL; PinHeader_1x03_P2.54mm_Vertical
J12: NEUTRAL; TerminalBlock_Phoenix_MKDS-1,5-2-5.08_1x02_P5.08mm_Horizont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
J13: LLAVE; TerminalBlock_Phoenix_MKDS-1,5-2-5.08_1x02_P5.08mm_Horizont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
J14: LEDS; PinHeader_1x03_P2.54mm_Vertical
J15: RELE; TerminalBlock_Phoenix_MKDS-1,5-3-5.08_1x03_P5.08mm_Horizont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
J16: CDI PARO; TerminalBlock_Phoenix_MKDS-1,5-2-5.08_1x02_P5.08mm_Horizont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
J17: QUICKSHIFT; TerminalBlock_Phoenix_MKDS-1,5-2-5.08_1x02_P5.08mm_Horizont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
J18: GPS; PinHeader_1x04_P2.54mm_Vertical
J19: RELES EXTRA; PinHeader_1x04_P2.54mm_Vertical
J20: RELE EXTRA 3; PinHeader_1x03_P2.54mm_Vertical
JP1: VSENS 5V|3V3; PinHeader_1x03_P2.54mm_Vertical
K1: SRD-05VDC-SL-C; Relay_SPDT_SANYOU_SRD_Series_Form_C
Q1, Q2: 2N7000; TO-92_Inline
Q3: BC547; TO-92_Inline
R1, R4, R5: 100k; R_Axial_DIN0207_L6.3mm_D2.5mm_P10.16mm_Horizontal
R2: 22k; R_Axial_DIN0207_L6.3mm_D2.5mm_P10.16mm_Horizontal
R3, R19, R20, R24: 1k; R_Axial_DIN0207_L6.3mm_D2.5mm_P10.16mm_Horizontal
R6, R9, R10, R21, R23: 10k; R_Axial_DIN0207_L6.3mm_D2.5mm_P10.16mm_Horizontal
R11: 4.7k; R_Axial_DIN0207_L6.3mm_D2.5mm_P10.16mm_Horizontal
R12: 47k 1W; R_Axial_DIN0414_L11.9mm_D4.5mm_P15.24mm_Horizontal
R16: 2.2k; R_Axial_DIN0207_L6.3mm_D2.5mm_P10.16mm_Horizontal
R18, R22: 330; R_Axial_DIN0207_L6.3mm_D2.5mm_P10.16mm_Horizontal
U1A: DevKitC-1 J1; PinSocket_1x22_P2.54mm_Vertical
U1B: DevKitC-1 J3; PinSocket_1x22_P2.54mm_Vertical
U2: R-78E5.0-1.0; PinHeader_1x03_P2.54mm_Vertical
U3, U4, U5: PC817; DIP-4_W7.62mm
U6: PhotoMOS 600V; DIP-6_W7.62mm

Connections:
+3V3: J4.1, J6.1, JP1.3, Q1.2, Q2.2, R3.1, R11.1, U1A.1, U1A.2
+5V: C3.1, C4.1, D7.1, J7.1, J8.1, J14.1, J18.1, J19.1, J20.1, JP1.1, K1.2, R9.1, R10.1, U1A.21, U2.3, U5.4
+12V: C1.1, C2.1, D1.1, D2.1, U2.1
+12V_IN: D1.2, J1.1, R1.1
BOBINA: D3.2, J10.1
CDI_PARO: J16.1, U6.4
CDI_TIERRA: J16.2, U6.6
GND: C1.2, C2.2, C3.2, C4.2, C5.2, C6.2, C7.2, D2.2, D4.2, D6.2, J1.2, J2.2, J3.2, J5.4, J6.2, J7.2, J8.2, J9.3, J10.2, J11.2, J12.2, J13.2, J14.2, J17.2, J18.2, J19.2, J20.2, Q3.3, R2.2, R5.2, R6.2, R21.2, R23.2, U1A.22, U1B.1, U1B.21, U1B.22, U2.2, U3.2, U3.3, U4.2, U4.3, U5.2, U6.2
IO1: C5.1, R1.2, R2.1, U1B.4
IO2: C6.1, J2.1, R3.2, U1B.5
IO3: J19.3, U1A.13
IO4: R4.2, R5.1, U1A.4
IO5: J4.2, R6.1, U1A.5
IO6: J5.1, U1A.6
IO7: J5.2, U1A.7
IO8: J6.3, Q1.1, U1A.12
IO9: J6.4, Q2.1, U1A.15
IO10: J8.3, U1A.16
IO11: J8.4, U1A.17
IO12: J8.5, U1A.18
IO13: J8.6, U1A.19
IO14: J9.2, R11.2, U1A.20
IO15: J5.3, U1A.8
IO16: U1A.9, U3.4
IO17: J11.3, U1A.10
IO18: D5.2, U1A.11
IO21: U1B.18, U4.4
IO38: J20.3, U1B.10
IO39: R18.1, U1B.9
IO40: R19.1, U1B.8
IO41: J18.3, U1B.7
IO42: J18.4, U1B.6
IO46: J19.4, U1A.14
IO47: R22.1, R23.1, U1B.17
IO48: C7.1, R24.2, U1B.16
LED_DIN: J14.3, R18.2
LIPO: J3.1, R4.1
LLAVE: J13.1, R16.1
NEUTRAL: D5.1, J12.1
OPT1_A: D4.1, R12.2, U3.1
OPT2_A: D6.1, R16.2, U4.1
OPT3_A: R19.2, U5.1
QS: J17.1, R24.1
RLY_B: Q3.2, R20.2, R21.1
RLY_BOB: D7.2, K1.5, Q3.1
RLY_COM: J15.1, K1.1
RLY_E: R20.1, U5.3
RLY_NA: J15.2, K1.4
RLY_NC: J15.3, K1.3
RPM_A: D3.1, R12.1
SCL5: J7.4, Q2.3, R10.2
SDA5: J7.3, Q1.3, R9.2
SSR_A: R22.2, U6.1
VSENS: J9.1, J11.1, JP1.2
