z-XOF-z/FT150TS/pcb/extras/ft150ts_E.kicad_pcb

## KiCad design pcb/extras/ft150ts_E.kicad_pcb (2026-10-26)

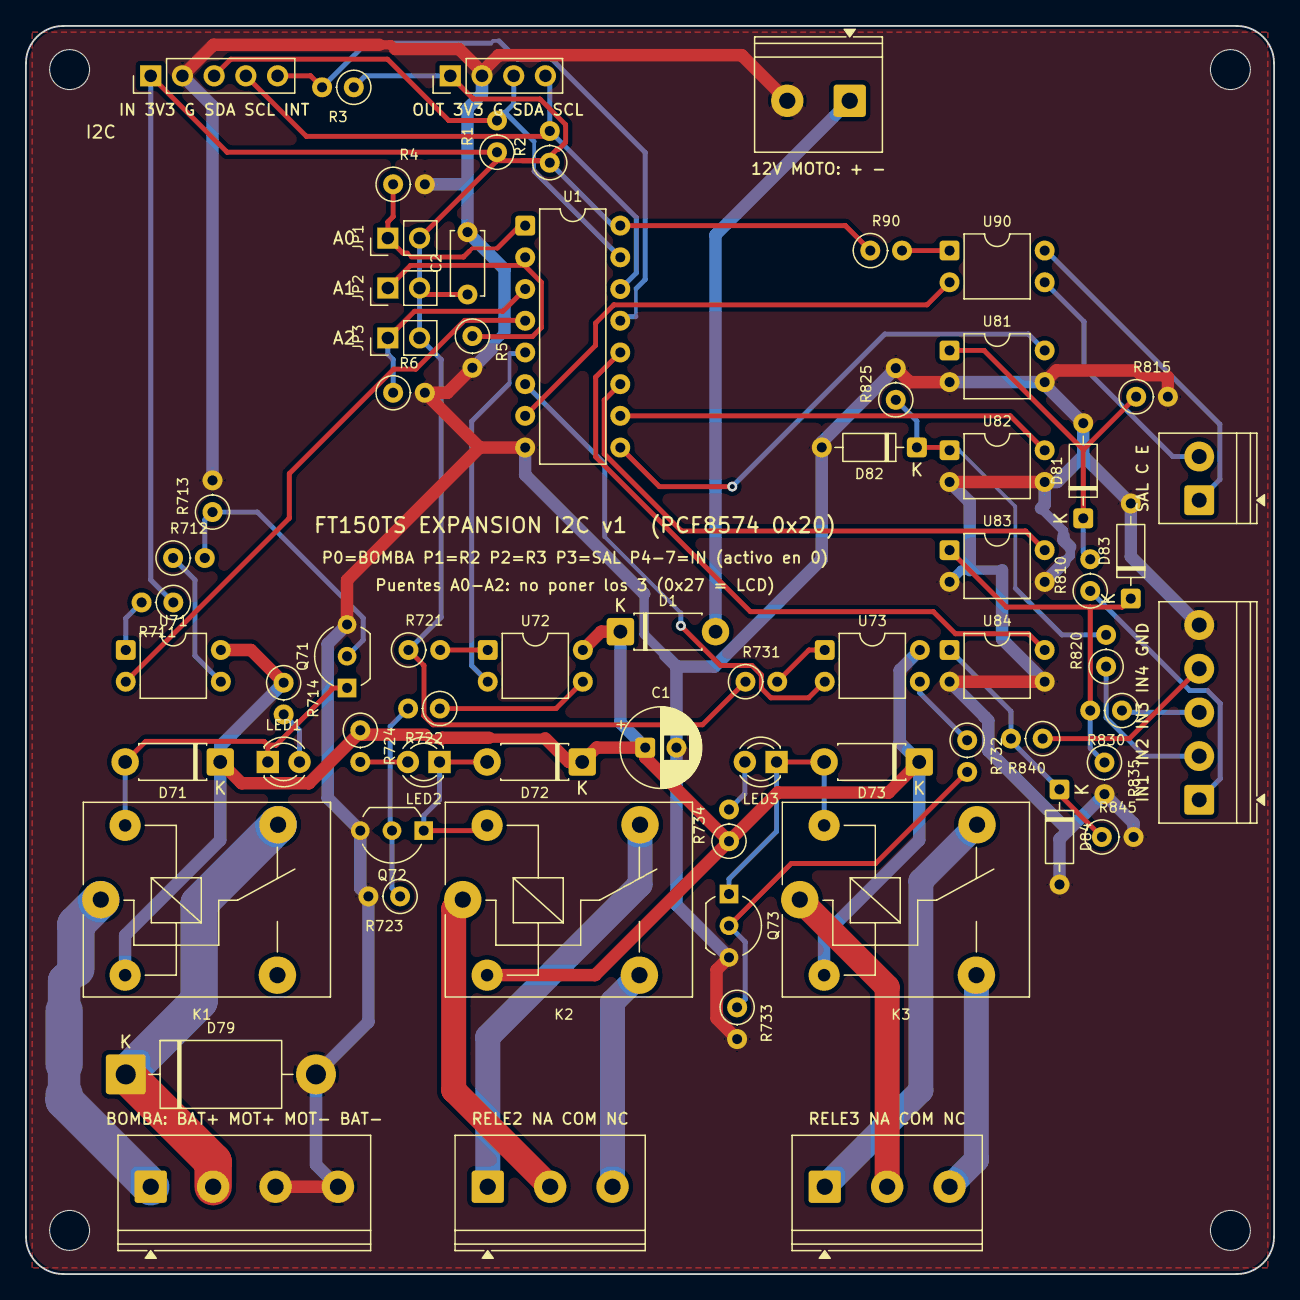
[picture p78: board ft150ts_E.kicad_pcb from above]

Board: 2 copper layers, 100.0 x 100.0 mm, 71 parts (0 on the bottom side), 52 nets.

Parts:
C1: 100uF 25V; CP_Radial_D6.3mm_P2.50mm
C2: 100nF; C_Disc_D5.0mm_W2.5mm_P5.00mm
D1, D71, D72, D73: 1N4007; D_DO-41_SOD81_P7.62mm_Horizontal
D79: 1N5408; D_DO-201AD_P15.24mm_Horizontal
D81, D82, D83, D84: 1N4148; D_DO-35_SOD27_P7.62mm_Horizontal
H1, H2, H3, H4: MountingHole_3.2mm_M3
J1: I2C ENTRADA; PinHeader_1x05_P2.54mm_Vertical
J2: I2C SALIDA; PinHeader_1x04_P2.54mm_Vertical
J3: 12V; TerminalBlock_Phoenix_PT-1,5-2-5.0-H_1x02_P5.00mm_Horizontal
J71: BOMBA; TerminalBlock_Phoenix_PT-1,5-4-5.0-H_1x04_P5.00mm_Horizontal
J72: RELE 2; TerminalBlock_Phoenix_PT-1,5-3-5.0-H_1x03_P5.00mm_Horizontal
J73: RELE 3; TerminalBlock_Phoenix_PT-1,5-3-5.0-H_1x03_P5.00mm_Horizontal
J80: ENTRADAS; TerminalBlock_Phoenix_PT-1,5-5-3.5-H_1x05_P3.50mm_Horizontal
J90: SALIDA; TerminalBlock_Phoenix_PT-1,5-2-3.5-H_1x02_P3.50mm_Horizontal
JP1: A0; PinHeader_1x02_P2.54mm_Vertical
JP2: A1; PinHeader_1x02_P2.54mm_Vertical
JP3: A2; PinHeader_1x02_P2.54mm_Vertical
K1, K2, K3: SRD-12VDC-SL-C; Relay_SPDT_SANYOU_SRD_Series_Form_C
LED1, LED2, LED3: rojo; LED_D3.0mm
Q71, Q72, Q73: BC547; TO-92_Inline_Wide
R1, R2, R3, R4, R5, R6, R713, R723, R733: 10k; R_Axial_DIN0207_L6.3mm_D2.5mm_P2.54mm_Vertical
R90, R711, R721, R731: 330; R_Axial_DIN0207_L6.3mm_D2.5mm_P2.54mm_Vertical
R712, R722, R732: 1k; R_Axial_DIN0207_L6.3mm_D2.5mm_P2.54mm_Vertical
R714, R724, R734, R815, R825, R835, R845: 2.2k; R_Axial_DIN0207_L6.3mm_D2.5mm_P2.54mm_Vertical
R810, R820, R830, R840: 1.5k; R_Axial_DIN0207_L6.3mm_D2.5mm_P2.54mm_Vertical
U1: PCF8574P; DIP-16_W7.62mm
U71, U72, U73, U81, U82, U83, U84, U90: PC817; DIP-4_W7.62mm

Connections:
+3V3: C2.1, J1.1, J2.1, JP1.2, JP2.2, JP3.2, R1.1, R2.1, R3.1, R90.1, R711.1, R721.1, R731.1, U1.16
+12V: C1.1, D1.1, D71.1, D72.1, D73.1, K1.2, K2.2, K3.2, R714.1, R724.1, R734.1, U71.4, U72.4, U73.4
+12V_IN: D1.2, J3.1
A0: JP1.1, R4.1, U1.1
A1: JP2.1, R5.1, U1.2
A2: JP3.1, R6.1, U1.3
BOMBA_12V: J71.1, K1.1
GND: C1.2, C2.2, D79.2, D81.2, D82.2, D83.2, D84.2, J1.2, J2.2, J3.2, J71.3, J71.4, J80.5, Q71.3, Q72.3, Q73.3, R4.2, R5.2, R6.2, R713.2, R723.2, R733.2, R815.2, R825.2, R835.2, R845.2, U1.8, U81.2, U81.3, U82.2, U82.3, U83.2, U83.3, U84.2, U84.3
IN1: J80.1, R810.1
IN1_A: D81.1, R810.2, R815.1, U81.1
IN2: J80.2, R820.1
IN2_A: D82.1, R820.2, R825.1, U82.1
IN3: J80.3, R830.1
IN3_A: D83.1, R830.2, R835.1, U83.1
IN4: J80.4, R840.1
IN4_A: D84.1, R840.2, R845.1, U84.1
INT: J1.5, R3.2, U1.13
K1_BOB: D71.2, K1.5, LED1.1, Q71.1
K2_BOB: D72.2, K2.5, LED2.1, Q72.1
K2_COM: J72.2, K2.1
K2_NA: J72.1, K2.4
K2_NC: J72.3, K2.3
K3_BOB: D73.2, K3.5, LED3.1, Q73.1
K3_COM: J73.2, K3.1
K3_NA: J73.1, K3.4
K3_NC: J73.3, K3.3
LED1_A: LED1.2, R714.2
LED2_A: LED2.2, R724.2
LED3_A: LED3.2, R734.2
MOTOR_P: D79.1, J71.2, K1.4
P0: U1.4, U71.2
P1: U1.5, U72.2
P2: U1.6, U73.2
P3: U1.7, U90.2
P4: U1.9, U81.4
P5: U1.10, U82.4
P6: U1.11, U83.4
P7: U1.12, U84.4
RL1_A: R711.2, U71.1
RL1_B: Q71.2, R712.2, R713.1
RL1_E: R712.1, U71.3
RL2_A: R721.2, U72.1
RL2_B: Q72.2, R722.2, R723.1
RL2_E: R722.1, U72.3
RL3_A: R731.2, U73.1
RL3_B: Q73.2, R732.2, R733.1
RL3_E: R732.1, U73.3
SAL_A: R90.2, U90.1
SAL_C: J90.1, U90.4
SAL_E: J90.2, U90.3
SCL: J1.4, J2.4, R2.2, U1.14
SDA: J1.3, J2.3, R1.2, U1.15
