z-XOF-z/FT150TS/pcb/extras/ft150ts_F.kicad_pcb

## KiCad design pcb/extras/ft150ts_F.kicad_pcb (2026-10-26)

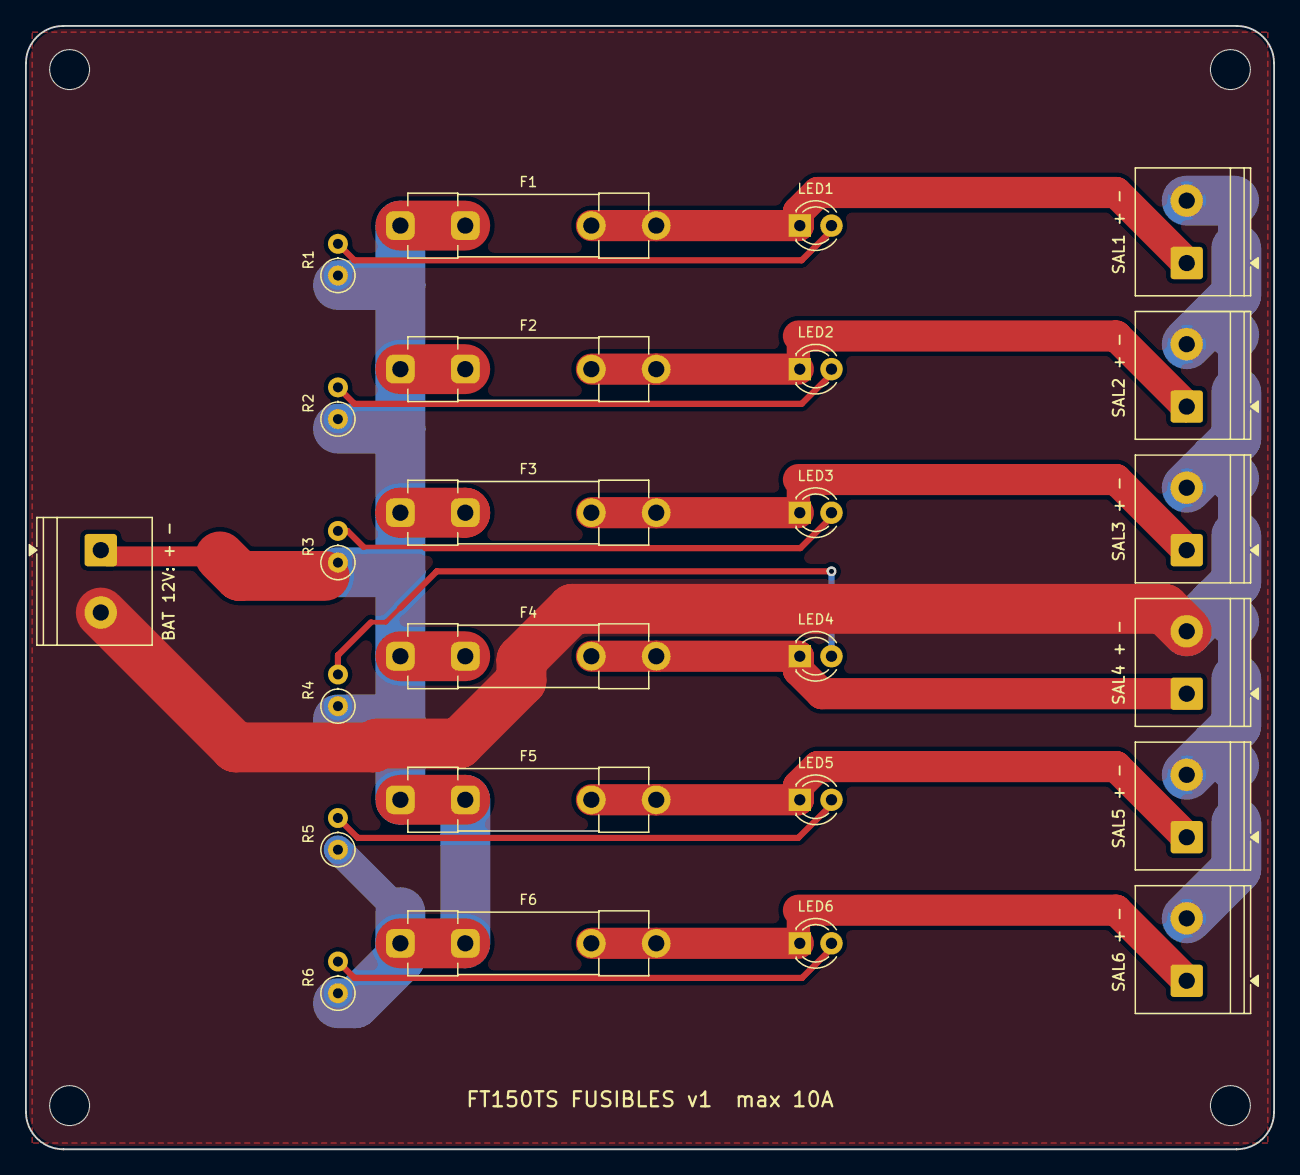
[picture p79: board ft150ts_F.kicad_pcb from above]

Board: 2 copper layers, 100.0 x 90.0 mm, 29 parts (0 on the bottom side), 14 nets.

Parts:
F1, F2, F3, F4, F5, F6: 5x20; Fuseholder_Clip-5x20mm_Littelfuse_445-030_Inline_P20.50x5.2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
H1, H2, H3, H4: MountingHole_3.2mm_M3
J1: BATERIA 12V; TerminalBlock_Phoenix_PT-1,5-2-5.0-H_1x02_P5.00mm_Horizontal
J2: SALIDA 1; TerminalBlock_Phoenix_PT-1,5-2-5.0-H_1x02_P5.00mm_Horizontal
J3: SALIDA 2; TerminalBlock_Phoenix_PT-1,5-2-5.0-H_1x02_P5.00mm_Horizontal
J4: SALIDA 3; TerminalBlock_Phoenix_PT-1,5-2-5.0-H_1x02_P5.00mm_Horizontal
J5: SALIDA 4; TerminalBlock_Phoenix_PT-1,5-2-5.0-H_1x02_P5.00mm_Horizontal
J6: SALIDA 5; TerminalBlock_Phoenix_PT-1,5-2-5.0-H_1x02_P5.00mm_Horizontal
J7: SALIDA 6; TerminalBlock_Phoenix_PT-1,5-2-5.0-H_1x02_P5.00mm_Horizontal
LED1, LED2, LED3, LED4, LED5, LED6: rojo; LED_D3.0mm
R1, R2, R3, R4, R5, R6: 2.2k; R_Axial_DIN0207_L6.3mm_D2.5mm_P2.54mm_Vertical

Connections:
BUS12: F1.1, F2.1, F3.1, F4.1, F5.1, F6.1, J1.1, R1.1, R2.1, R3.1, R4.1, R5.1, R6.1
GND: J1.2, J2.2, J3.2, J4.2, J5.2, J6.2, J7.2
LED1_A: LED1.2, R1.2
LED2_A: LED2.2, R2.2
LED3_A: LED3.2, R3.2
LED4_A: LED4.2, R4.2
LED5_A: LED5.2, R5.2
LED6_A: LED6.2, R6.2
OUT1: F1.2, J2.1, LED1.1
OUT2: F2.2, J3.1, LED2.1
OUT3: F3.2, J4.1, LED3.1
OUT4: F4.2, J5.1, LED4.1
OUT5: F5.2, J6.1, LED5.1
OUT6: F6.2, J7.1, LED6.1
