z-XOF-z/FT150TS/firmware/ft150ts_dashboard/ft150ts_dashboard.ino

/*
  ================================================================
   DASHBOARD FT150TS  -  firmware completo en un solo archivo
   ESP32-S3 DevKitC-1  +  LCD 20x4 I2C
   Versión 1.2 (con app Android e iPhone por Bluetooth)
  ================================================================
   Placa en Arduino IDE: "ESP32S3 Dev Module"  (core esp32 3.2.1; NO 3.3)
   Flash Size:           16MB · PSRAM: "OPI PSRAM" (N16R8)
   Partition Scheme:     "16M Flash (3MB APP/9.9MB FATFS)"  (desde v1.6)
                         Dos copias del firmware de 3 MB: así la app lo puede actualizar por Bluetooth (OTA).
                         (Antes "Huge APP", que no tiene segunda copia. Cambiar de esquema borra lo guardado en la
                          tarjeta la primera vez: odómetro, calibraciones.)
   USB CDC On Boot:      Enabled (para ver el Serial por el USB nativo)

   Librerías (Library Manager):
     LiquidCrystal I2C   (Frank de Brabander)
     TinyGPSPlus         (Mikal Hart)
     RTClib              (Adafruit)  -> instala también Adafruit BusIO
     OneWire             (Paul Stoffregen)
     DallasTemperature   (Miles Burton)
     Adafruit NeoPixel   (Adafruit)

   Todo valor marcado con   // <-- X   es de ejemplo: cámbialo por
   el real de tu moto o de tus piezas cuando lo tengas.

   Controles:
     ARRIBA / ABAJO = cambiar de pantalla
     OK corto       = seleccionar dentro de la pantalla
     OK largo (1s)  = ejecutar / cambiar lo seleccionado
                      (en pantallas sin acción, regresa a la principal)
   Consola Serial (115200): escribe "ayuda".

   IPHONE (sin instalar nada en el iPhone):
     iPhone > Ajustes > Bluetooth > "FT150TS" > Vincular, y acepta
     "Compartir notificaciones del sistema". Desde ahí la moto recibe
     tus notificaciones (ANCS), la canción que suena y la controla (AMS)
     y toma la hora del iPhone (CTS). Puede estar conectado al mismo
     tiempo que la app de Android.
     Pantalla "IPHONE": OK = play/pausa, OK largo = siguiente canción.
     Llamada entrante: OK = contestar, OK largo = colgar/rechazar.

   MAPA DE CONEXIONES: PLACA BASE B v2.3 (pcb/diseno.py, guía pcb/ARMADO.md) con la ESP32-S3 N16R8 ancha
   GPIO1  <- batería 12V por divisor 100k/22k (+100nF)          GPIO2  <- flotador de la gasolina (J10)
   GPIO4  <- celda 3.7 V por divisor 100k/100k                  GPIO43 -> carga de la celda (alto = 5 V al TP4056)
   GPIO5  <- INT del MPU6050 en el conector J11 "LDR" (alarma de movimiento; la luz la manda el teléfono)
   GPIO6/7/15 <- botones ARRIBA / ABAJO / OK (a GND, J14)
   GPIO8/9 <> I2C: LCD (J13, a 5 V por 2N7000), RTC DS3231, MPU6050 0x69 y la placa E (J12)
   GPIO10-13 <> SD (J15)        GPIO14 <> DS18B20 (J9)        GPIO16 <- RPM (bobina, PC817, J4)
   GPIO17 <- Hall (J7)          GPIO48 <- quickshifter (J8)    GPIO39 -> tira WS2812B (J17)
   Entradas aisladas (PC817; el pin lee LOW cuando el cable tiene voltaje):
   GPIO21 <- LLAVE (J5)   GPIO18 <- ENT1 neutral (J6)   GPIO3 <- ENT2 freno   GPIO46 <- ENT3 direccionales
   GPIO40 -> relevador 1 (bloqueo anti-robo)   GPIO38 -> relevador 2   GPIO45 -> relevador 3   (alto = prendido)
   GPIO44 -> salida aislada (J19)              GPIO47 -> corte de chispa (PC817 + IRF840, J18)
   GPIO41 <- TX del GPS   GPIO42 -> RX del GPS (J16)
  ================================================================
*/

// ================================================================
// 0) INTERRUPTORES GENERALES
// ================================================================
#define MODO_SIMULADOR 0   // 1 = Velxio / Wokwi   0 = placa real en la moto (la copia para el simulador está en firmware/simulador_wokwi)
// En modo simulador: sin íconos personalizados (el simulador no los dibuja),
// sin WiFi, sin Bluetooth, sin dormir, y arranca directo en modo demo.

#if MODO_SIMULADOR
  #define USAR_WIFI       0
  #define USAR_BLE        0
  #define USAR_DORMIR     0
  #define USAR_ICONOS     0
  #define DEMO_AL_INICIAR 1
#else
  #define USAR_WIFI       1
  #define USAR_BLE        1
  #define USAR_DORMIR     1
  #define USAR_ICONOS     1
  #define DEMO_AL_INICIAR 0
#endif

#define USAR_IGNICION 1    // 1 = hay cable de ignición (llave) conectado al ESP32
#define USAR_LLAVERO  USAR_WIFI   // llavero TamaXOF por ESP-NOW (llavero/): llave sin contraseña y botón de paro
#define USAR_PLACA_E  1    // 1 = busca la placa E (PCF8574 0x20) sola cada 5 s: si no está, no pasa nada y la app no
                           //     la muestra. 0 = ni la busca (el bus I2C queda solo para LCD, reloj y MPU)

// Corte de chispa (limitador de RPM, launch control y quickshifter). Pon 1 SOLO cuando ya
// tengas armado el corte de chispa (placa base v2.1: PC817 + IRF840; ver firmware/HARDWARE-CORTE-CHISPA.md)
// y hayas puesto el pin en PIN_CORTE_CHISPA. Con 0 no se compila nada que toque la chispa.
// Aun con 1, cada función arranca apagada y se prende desde la app.
#define USAR_CORTE_CHISPA 0

#include <Wire.h>
#include <SPI.h>
#include <SD.h>
#include <Preferences.h>
#include <LiquidCrystal_I2C.h>
#include <TinyGPSPlus.h>
#include <RTClib.h>
#include <OneWire.h>
#include <DallasTemperature.h>
#include <Adafruit_NeoPixel.h>
#include <esp_sleep.h>
#include <driver/rtc_io.h>
#if USAR_WIFI
  #include <WiFi.h>
  #include <WebServer.h>
  #include <HTTPClient.h>
  #include <NetworkClientSecure.h>
  #include "certificados.h"        // raíces de api.telegram.org (bot de Telegram)
#endif
#include <Update.h>                // actualizar el firmware desde la app (OTA)
#include <esp_ota_ops.h>
#if USAR_BLE
  #include <BLEDevice.h>
  #include <BLEServer.h>
  #include <BLEUtils.h>
  #include <BLE2902.h>
  #include <BLEClient.h>
  #include <BLESecurity.h>
#endif

#if USAR_LLAVERO
  #include "tamaxof_moto.h"        // copia de llavero/moto (la pone llavero/generar_secreto.py junto con la clave)
#endif

#define FW_VERSION "v1.8"

// ================================================================
// 1) TAMAÑOS Y TIPOS
//    (van hasta arriba para que el Arduino IDE los reconozca al
//     generar los prototipos automáticos de las funciones)
// ================================================================
const uint8_t NUM_MARCHAS = 5;
const uint8_t NUM_MANT    = 5;
const uint8_t NUM_RUTAS   = 8;
const uint8_t NUM_LEDS    = 8;
const uint8_t BINS_RPM    = 26;   // bloques de 500 rpm (0 - 13000)
const uint8_t NUM_EVT_RAM = 6;

enum Evento : uint8_t { EV_NINGUNO, EV_ARRIBA, EV_ABAJO, EV_OK, EV_OK_LARGO };

enum Vista : uint8_t {
  V_PRINCIPAL, V_IPHONE, V_VIAJE, V_COMPARAR, V_MANT, V_BATERIAS, V_DIAG, V_PISTA, V_AJUSTES, V_TOTAL
};

// Conexiones Bluetooth: la app de Android y/o el iPhone al mismo tiempo
const uint8_t MAX_CONEX = 3;
struct ConexionBle {
  bool     usada = false;
  uint16_t id = 0;          // conn_id de Bluedroid
  uint8_t  bda[6] = {0};    // dirección del teléfono
  uint8_t  tipoDir = 0;     // pública / aleatoria
  uint32_t desde = 0;       // millis() al conectarse
  bool     esApp = false;   // ya escribió en nuestros comandos (es la app Android)
  bool     esIphone = false;
  bool     revisada = false;
  bool     cifrada = false; // el enlace ya está cifrado (iPhone vinculado que se reconecta)
};

// Paquetes del iPhone que llegan por Bluetooth (se procesan fuera del hilo de BT)
struct PaqueteIos {
  uint8_t origen;     // 1 ANCS aviso, 2 ANCS datos, 3 AMS entidad, 4 AMS comandos, 10 orden local
  uint8_t len;
  uint8_t datos[200];
};

struct EstadoIphone {
  bool  conectado = false;     // vinculado y suscrito
  bool  ancs = false, ams = false;
  // música (AMS)
  char  titulo[64] = "", artista[56] = "", album[48] = "", app[20] = "";
  bool  sonando = false;
  float velocidad = 0, transcurrido = 0, duracion = 0, volumen = -1;
  uint32_t msInfo = 0;         // millis() en que llegó 'transcurrido'
  // llamada entrante (ANCS)
  bool  llamada = false;
  uint32_t llamadaUid = 0, llamadaMs = 0;
  char  llamadaDe[40] = "";
  bool  llamadaAcciones = false; // el iPhone permite contestar/colgar desde aquí
};

// Prototipos de lo nuevo (por si el IDE no los genera solo)
void aAscii(const char* src, char* dst, size_t n);
void cortarUtf8(char* dst, size_t n, const char* src);
bool iosMusica(uint8_t comando);
bool iosLlamada(uint8_t accion);
void iosOlvidar();
void filaTexto(uint8_t r, const char* txt);
void bleEvento(const char* json);        // aviso corto a la app por Bluetooth (sección 29b)
void bachesRevisar();                    // IA de baches (21f)
void semanaSumarViaje(float km, float litros, float vmax);
// Ojo: si una función tiene su prototipo escrito a mano, el IDE ya no lo genera solo; por eso van aquí arriba
void irADormir(bool porTimer);
String palabra(const String& s, int n);
bool tgListo();
float iaAceiteFraccion();               // IA del motor (21i)
int iaEmbraguePuntos(String& consejo);

enum Icono : uint8_t { ICO_BAT = 1, ICO_GAS, ICO_TEMP, ICO_ALERTA, ICO_BT, ICO_LLAVE, ICO_GPS };

enum TipoEvento : uint8_t {
  EVT_CAIDA, EVT_FRENADA, EVT_ACELERON, EVT_ARRANQUE, EVT_CORTE,
  EVT_SOBRE_RPM, EVT_BAT_BAJA, EVT_GAS_CRITICA, EVT_TEMP_ALTA, EVT_NO_CARGA, EVT_MOVIDA, EVT_VIBRA, EVT_TOTAL
};

struct DatosMoto {
  float vMoto   = NAN;   // V batería de la moto
  float vLipo   = NAN;   // V batería 18650 del sistema
  int   gasPct  = -1;    // 0-100
  float gasMv   = NAN;   // lectura cruda del sensor (para calibrar)
  float vel     = NAN;   // km/h elegida (Hall o GPS)
  float velHall = NAN;
  float velGps  = NAN;
  int   rpm     = -1;
  int   marcha  = -1;    // -1 desconocida, 0 neutral, 1..5
  bool  neutral = false;
  float tempC   = NAN;
  float incl    = NAN;   // grados respecto a la moto parada derecha
  float aFwd    = 0;     // g hacia adelante (+ acelera, - frena)
  bool  gpsFix  = false;
  double lat = 0, lon = 0;
  int   sats    = 0;
  int   luz     = -1;    // 0-100
  bool  ignicion = false;
  bool  freno = false;         // luz de freno prendida (ENT2)
  bool  direccional = false;   // alguna direccional parpadeando (ENT3)
  bool  dirOlvidada = false;   // la direccional lleva rato prendida rodando
  bool  vibraAlerta = false;   // la IA de vibraciones vio algo raro
};

struct Boton {
  uint8_t  pin;
  bool     estable, ultima;
  uint32_t tCambio, tPresion;
  bool     largoEmitido;
};

struct Glifo { char c; uint8_t ancho; uint8_t f[4]; };

struct Mant {
  char     nombre[10];
  uint16_t intKm;
  uint16_t intDias;
  float    kmUltimo;
  uint32_t epochUltimo;
};

struct Ruta {
  float    latI, lonI, latF, lonF;
  uint16_t veces;
  float    minProm, litProm;
};

struct Resumen {
  float    km;
  float    litros;
  uint32_t segMov;
  float    velMax;
  uint16_t viajes;
};

struct Viaje {
  bool     activo;
  uint32_t epochInicio;
  float    km;
  uint32_t msMov, msParado;
  float    velMax;
  float    gasRef, gasMin, litrosAcum;
  bool     tieneInicioGps;
  double   latI, lonI;
};

struct EventoReg { uint32_t epoch; uint8_t tipo; float valor; };

// Un componente del "estado de la moto" (21f): 0-100 y qué hacer
struct ItemSalud { const char* nombre; int puntos; String consejo; };

// Todo lo que se guarda en la memoria interna (sobrevive apagones)
struct Persistente {
  uint32_t magic;
  uint8_t  perfil;          // 0 ECO, 1 SPORT
  uint8_t  fuenteVel;       // 0 AUTO, 1 HALL, 2 GPS
  bool     autoBrillo;
  bool     wifiOn;
  bool     corteActivo;     // corte de motor (anti robo) persistente
  float    gasMvVacio, gasMvLleno;
  float    batFactor;
  float    ratioMarcha[NUM_MARCHAS];
  float    imuRef[3];
  float    odometro;
  uint32_t arranques;
  float    kmPorLitro;
  float    shiftAprendido[NUM_MARCHAS];
  Mant     mant[NUM_MANT];
  Ruta     rutas[NUM_RUTAS];
  Resumen  hoy, ayer, prom;
  uint32_t diaHoy;
  float    vReposo[7];
  uint32_t diaReposo;
  uint8_t  idxReposo;
  float    descMotoBase, descLipoBase;
  float    vMotoDormir, vLipoDormir;
  uint32_t epochDormir;
  uint32_t diaBackup;
  float    pistaMejor;
};

// Para que la consola funcione igual desde Serial o desde la página web
class TextoPrint : public Print {
 public:
  String s;
  size_t write(uint8_t c) override { s += (char)c; return 1; }
};

// ================================================================
// 2) CONFIGURACIÓN
// ================================================================

// ---------- Pines: placa base B v2.3 ----------
const uint8_t PIN_ADC_BATERIA  = 1;    // divisor 100k/22k de la batería 12V
const uint8_t PIN_ADC_GASOLINA = 2;    // sensor de flotador (divisor)
const uint8_t PIN_ADC_LIPO     = 4;    // divisor 100k/100k de la celda
const uint8_t PIN_ADC_LUZ      = 5;    // conector J11: LDR (si no está la INT del MPU, ver PIN_MPU_INT)
// INT del MPU6050 (alarma de movimiento): al conector J11 "LDR" (GPIO5, ya trae 10k a tierra). Es de los pocos
// pines que pueden despertar a la tarjeta dormida (0-21) que quedan en la placa B. Con esto la LDR no se usa: el
// brillo automático toma la luz del sensor del teléfono (la app la manda). -1 = J11 con la LDR, sin alarma.
const int8_t  PIN_MPU_INT      = 5;
const uint8_t PIN_ENT2         = 3;    // entrada aislada 2 (J6): ver FUNCION_ENT2
const uint8_t PIN_ENT3         = 46;   // entrada aislada 3 (J6): ver FUNCION_ENT3
const uint8_t PIN_RELE2        = 38;   // relevador 2 (J72), alto = prendido
const uint8_t PIN_RELE3        = 45;   // relevador 3 (J73), alto = prendido. Al arrancar debe estar en bajo: el
                                       // LED del PC817 a tierra lo asegura (si no, la flash no arranca)
const uint8_t PIN_SALIDA       = 44;   // salida aislada de colector abierto (J19, hasta 50 mA)
const uint8_t PIN_CARGA        = 43;   // alto = 5 V de la moto al TP4056 (carga la celda)
const uint8_t PIN_BTN_ARRIBA   = 6;
const uint8_t PIN_BTN_ABAJO    = 7;
const uint8_t PIN_BTN_OK       = 15;
const uint8_t PIN_I2C_SDA      = 8;    // LCD + RTC DS3231 + MPU6050
const uint8_t PIN_I2C_SCL      = 9;
const uint8_t PIN_SD_CS        = 10;
const uint8_t PIN_SD_MOSI      = 11;
const uint8_t PIN_SD_SCK       = 12;
const uint8_t PIN_SD_MISO      = 13;
const uint8_t PIN_DS18B20      = 14;   // temperatura motor (pull-up 4.7k a 3.3V)
const uint8_t PIN_RPM          = 16;   // salida del optoacoplador de la bobina
const uint8_t PIN_HALL         = 17;   // sensor Hall de velocidad
const uint8_t PIN_NEUTRAL      = 18;   // ENT1: cable del foco de neutral (optoacoplador)
const uint8_t PIN_IGNICION     = 21;   // llave ON (optoacoplador)
const uint8_t PIN_LEDS         = 39;   // tira WS2812B (shift light)
const uint8_t PIN_RELE         = 40;   // relevador 1: bloqueo anti-robo (corte de motor)
const uint8_t PIN_GPS_RX       = 41;   // aquí llega el TX del GPS
const uint8_t PIN_GPS_TX       = 42;   // va al RX del GPS
const int8_t  PIN_BACKLIGHT_PWM = -1;  // 47 si quitas el jumper del backpack y usas transistor
const int8_t  PIN_PERIF_EN      = -1;  // 3 si pones un MOSFET que apague GPS y LEDs al dormir

// Corte de chispa (solo con USAR_CORTE_CHISPA 1). -1 = no instalado.
const int8_t  PIN_CORTE_CHISPA  = 47;  // placa B: PC817 + IRF840 al cable de paro (solo se usa con USAR_CORTE_CHISPA 1)
const int8_t  PIN_QS_SENSOR     = 48;  // placa B: J8 (ojo: en la copia N16R8 el GPIO48 también lleva el LED RGB)
const bool CHISPA_ACTIVO_ALTO   = true;  // true = HIGH prende el IRF840 = cable de paro a tierra = sin chispa
const bool QS_ACTIVO_BAJO       = true;  // el sensor de la palanca manda a tierra al pisar

const bool RELE_ACTIVO_ALTO     = true;  // true = HIGH energiza el relevador
const bool IGNICION_ACTIVA_BAJO = true;  // con optoacoplador: LOW = llave ON
// Placa B: el cable del foco de neutral tiene voltaje FUERA de neutral (prende el LED del PC817 = LOW) y en neutral
// se va a tierra (LED apagado, el pin lee HIGH)
const bool NEUTRAL_ACTIVO_BAJO  = false;

// Qué está conectado en las entradas aisladas libres (J6). Solo hay dos, así que las DOS direccionales van juntas a
// ENT3, cada una con su diodo 1N4007 (raya hacia ENT3): para avisar "dejaste la direccional" no importa el lado.
enum FuncionEntrada : uint8_t { ENT_LIBRE, ENT_FRENO, ENT_DIRECCIONAL, ENT_LUZ_ALTA };
const FuncionEntrada FUNCION_ENT2 = ENT_FRENO;         // cable de la luz de freno (12 V al frenar)
const FuncionEntrada FUNCION_ENT3 = ENT_DIRECCIONAL;   // las dos direccionales con diodo (parpadean)

// ---------- Direcciones I2C ----------
const uint8_t LCD_DIR   = 0x27;        // <-- X si no prende prueba 0x3F
const uint8_t MPU_DIR   = 0x69;        // MPU6050 con AD0 a 3.3V (0x68 lo usa el DS3231)
const uint8_t LCD_COLS  = 20;
const uint8_t LCD_FILAS = 4;

// ---------- Datos de la moto ----------
const float   TANQUE_LITROS        = 14.0f;    // <-- X capacidad del tanque
const float   CIRCUNF_RUEDA_MM     = 1880.0f;  // <-- X mide la llanta con el imán
const uint8_t IMANES_RUEDA         = 1;        // imanes en la rueda
const float   PULSOS_POR_REV       = 1.0f;     // <-- X chispas por vuelta del CDI
const int     RPM_ROJO             = 9000;     // <-- X zona roja
const int     RPM_MAX_BARRA        = 10000;
const int     RPM_MOTOR_ENCENDIDO  = 600;
const int     RALENTI_MIN          = 1300;     // <-- X
const int     RALENTI_MAX          = 1700;     // <-- X
const float   TEMP_MAX_C           = 110.0f;   // <-- X depende de dónde pegues el sensor
const float   RATIO_MARCHA_DEF[NUM_MARCHAS] = {160, 100, 74, 60, 51}; // <-- X rpm por km/h, calibra con "cal marcha N"
const float   KMPL_DEF             = 35.0f;    // <-- X rendimiento inicial km/l
const int     ZONA_HORARIA         = -7;       // Nayarit
const float   PISTA_OBJETIVO_KMH   = 60.0f;    // 0 a 60 km/h
const float   VEL_BLOQUEO_MENU     = 5.0f;     // arriba de esto no se ejecutan acciones
const float   VEL_MAX_CORTE        = 3.0f;     // el corte solo se activa casi parado
const bool    CORTE_POR_CAIDA      = false;    // true = cortar motor si detecta caída

// ---------- Shift light ----------
const float SHIFT_MIN = 5000, SHIFT_MAX = 8500, SHIFT_DEF = 7000; // <-- X
const float PERFIL_FACTOR[2] = {0.75f, 1.0f};  // ECO cambia antes, SPORT al punto óptimo
const float PID_KP = 0.8f, PID_KI = 0.05f, PID_KD = 0.1f;

// ---------- Baterías ----------
const float BAT_R1 = 100000.0f, BAT_R2 = 22000.0f;   // placa base v1: 22k (aguanta 16 V); el cableado viejo usaba 27k
const float LIPO_R1 = 100000.0f, LIPO_R2 = 100000.0f;
const float LIPO_FACTOR = 1.0f;               // <-- X ajusta contra multímetro
const float BAT_BAJA_V = 12.0f;
const float BAT_REPOSO_BUENA = 12.6f, BAT_REPOSO_DEBIL = 12.2f;
const float CARGA_MIN_V = 13.2f, CARGA_MAX_V = 15.0f;
const float ARRANQUE_DEBIL_V = 9.6f;
const float LIPO_MIN_V = 3.3f, LIPO_MAX_V = 4.2f;

// ---------- Gasolina ----------
const float GAS_MV_VACIO_DEF = 500.0f;        // <-- X calibra con "cal gas vacio"
const float GAS_MV_LLENO_DEF = 2800.0f;       // <-- X calibra con "cal gas lleno"
const float GAS_MV_FALLA_BAJO = 80.0f, GAS_MV_FALLA_ALTO = 3200.0f;
const int   GAS_CRITICA_PCT = 10;
const float AUTONOMIA_AVISO_KM = 25.0f;

// ---------- IMU ----------
const uint8_t EJE_ADELANTE = 0;              // <-- X 0=X 1=Y 2=Z según cómo montes el MPU
const float   SIGNO_ADELANTE = 1.0f;         // <-- X -1 si sale al revés
const float   CAIDA_GRADOS = 60.0f;
const uint32_t CAIDA_MS = 2000;
const float   FRENADA_G = 0.5f, ACELERON_G = 0.4f;

// ---------- Tiempos ----------
const uint32_t BTN_ANTIREBOTE_MS   = 30;
const uint32_t BTN_LARGO_MS        = 1000;
const uint32_t SPLASH_PASO_MS      = 250;
const uint32_t SPLASH_FINAL_MS     = 1500;
const uint32_t REFRESCO_LCD_MS     = 250;
const uint32_t TICK_MS             = 100;
const uint32_t FIN_VIAJE_MS        = 120000;   // llave apagada 2 min = fin de viaje
const uint32_t TIEMPO_A_DORMIR_MS  = 300000;   // 5 min sin llave ni botones
const uint32_t DESPERTAR_CADA_S    = 3600;     // revisa baterías cada hora dormido (con Telegram: lo que elijas, 15 min de fábrica)
const float    BAT_GUARDA_V        = 11.8f;    // protector: abajo de esto (en reposo) despierta poco y no prende el WiFi
const uint32_t DORMIR_GUARDA_S     = 4UL * 3600;
const uint32_t LOG_BAT_MS          = 600000;
const uint32_t NOTIF_MS            = 10000;
const uint32_t DIR_OLVIDADA_MS     = 20000;    // rodando con la direccional prendida más de esto = se te olvidó
const float    DIR_VEL_MIN         = 15.0f;    // abajo de esto no cuenta (esperando para dar vuelta)
const uint32_t AVISO_MS            = 2000;

// ---------- Red ----------
const char* AP_SSID     = "FT150TS-Dash";
const char* AP_PASS     = "12345678";          // <-- X déjala así y cada tarjeta genera su propia clave al azar
                                               //     (verla: comando "wifi clave" por USB o Bluetooth vinculado),
                                               //     o pon aquí tu clave (8 a 15 caracteres)
const char* STA_SSID    = "X";                 // <-- X WiFi de tu casa (para respaldo)
const char* STA_PASS    = "X";                 // <-- X
const char* BACKUP_URL  = "X";                 // <-- X ej. http://tuservidor/subir
#define BLE_NOMBRE   "FT150TS"
#define BLE_SERVICIO "6e400001-b5a3-f393-e0a9-e50e24dcca9e"
#define BLE_NOTIF    "6e400002-b5a3-f393-e0a9-e50e24dcca9e"   // app -> ESP32: texto de notificación
#define BLE_TELEM    "6e400003-b5a3-f393-e0a9-e50e24dcca9e"   // ESP32 -> app: datos en JSON
#define BLE_CMD      "6e400004-b5a3-f393-e0a9-e50e24dcca9e"   // app -> ESP32: comando de consola
#define BLE_RESP     "6e400005-b5a3-f393-e0a9-e50e24dcca9e"   // ESP32 -> app: respuesta del comando
#define BLE_OTA      "6e400006-b5a3-f393-e0a9-e50e24dcca9e"   // app -> ESP32: pedazos del firmware nuevo (OTA)

const uint32_t MAGIC_NVS = 0xF150A001;
const float RADIO_RUTA_M = 300.0f;

// ================================================================
// 3) OBJETOS Y VARIABLES GLOBALES
// ================================================================
LiquidCrystal_I2C lcd(LCD_DIR, LCD_COLS, LCD_FILAS);
TinyGPSPlus gps;
HardwareSerial GPSSerial(1);
RTC_DS3231 rtc;
OneWire oneWire(PIN_DS18B20);
DallasTemperature dsTemp(&oneWire);
Adafruit_NeoPixel leds(NUM_LEDS, PIN_LEDS, NEO_GRB + NEO_KHZ800);
Preferences prefs;
#if USAR_WIFI
WebServer server(80);
#endif

Persistente P;
DatosMoto   datos;
Viaje       g_viaje;

bool g_modoDemo = false;
bool g_rtcOk = false, g_imuOk = false, g_sdOk = false, g_tempOk = false, g_lcdOk = false;
bool g_nvsSucio = false;
uint32_t g_ultimoGuardado = 0;

// ADC filtrado
float g_mvBat = NAN, g_mvGas = NAN, g_mvLipo = NAN, g_mvLuz = NAN;
uint32_t g_ultimoAdc = 0;

// RPM y velocidad (interrupciones)
volatile uint32_t g_rpmUltUs = 0, g_rpmPerUs = 0;
volatile uint32_t g_hallUltUs = 0, g_hallPerUs = 0;
volatile bool     g_hallVisto = false;
float g_rpmFilt = 0;
// Diagnóstico de encendido (lo llena isrRpm, solo con números enteros: en una
// interrupción no se usa el FPU)
volatile uint32_t g_pulsos = 0;           // chispas contadas desde que arrancó
volatile uint32_t g_chispaFaltas = 0;     // pulso que llegó al doble de lo esperado = chispa que faltó
volatile uint32_t g_irrSuma = 0, g_irrN = 0;  // variación entre pulsos seguidos (por mil)
volatile bool     g_cortandoChispa = false;   // mientras se corta a propósito no se cuentan faltas

// GPS
uint32_t g_gpsChars = 0, g_gpsUltChar = 0;
bool g_gpsRtcSync = false;
// GPS del teléfono (lo manda la app por Bluetooth si no hay módulo GPS con señal)
double g_gpsExtLat = 0, g_gpsExtLon = 0;
float  g_gpsExtVel = NAN;
uint32_t g_gpsExtHasta = 0;
bool g_gpsExterno = false;

// IMU
float g_acc[3] = {0, 0, 1}, g_accLento[3] = {0, 0, 1};
uint32_t g_ultImu = 0, g_inclDesde = 0, g_frenDesde = 0, g_aceDesde = 0, g_rectoDesde = 0;
bool g_caida = false, g_corteCaida = false;

// Temperatura
bool g_tempPendiente = false;
uint32_t g_tempT0 = 0, g_tempUlt = 0;
float g_tempHist[7]; uint8_t g_tempIdx = 0; uint8_t g_tempN = 0; uint32_t g_tempHistUlt = 0;

// Botones
Boton g_btn[3] = {
  {PIN_BTN_ARRIBA, HIGH, HIGH, 0, 0, false},
  {PIN_BTN_ABAJO,  HIGH, HIGH, 0, 0, false},
  {PIN_BTN_OK,     HIGH, HIGH, 0, 0, false},
};

// Pantalla
char  g_cache[LCD_FILAS][LCD_COLS + 1];
Vista g_vista = V_PRINCIPAL;
uint8_t g_selMant = 0, g_selAjuste = 0, g_pagDiag = 0;
char  g_aviso[24] = "";
uint32_t g_avisoHasta = 0;
uint32_t g_ultLcd = 0;

// Estado motor y viaje
bool g_motorEnc = false;
uint32_t g_rpmAltoDesde = 0, g_rpmBajoDesde = 0;
uint32_t g_ultIgnOn = 0, g_ultActividad = 0, g_inicioViajeMs = 0;
float g_vMinArranque = 99;
uint32_t g_vMinArranqueT = 0;
bool g_arranqueDebil = false;
float g_velPrev = 0, g_accelKmhs = 0;
uint32_t g_ultTick = 0;

// Ralentí
float g_ralenti = 0; uint32_t g_ralentiDesde = 0; bool g_ralentiMedido = false;

// Alternador
uint32_t g_cargaMalaDesde = 0; uint8_t g_estadoCarga = 0; // 0 ? 1 ok 2 no carga 3 sobrecarga

// Shift light / aprendizaje
float g_accBin[NUM_MARCHAS][BINS_RPM];
uint8_t g_accCnt[NUM_MARCHAS][BINS_RPM];
float g_shiftActual[NUM_MARCHAS], g_pidInt[NUM_MARCHAS], g_pidErrPrev[NUM_MARCHAS];
uint32_t g_ultLeds = 0;

// Pista
bool g_pistaActiva = false, g_pistaCorriendo = false;
uint32_t g_pistaT0 = 0;
float g_pistaUltimo = 0, g_pistaVmax = 0, g_pistaGmax = 0; int g_pistaRpmMax = 0;

// Eventos
EventoReg g_evt[NUM_EVT_RAM]; uint8_t g_evtIdx = 0;
uint32_t g_evtUltimo[EVT_TOTAL];

// Notificaciones
char g_notif[21] = "";
uint32_t g_notifHasta = 0;
volatile bool g_bleConectado = false;
volatile bool g_notifNueva = false;
char g_notifBuf[21] = "";

// iPhone
EstadoIphone g_iphone;

// Baterías
uint32_t g_ultLogBat = 0;
bool g_alertaDescMoto = false, g_alertaDescLipo = false;

// Red
uint32_t g_ultBackupIntento = 0;
bool g_wifiIniciado = false;

// Placa B: entradas aisladas, relevadores 2 y 3, salida aislada y carga de la celda (sección 21c)
uint32_t g_dirUltPulso = 0, g_dirRodandoMs = 0;  // último parpadeo de la direccional · tiempo rodando con ella prendida
bool g_frenoAntes = false;
uint32_t g_frenadas = 0;                         // veces que se pisó el freno desde que prendió la tarjeta
uint32_t g_frenoUltimo = 0;                      // última vez que se vio la luz de freno
bool g_rele2 = false, g_rele3 = false, g_salida = false;
bool g_modoSeguro = false;        // guardián (21h): 3 reinicios por falla seguidos
uint32_t g_rele2Hasta = 0, g_rele3Hasta = 0, g_salidaHasta = 0;  // apagado automático (0 = sin tiempo)
bool g_cargando = false;
// Luz que manda el teléfono (sin LDR): 0-100, -1 = nada reciente
int g_luzApp = -1;
uint32_t g_luzAppMs = 0;

// Firmware nuevo desde la app (OTA, ver 28b): se está recibiendo
volatile bool g_otaActivo = false, g_otaError = false;
volatile uint32_t g_otaRecibido = 0, g_otaTotal = 0, g_otaUltimo = 0;

// Simulaciones de demo
uint32_t g_simCaidaHasta = 0, g_simFrenadaHasta = 0;

// Íconos 5x8
uint8_t BMP_BAT[8]    = {0b01110, 0b11111, 0b10001, 0b10001, 0b11111, 0b11111, 0b11111, 0b11111};
uint8_t BMP_GAS[8]    = {0b00100, 0b00100, 0b01110, 0b01110, 0b11111, 0b11111, 0b01110, 0b00000};
uint8_t BMP_TEMP[8]   = {0b00100, 0b01010, 0b01010, 0b01010, 0b01110, 0b11111, 0b11111, 0b01110};
uint8_t BMP_ALERTA[8] = {0b00100, 0b00100, 0b01010, 0b01010, 0b10001, 0b10101, 0b11111, 0b00000};
uint8_t BMP_BT[8]     = {0b00100, 0b10110, 0b01101, 0b00110, 0b01101, 0b10110, 0b00100, 0b00000};
uint8_t BMP_LLAVE[8]  = {0b10001, 0b10001, 0b11111, 0b01110, 0b00100, 0b00100, 0b00100, 0b00100};
uint8_t BMP_GPS[8]    = {0b01110, 0b10001, 0b10101, 0b10001, 0b01010, 0b00100, 0b00000, 0b00000};

// Fuente grande del splash: solo bloques llenos (0xFF), así se ve
// igual en el simulador y en el LCD real. 4 renglones de alto.
Glifo FUENTE[] = {
  {'F', 3, {0b111, 0b100, 0b110, 0b100}},
  {'T', 3, {0b111, 0b010, 0b010, 0b010}},
  {'1', 2, {0b11,  0b01,  0b01,  0b01}},
  {'5', 3, {0b111, 0b110, 0b001, 0b111}},
  {'0', 3, {0b111, 0b101, 0b101, 0b111}},
};
const char* TEXTO_SPLASH = "FT150";

const char* NOMBRE_EVT[EVT_TOTAL] = {
  "caida", "frenada", "aceleron", "arranque", "corte",
  "sobre_rpm", "bat_baja", "gas_critica", "temp_alta", "no_carga", "movida", "vibra_rara"
};
const char* NOMBRE_VISTA[V_TOTAL] = {
  "principal", "iphone", "viaje", "comparar", "mantenimiento", "baterias", "diagnostico", "pista", "ajustes"
};

// ================================================================
// 4) UTILIDADES
// ================================================================
char ico(Icono i) {
#if USAR_ICONOS
  return (char)i;
#else
  switch (i) {
    case ICO_BAT:    return 'B';
    case ICO_GAS:    return 'G';
    case ICO_TEMP:   return 'T';
    case ICO_ALERTA: return '!';
    case ICO_BT:     return 'N';
    case ICO_LLAVE:  return 'M';
    case ICO_GPS:    return 'S';
  }
  return '?';
#endif
}

float ema(float previo, float nuevo, float alfa) {
  return isnan(previo) ? nuevo : previo + alfa * (nuevo - previo);
}

float distanciaM(double la1, double lo1, double la2, double lo2) {
  const double R = 6371000.0;
  double dLa = radians(la2 - la1), dLo = radians(lo2 - lo1);
  double a = sin(dLa / 2) * sin(dLa / 2) + cos(radians(la1)) * cos(radians(la2)) * sin(dLo / 2) * sin(dLo / 2);
  return (float)(R * 2 * atan2(sqrt(a), sqrt(1 - a)));
}

DateTime ahora() {
  if (g_rtcOk) return rtc.now();
  return DateTime(2026, 1, 1, 0, 0, 0) + TimeSpan((int32_t)(millis() / 1000));
}

uint32_t ymd(const DateTime& d) {
  return d.year() * 10000UL + d.month() * 100UL + d.day();
}

uint32_t ahoraEpoch() { return ahora().unixtime(); }

void aviso(const char* txt) {
  strncpy(g_aviso, txt, sizeof(g_aviso) - 1);
  g_aviso[sizeof(g_aviso) - 1] = '\0';
  g_avisoHasta = millis() + AVISO_MS;
}

// ================================================================
// 5) MEMORIA PERSISTENTE (NVS)
// ================================================================
void nvsDefaults() {
  memset(&P, 0, sizeof(P));
  P.magic = MAGIC_NVS;
  P.perfil = 0;
  P.fuenteVel = 0;
  P.autoBrillo = true;
  P.wifiOn = true;
  P.corteActivo = false;
  P.gasMvVacio = GAS_MV_VACIO_DEF;
  P.gasMvLleno = GAS_MV_LLENO_DEF;
  P.batFactor = 1.0f;
  for (uint8_t i = 0; i < NUM_MARCHAS; i++) {
    P.ratioMarcha[i] = RATIO_MARCHA_DEF[i];
    P.shiftAprendido[i] = SHIFT_DEF;
  }
  P.imuRef[0] = 0; P.imuRef[1] = 0; P.imuRef[2] = 1;
  P.kmPorLitro = KMPL_DEF;
  // Mantenimiento: nombre, cada cuántos km, cada cuántos días   <-- X
  const char* nombres[NUM_MANT] = {"Cadena", "Aceite", "Filtro", "Bujia", "Frenos"};
  const uint16_t km[NUM_MANT]    = {500, 2000, 4000, 6000, 4000};
  const uint16_t dias[NUM_MANT]  = {30, 90, 180, 365, 180};
  for (uint8_t i = 0; i < NUM_MANT; i++) {
    strncpy(P.mant[i].nombre, nombres[i], sizeof(P.mant[i].nombre) - 1);
    P.mant[i].intKm = km[i];
    P.mant[i].intDias = dias[i];
    P.mant[i].kmUltimo = 0;
    P.mant[i].epochUltimo = 0;
  }
}

void nvsCargar() {
  prefs.begin("ft150", false);
  size_t n = prefs.getBytesLength("p");
  bool ok = false;
  if (n == sizeof(Persistente)) {
    prefs.getBytes("p", &P, sizeof(P));
    ok = (P.magic == MAGIC_NVS);
  }
  if (!ok) {
    nvsDefaults();
    prefs.putBytes("p", &P, sizeof(P));
  }
}

void nvsGuardar() {
  if (g_modoDemo) return;   // el demo nunca ensucia tus datos reales
  prefs.putBytes("p", &P, sizeof(P));
  g_nvsSucio = false;
  g_ultimoGuardado = millis();
}

// ================================================================
// 6) TARJETA SD (bitácoras CSV)
// ================================================================
void sdBegin() {
  SPI.begin(PIN_SD_SCK, PIN_SD_MISO, PIN_SD_MOSI, PIN_SD_CS);
  g_sdOk = SD.begin(PIN_SD_CS);
}

void sdAgregar(const char* archivo, const char* encabezado, const char* linea) {
  if (!g_sdOk || g_modoDemo) return;
  bool nuevo = !SD.exists(archivo);
  File f = SD.open(archivo, FILE_APPEND);
  if (!f) { g_sdOk = false; return; }
  if (nuevo) f.println(encabezado);
  f.println(linea);
  f.close();
}

void fechaTexto(char* b, size_t n, const DateTime& d) {
  snprintf(b, n, "%04d-%02d-%02d %02d:%02d:%02d", d.year(), d.month(), d.day(), d.hour(), d.minute(), d.second());
}

void registrarEvento(TipoEvento t, float valor) {
  uint32_t ms = millis();
  // Eventos instantáneos: máx 1 cada 10 s. Estados que duran (gasolina
  // crítica, motor caliente...): máx 1 cada 10 min para no llenar la SD.
  bool estado = (t == EVT_GAS_CRITICA || t == EVT_TEMP_ALTA || t == EVT_BAT_BAJA || t == EVT_SOBRE_RPM || t == EVT_NO_CARGA ||
                 t == EVT_VIBRA);
  uint32_t espera = estado ? 600000UL : 10000UL;
  if (g_evtUltimo[t] != 0 && ms - g_evtUltimo[t] < espera) return;
  g_evtUltimo[t] = ms;
  g_evt[g_evtIdx].epoch = ahoraEpoch();
  g_evt[g_evtIdx].tipo = t;
  g_evt[g_evtIdx].valor = valor;
  g_evtIdx = (g_evtIdx + 1) % NUM_EVT_RAM;

  char f[24], l[120];
  fechaTexto(f, sizeof f, ahora());
  snprintf(l, sizeof l, "%s,%s,%.2f,%.6f,%.6f", f, NOMBRE_EVT[t], valor, datos.lat, datos.lon);
  sdAgregar("/eventos.csv", "fecha,tipo,valor,lat,lon", l);
  Serial.printf("[evento] %s %.2f\n", NOMBRE_EVT[t], valor);
}

void logBaterias() {
  char f[24], l[96];
  fechaTexto(f, sizeof f, ahora());
  uint8_t estado = g_motorEnc ? 2 : (datos.ignicion ? 1 : 0);
  snprintf(l, sizeof l, "%s,%.2f,%.2f,%d,%.1f", f, datos.vMoto, datos.vLipo, estado, datos.tempC);
  sdAgregar("/bateria.csv", "fecha,v_moto,v_lipo,estado(0off 1llave 2motor),temp", l);
}

// ================================================================
// 7) SENSORES ANALÓGICOS
// ================================================================
float leerMv(uint8_t pin, uint8_t n) {
  uint32_t s = 0;
  for (uint8_t i = 0; i < n; i++) s += analogReadMilliVolts(pin);
  return s / (float)n;
}

void adcBegin() {
  analogReadResolution(12);
  analogSetPinAttenuation(PIN_ADC_BATERIA, ADC_11db);
  analogSetPinAttenuation(PIN_ADC_GASOLINA, ADC_11db);
  analogSetPinAttenuation(PIN_ADC_LIPO, ADC_11db);
  if (!hayLdr()) return;
  analogSetPinAttenuation(PIN_ADC_LUZ, ADC_11db);
}

/** ¿J11 tiene la LDR? (con la INT del MPU ahí, ese pin NO se lee como analógico: se desconfiguraría la alarma) */
bool hayLdr() { return PIN_MPU_INT != (int8_t)PIN_ADC_LUZ; }

void adcActualizar() {
  uint32_t ms = millis();
  if (ms - g_ultimoAdc < 20) return;
  g_ultimoAdc = ms;
  g_mvBat  = ema(g_mvBat,  leerMv(PIN_ADC_BATERIA, 8), 0.05f);
  g_mvGas  = ema(g_mvGas,  leerMv(PIN_ADC_GASOLINA, 8), 0.01f);
  g_mvLipo = ema(g_mvLipo, leerMv(PIN_ADC_LIPO, 4), 0.05f);
  if (hayLdr()) g_mvLuz = ema(g_mvLuz, leerMv(PIN_ADC_LUZ, 4), 0.05f);
}

float voltajeMoto() {
  if (isnan(g_mvBat)) return NAN;
  return g_mvBat / 1000.0f * (BAT_R1 + BAT_R2) / BAT_R2 * P.batFactor;
}

float voltajeLipo() {
  if (isnan(g_mvLipo)) return NAN;
  return g_mvLipo / 1000.0f * (LIPO_R1 + LIPO_R2) / LIPO_R2 * LIPO_FACTOR;
}

int porcentajeGas() {
  if (isnan(g_mvGas) || g_mvGas < GAS_MV_FALLA_BAJO || g_mvGas > GAS_MV_FALLA_ALTO) return -1;
  float rango = P.gasMvLleno - P.gasMvVacio;
  if (fabs(rango) < 50) return -1;
  float pct = (g_mvGas - P.gasMvVacio) * 100.0f / rango;
  return (int)constrain(pct + 0.5f, 0.0f, 100.0f);
}

int porcentajeLuz() {
  // Sin LDR: la que mandó el teléfono en el último minuto (la app la manda cada 10 s)
  if (!hayLdr()) return (g_luzApp >= 0 && millis() - g_luzAppMs < 60000) ? g_luzApp : -1;
  if (isnan(g_mvLuz)) return -1;
  return (int)constrain(g_mvLuz * 100.0f / 3300.0f, 0.0f, 100.0f);
}

int porcentajeLipo(float v) {
  if (isnan(v)) return -1;
  return (int)constrain((v - LIPO_MIN_V) * 100.0f / (LIPO_MAX_V - LIPO_MIN_V), 0.0f, 100.0f);
}

// ================================================================
// 8) RPM Y VELOCIDAD (interrupciones)
// ================================================================
void IRAM_ATTR isrRpm() {
  uint32_t t = micros();
  uint32_t d = t - g_rpmUltUs;
  if (d < 4000) return;          // filtro de rebote / ruido (> 15000 rpm)
  uint32_t ant = g_rpmPerUs;
  g_pulsos++;
  // Entre 1500 y 9000 rpm (periodos de 6.6 a 40 ms) y sin corte propio
  if (!g_cortandoChispa && ant >= 6600 && ant <= 40000 && d < 100000) {
    if (d * 10 > ant * 17 && d * 10 < ant * 23) g_chispaFaltas++;
    else if (d * 10 < ant * 13 && d * 10 > ant * 7) {
      uint32_t dif = d > ant ? d - ant : ant - d;
      g_irrSuma += dif * 1000 / ant;
      g_irrN++;
    }
  }
  g_rpmPerUs = d;
  g_rpmUltUs = t;
}

void IRAM_ATTR isrHall() {
  uint32_t t = micros();
  uint32_t d = t - g_hallUltUs;
  if (d < 15000) return;         // filtro (> ~450 km/h)
  g_hallPerUs = d;
  g_hallUltUs = t;
  g_hallVisto = true;
}

int rpmInstantanea() {
  noInterrupts();
  uint32_t per = g_rpmPerUs, ult = g_rpmUltUs;
  interrupts();
  if (per == 0 || micros() - ult > 300000) return 0;
  return (int)(60000000.0f / (per * PULSOS_POR_REV));
}

float velocidadHall() {
  if (!g_hallVisto) return NAN;  // sin sensor instalado
  noInterrupts();
  uint32_t per = g_hallPerUs, ult = g_hallUltUs;
  interrupts();
  if (per == 0 || micros() - ult > 2500000) return 0;
  float metros = CIRCUNF_RUEDA_MM / 1000.0f / IMANES_RUEDA;
  return metros / (per / 1000000.0f) * 3.6f;
}

// ================================================================
// 9) GPS
// ================================================================
void gpsActualizar() {
  while (GPSSerial.available()) {
    gps.encode(GPSSerial.read());
    g_gpsUltChar = millis();
  }
  if (g_modoDemo) return;
  datos.gpsFix = gps.location.isValid() && gps.location.age() < 3000;
  if (datos.gpsFix) {
    datos.lat = gps.location.lat();
    datos.lon = gps.location.lng();
  }
  datos.sats = gps.satellites.isValid() ? gps.satellites.value() : 0;
  datos.velGps = (gps.speed.isValid() && gps.speed.age() < 3000) ? gps.speed.kmph() : NAN;

  // Sincroniza el reloj con la hora del GPS una vez por encendido
  if (!g_gpsRtcSync && g_rtcOk && datos.gpsFix && gps.date.isValid() && gps.time.isValid() && gps.date.year() > 2024) {
    DateTime utc(gps.date.year(), gps.date.month(), gps.date.day(), gps.time.hour(), gps.time.minute(), gps.time.second());
    rtc.adjust(utc + TimeSpan(ZONA_HORARIA * 3600L));
    g_gpsRtcSync = true;
  }

  // Sin señal del módulo: usa la ubicación que manda el teléfono
  g_gpsExterno = false;
  if (!datos.gpsFix && millis() < g_gpsExtHasta) {
    datos.gpsFix = true;
    datos.lat = g_gpsExtLat;
    datos.lon = g_gpsExtLon;
    datos.velGps = g_gpsExtVel;
    g_gpsExterno = true;
  }
}

bool gpsFuncionando() { return g_gpsUltChar != 0 && millis() - g_gpsUltChar < 5000; }

bool gpsVelBuena() {
  if (!datos.gpsFix || isnan(datos.velGps)) return false;
  if (g_modoDemo || g_gpsExterno) return true;
  return gps.hdop.isValid() && gps.hdop.hdop() < 2.5;
}

float elegirVelocidad() {
  bool g = gpsVelBuena();
  float h = datos.velHall;
  switch (P.fuenteVel) {
    case 1: return isnan(h) ? NAN : h;
    case 2: return g ? datos.velGps : h;
    default:
      if (g && datos.velGps > 5) return datos.velGps;
      if (!isnan(h)) return h;
      if (g) return datos.velGps;
      return NAN;
  }
}

// ================================================================
// 10) ACELERÓMETRO MPU6050 (sin librería)
// ================================================================
bool imuEscribir(uint8_t reg, uint8_t val) {
  Wire.beginTransmission(MPU_DIR);
  Wire.write(reg);
  Wire.write(val);
  return Wire.endTransmission() == 0;
}

bool imuBegin() {
  Wire.beginTransmission(MPU_DIR);
  Wire.write(0x75);                       // WHO_AM_I
  if (Wire.endTransmission(false) != 0) return false;
  if (Wire.requestFrom((uint8_t)MPU_DIR, (uint8_t)1) != 1) return false;
  Wire.read();
  imuEscribir(0x6B, 0x00);                // despertar
  imuEscribir(0x1C, 0x08);                // ±4 g
  imuEscribir(0x1A, 0x03);                // filtro pasa bajas ~44 Hz
  imuEscribir(0x19, 9);                   // 100 muestras por segundo (las usa la IA de vibraciones por la FIFO)
  imuEscribir(0x37, 0x20);                // pin INT: activo en alto y se queda prendido hasta leer INT_STATUS
  imuEscribir(0x38, 0x00);                // sin interrupciones (la alarma las prende al estacionarse)
  imuLeer(0x3A);
  return true;
}

uint8_t imuLeer(uint8_t reg) {
  Wire.beginTransmission(MPU_DIR);
  Wire.write(reg);
  if (Wire.endTransmission(false) != 0) return 0;
  if (Wire.requestFrom((uint8_t)MPU_DIR, (uint8_t)1) != 1) return 0;
  return Wire.read();
}

void imuActualizar() {
  if (!g_imuOk || g_modoDemo) return;
  uint32_t ms = millis();
  if (ms - g_ultImu < 20) return;
  g_ultImu = ms;
  Wire.beginTransmission(MPU_DIR);
  Wire.write(0x3B);
  if (Wire.endTransmission(false) != 0) return;
  if (Wire.requestFrom((uint8_t)MPU_DIR, (uint8_t)6) != 6) return;
  for (uint8_t i = 0; i < 3; i++) {
    int16_t raw = (Wire.read() << 8) | Wire.read();
    float g = raw / 8192.0f;
    g_acc[i] = g_acc[i] + 0.3f * (g - g_acc[i]);
    g_accLento[i] = g_accLento[i] + 0.05f * (g - g_accLento[i]);
  }
  // Inclinación = ángulo entre la gravedad actual y la de referencia (moto derecha)
  float dot = 0, n1 = 0, n2 = 0;
  for (uint8_t i = 0; i < 3; i++) {
    dot += g_accLento[i] * P.imuRef[i];
    n1 += g_accLento[i] * g_accLento[i];
    n2 += P.imuRef[i] * P.imuRef[i];
  }
  if (n1 > 0.01f && n2 > 0.01f) {
    float c = constrain(dot / sqrt(n1 * n2), -1.0f, 1.0f);
    datos.incl = degrees(acos(c));
  }
  datos.aFwd = (g_acc[EJE_ADELANTE] - P.imuRef[EJE_ADELANTE]) * SIGNO_ADELANTE;
  bachesRevisar();
}

void imuCalibrar() {
  for (uint8_t i = 0; i < 3; i++) P.imuRef[i] = g_accLento[i];
  nvsGuardar();
}

void revisarCaidasYFrenadas() {
  uint32_t ms = millis();
  float v = isnan(datos.vel) ? 0 : datos.vel;

  // Caída: muy inclinada, casi sin velocidad, durante CAIDA_MS
  if (!isnan(datos.incl) && datos.incl > CAIDA_GRADOS && v < 5) {
    if (g_inclDesde == 0) g_inclDesde = ms;
    if (!g_caida && ms - g_inclDesde > CAIDA_MS) {
      g_caida = true;
      registrarEvento(EVT_CAIDA, datos.incl);
      if (CORTE_POR_CAIDA) { g_corteCaida = true; registrarEvento(EVT_CORTE, 1); }
    }
    g_rectoDesde = 0;
  } else {
    g_inclDesde = 0;
    if (g_caida && !isnan(datos.incl) && datos.incl < 30) {
      if (g_rectoDesde == 0) g_rectoDesde = ms;
      if (ms - g_rectoDesde > 3000) g_caida = false;   // ya se levantó
    }
  }

  // Frenada brusca / acelerón
  // Con sensor de freno: solo cuenta si de verdad frenaste (un bache también da un jalón hacia atrás)
  bool frenoReal = !hayFreno() || millis() - g_frenoUltimo < 1500;
  if (datos.aFwd < -FRENADA_G && v > 15 && frenoReal) {
    if (g_frenDesde == 0) g_frenDesde = ms;
    if (ms - g_frenDesde > 250) registrarEvento(EVT_FRENADA, datos.aFwd);
  } else g_frenDesde = 0;

  if (datos.aFwd > ACELERON_G) {
    if (g_aceDesde == 0) g_aceDesde = ms;
    if (ms - g_aceDesde > 250) registrarEvento(EVT_ACELERON, datos.aFwd);
  } else g_aceDesde = 0;
}

// ================================================================
// 11) TEMPERATURA DEL MOTOR (DS18B20, sin bloquear)
// ================================================================
void tempBegin() {
  dsTemp.begin();
  g_tempOk = dsTemp.getDeviceCount() > 0;
  dsTemp.setWaitForConversion(false);
}

void tempActualizar() {
  if (!g_tempOk || g_modoDemo) return;
  uint32_t ms = millis();
  if (!g_tempPendiente && ms - g_tempUlt > 1000) {
    dsTemp.requestTemperatures();
    g_tempPendiente = true;
    g_tempT0 = ms;
  } else if (g_tempPendiente && ms - g_tempT0 > 800) {
    float c = dsTemp.getTempCByIndex(0);
    if (c > -50 && c < 200 && c != 85.0f) datos.tempC = c;
    g_tempPendiente = false;
    g_tempUlt = ms;
  }
}

void tempHistorial() {
  if (isnan(datos.tempC) || millis() - g_tempHistUlt < 10000) return;
  g_tempHistUlt = millis();
  g_tempHist[g_tempIdx] = datos.tempC;
  g_tempIdx = (g_tempIdx + 1) % 7;
  if (g_tempN < 7) g_tempN++;
}

// °C por minuto según los últimos 60 s
float tempPendiente() {
  if (g_tempN < 7) return 0;
  float viejo = g_tempHist[g_tempIdx];                      // el más antiguo
  float nuevo = g_tempHist[(g_tempIdx + 6) % 7];
  return nuevo - viejo;
}

// ================================================================
// 12) MARCHA E IGNICIÓN
// ================================================================
bool leerNeutral() {
  int v = digitalRead(PIN_NEUTRAL);
  return NEUTRAL_ACTIVO_BAJO ? v == LOW : v == HIGH;
}

bool leerIgnicion() {
#if USAR_IGNICION
  int v = digitalRead(PIN_IGNICION);
  return IGNICION_ACTIVA_BAJO ? v == LOW : v == HIGH;
#else
  return g_motorEnc;
#endif
}

int calcularMarcha(float v, int rpm, bool neutral) {
  if (neutral) return 0;
  if (isnan(v) || v < 3 || rpm < RPM_MOTOR_ENCENDIDO) return -1;
  float r = rpm / v;
  int mejor = -1;
  float mejorErr = 1e9;
  for (uint8_t i = 0; i < NUM_MARCHAS; i++) {
    float e = fabs(r - P.ratioMarcha[i]) / P.ratioMarcha[i];
    if (e < mejorErr) { mejorErr = e; mejor = i; }
  }
  return mejorErr < 0.15f ? mejor + 1 : -1;
}

// ================================================================
// 13) BOTONES
// ================================================================
void botonesBegin() {
  for (uint8_t i = 0; i < 3; i++) pinMode(g_btn[i].pin, INPUT_PULLUP);
}

Evento botonesLeer() {
  uint32_t ms = millis();
  for (uint8_t i = 0; i < 3; i++) {
    Boton& b = g_btn[i];
    bool lectura = digitalRead(b.pin);
    if (lectura != b.ultima) { b.ultima = lectura; b.tCambio = ms; }
    if (ms - b.tCambio >= BTN_ANTIREBOTE_MS && lectura != b.estable) {
      b.estable = lectura;
      if (b.estable == LOW) {
        b.tPresion = ms;
        b.largoEmitido = false;
        if (i == 0) return EV_ARRIBA;
        if (i == 1) return EV_ABAJO;
      } else if (i == 2 && !b.largoEmitido) {
        return EV_OK;
      }
    }
    if (i == 2 && b.estable == LOW && !b.largoEmitido && ms - b.tPresion >= BTN_LARGO_MS) {
      b.largoEmitido = true;
      return EV_OK_LARGO;
    }
  }
  return EV_NINGUNO;
}

// ================================================================
// 14) PANTALLA: base, íconos y splash
// ================================================================
void cargarIconos() {
#if USAR_ICONOS
  lcd.createChar(ICO_BAT, BMP_BAT);
  lcd.createChar(ICO_GAS, BMP_GAS);
  lcd.createChar(ICO_TEMP, BMP_TEMP);
  lcd.createChar(ICO_ALERTA, BMP_ALERTA);
  lcd.createChar(ICO_BT, BMP_BT);
  lcd.createChar(ICO_LLAVE, BMP_LLAVE);
  lcd.createChar(ICO_GPS, BMP_GPS);
#endif
}

void limpiarCache() { memset(g_cache, 0, sizeof(g_cache)); }

void escribirFila(uint8_t r, char* buf) {
  size_t n = strlen(buf);
  for (; n < LCD_COLS; n++) buf[n] = ' ';
  buf[LCD_COLS] = '\0';
  if (memcmp(g_cache[r], buf, LCD_COLS) == 0) return;
  memcpy(g_cache[r], buf, LCD_COLS);
  lcd.setCursor(0, r);
  for (uint8_t i = 0; i < LCD_COLS; i++) lcd.write((uint8_t)buf[i]);
}

void pantallaBegin() {
  Wire.beginTransmission(LCD_DIR);
  g_lcdOk = (Wire.endTransmission() == 0);
  lcd.init();
  lcd.backlight();
  lcd.clear();
  if (PIN_BACKLIGHT_PWM >= 0) ledcAttach(PIN_BACKLIGHT_PWM, 5000, 8);
}

const Glifo* buscarGlifo(char c) {
  for (uint8_t k = 0; k < sizeof(FUENTE) / sizeof(FUENTE[0]); k++)
    if (FUENTE[k].c == c) return &FUENTE[k];
  return nullptr;
}

void pantallaSplash() {
  lcd.clear();
  uint8_t x = 0;
  for (uint8_t i = 0; TEXTO_SPLASH[i]; i++) {
    const Glifo* g = buscarGlifo(TEXTO_SPLASH[i]);
    if (!g) continue;
    for (uint8_t fila = 0; fila < 4; fila++) {
      for (uint8_t col = 0; col < g->ancho; col++) {
        bool on = (g->f[fila] >> (g->ancho - 1 - col)) & 1;
        lcd.setCursor(x + col, fila);
        lcd.write(on ? (uint8_t)0xFF : (uint8_t)' ');
      }
    }
    x += g->ancho + 1;
    delay(SPLASH_PASO_MS);
  }
  lcd.setCursor(LCD_COLS - 2, 3);
  lcd.print("TS");
  delay(SPLASH_FINAL_MS);
  lcd.clear();
  cargarIconos();
  limpiarCache();
}

void pantallaIrA(Vista v) {
  g_vista = v;
  lcd.clear();
  limpiarCache();
  g_ultLcd = 0;
}

void brilloActualizar() {
  datos.luz = porcentajeLuz();
  if (PIN_BACKLIGHT_PWM < 0) return;
  int duty = 255;
  if (P.autoBrillo && datos.luz >= 0) duty = map(datos.luz, 0, 100, 40, 255);
  ledcWrite(PIN_BACKLIGHT_PWM, duty);
}

// ================================================================
// 15) MANTENIMIENTO
// ================================================================
float mantKmDesde(uint8_t i) { return P.odometro - P.mant[i].kmUltimo; }

int mantDiasDesde(uint8_t i) {
  if (P.mant[i].epochUltimo == 0 || !g_rtcOk) return -1;
  uint32_t a = ahoraEpoch();
  if (a < P.mant[i].epochUltimo) return 0;
  return (a - P.mant[i].epochUltimo) / 86400UL;
}

bool mantVencido(uint8_t i) {
  if (mantKmDesde(i) >= P.mant[i].intKm) return true;
  int d = mantDiasDesde(i);
  return d >= 0 && d >= P.mant[i].intDias;
}

int mantPrimeroVencido() {
  for (uint8_t i = 0; i < NUM_MANT; i++) if (mantVencido(i)) return i;
  return -1;
}

void mantRegistrar(uint8_t i) {
  P.mant[i].kmUltimo = P.odometro;
  P.mant[i].epochUltimo = g_rtcOk ? ahoraEpoch() : 0;
  nvsGuardar();
}

// ================================================================
// 16) VIAJES, RESUMEN DIARIO Y RUTAS
// ================================================================
void revisarCambioDia() {
  uint32_t d = ymd(ahora());
  if (!g_rtcOk) return;
  if (P.diaHoy == 0) { P.diaHoy = d; g_nvsSucio = true; return; }
  if (d == P.diaHoy) return;
  if (P.hoy.km > 0.5f) {
    if (P.prom.km < 0.01f) P.prom = P.hoy;
    else {
      P.prom.km = P.prom.km * 0.8f + P.hoy.km * 0.2f;
      P.prom.litros = P.prom.litros * 0.8f + P.hoy.litros * 0.2f;
      P.prom.segMov = (uint32_t)(P.prom.segMov * 0.8f + P.hoy.segMov * 0.2f);
      P.prom.velMax = P.prom.velMax * 0.8f + P.hoy.velMax * 0.2f;
    }
  }
  P.ayer = P.hoy;
  memset(&P.hoy, 0, sizeof(P.hoy));
  P.diaHoy = d;
  nvsGuardar();
}

void viajeIniciar() {
  memset(&g_viaje, 0, sizeof(g_viaje));
  g_viaje.activo = true;
  g_viaje.epochInicio = ahoraEpoch();
  g_viaje.gasRef = datos.gasPct >= 0 ? datos.gasPct : -1;
  g_viaje.gasMin = g_viaje.gasRef;
  g_inicioViajeMs = millis();
}

float viajeLitros() {
  float l = g_viaje.litrosAcum;
  if (g_viaje.gasRef >= 0 && g_viaje.gasMin >= 0)
    l += (g_viaje.gasRef - g_viaje.gasMin) / 100.0f * TANQUE_LITROS;
  return max(l, 0.0f);
}

int rutaBuscarDesde(double la, double lo) {
  int mejor = -1;
  for (uint8_t i = 0; i < NUM_RUTAS; i++) {
    Ruta& r = P.rutas[i];
    if (r.veces < 2) continue;
    if (distanciaM(la, lo, r.latI, r.lonI) > RADIO_RUTA_M) continue;
    if (mejor < 0 || r.veces > P.rutas[mejor].veces) mejor = i;
  }
  return mejor;
}

void rutaRegistrar(double laI, double loI, double laF, double loF, float minutos, float litros) {
  for (uint8_t i = 0; i < NUM_RUTAS; i++) {
    Ruta& r = P.rutas[i];
    if (r.veces == 0) continue;
    if (distanciaM(laI, loI, r.latI, r.lonI) < RADIO_RUTA_M && distanciaM(laF, loF, r.latF, r.lonF) < RADIO_RUTA_M) {
      r.minProm = (r.minProm * r.veces + minutos) / (r.veces + 1);
      r.litProm = (r.litProm * r.veces + litros) / (r.veces + 1);
      if (r.veces < 60000) r.veces++;
      return;
    }
  }
  int lugar = 0;  // vacío, o el menos usado
  for (uint8_t i = 0; i < NUM_RUTAS; i++) {
    if (P.rutas[i].veces == 0) { lugar = i; break; }
    if (P.rutas[i].veces < P.rutas[lugar].veces) lugar = i;
  }
  Ruta& r = P.rutas[lugar];
  r.latI = laI; r.lonI = loI; r.latF = laF; r.lonF = loF;
  r.veces = 1; r.minProm = minutos; r.litProm = litros;
}

void viajeTerminar() {
  if (!g_viaje.activo) return;
  g_viaje.activo = false;
  float litros = viajeLitros();
  float minMov = g_viaje.msMov / 60000.0f;
  float kmpl = (litros > 0.1f) ? g_viaje.km / litros : 0;

  if (g_modoDemo) return;
  if (g_viaje.km < 0.2f) return;   // movimientos de estacionamiento no cuentan

  revisarCambioDia();
  P.hoy.km += g_viaje.km;
  P.hoy.litros += litros;
  P.hoy.segMov += g_viaje.msMov / 1000;
  P.hoy.velMax = max(P.hoy.velMax, g_viaje.velMax);
  P.hoy.viajes++;
  semanaSumarViaje(g_viaje.km, litros, g_viaje.velMax);
  if (g_viaje.km > 5 && litros > 0.1f && kmpl > 5 && kmpl < 120)
    P.kmPorLitro = P.kmPorLitro * 0.8f + kmpl * 0.2f;

  ubicGuardar();                   // última ubicación conocida (Telegram /ubicacion)
  if (g_viaje.tieneInicioGps && datos.gpsFix)
    rutaRegistrar(g_viaje.latI, g_viaje.lonI, datos.lat, datos.lon,
                  (g_viaje.msMov + g_viaje.msParado) / 60000.0f, litros);

  char fi[24], ff[24], l[200];
  fechaTexto(fi, sizeof fi, DateTime(g_viaje.epochInicio));
  fechaTexto(ff, sizeof ff, ahora());
  snprintf(l, sizeof l, "%s,%s,%.2f,%.1f,%.1f,%.0f,%.2f,%.1f,%.6f,%.6f,%.6f,%.6f",
           fi, ff, g_viaje.km, minMov, g_viaje.msParado / 60000.0f, g_viaje.velMax, litros, kmpl,
           g_viaje.latI, g_viaje.lonI, datos.lat, datos.lon);
  sdAgregar("/viajes.csv", "inicio,fin,km,min_mov,min_parado,vmax,litros,km_l,lat_i,lon_i,lat_f,lon_f", l);

  for (uint8_t i = 0; i < NUM_MARCHAS; i++) P.shiftAprendido[i] = g_shiftActual[i] / PERFIL_FACTOR[P.perfil];
  nvsGuardar();
}

void viajeActualizar(uint32_t dt) {
  float v = isnan(datos.vel) ? 0 : datos.vel;
  float dkm = v * dt / 3600000.0f;
  if (v > 1) { P.odometro += dkm; g_nvsSucio = true; }

  bool ign = datos.ignicion;
  if (ign) g_ultIgnOn = millis();

  if (!g_viaje.activo && ign && v > 3) viajeIniciar();
  if (!g_viaje.activo) return;

  if (!g_pistaActiva) g_viaje.km += dkm;
  if (v > 3) g_viaje.msMov += dt; else g_viaje.msParado += dt;
  g_viaje.velMax = max(g_viaje.velMax, v);

  // Gasolina: detecta recargas para no contarlas como consumo negativo
  if (datos.gasPct >= 0) {
    if (g_viaje.gasRef < 0) { g_viaje.gasRef = datos.gasPct; g_viaje.gasMin = datos.gasPct; }
    if (datos.gasPct < g_viaje.gasMin) g_viaje.gasMin = datos.gasPct;
    if (datos.gasPct > g_viaje.gasMin + 15) {
      // Cargaste gasolina: avisa a la app cuánto y tu rendimiento aprendido
      char ev[64];
      snprintf(ev, sizeof ev, "{\"k\":\"g\",\"l\":%.1f,\"kl\":%.1f}", (datos.gasPct - g_viaje.gasMin) / 100.0f * TANQUE_LITROS, P.kmPorLitro);
      bleEvento(ev);
      g_viaje.litrosAcum += (g_viaje.gasRef - g_viaje.gasMin) / 100.0f * TANQUE_LITROS;
      g_viaje.gasRef = datos.gasPct;
      g_viaje.gasMin = datos.gasPct;
    }
  }

  if (!g_viaje.tieneInicioGps && datos.gpsFix && millis() - g_inicioViajeMs < 180000) {
    g_viaje.tieneInicioGps = true;
    g_viaje.latI = datos.lat;
    g_viaje.lonI = datos.lon;
  }

  if (!ign && millis() - g_ultIgnOn > FIN_VIAJE_MS) viajeTerminar();
}

float autonomiaKm() {
  if (datos.gasPct < 0) return NAN;
  return datos.gasPct / 100.0f * TANQUE_LITROS * P.kmPorLitro;
}

// ================================================================
// 17) MOTOR: arranques, ralentí, alternador
// ================================================================
void motorActualizar() {
  uint32_t ms = millis();
  int rpm = datos.rpm < 0 ? 0 : datos.rpm;

  // Caída de voltaje mientras se da marcha (antes de que prenda)
  if (!g_motorEnc && datos.ignicion && !isnan(datos.vMoto)) {
    if (ms - g_vMinArranqueT > 5000) g_vMinArranque = 99;
    if (datos.vMoto < g_vMinArranque) { g_vMinArranque = datos.vMoto; g_vMinArranqueT = ms; }
  }

  if (rpm > RPM_MOTOR_ENCENDIDO) {
    g_rpmBajoDesde = 0;
    if (g_rpmAltoDesde == 0) g_rpmAltoDesde = ms;
    if (!g_motorEnc && ms - g_rpmAltoDesde > 1000) {
      g_motorEnc = true;
      if (!g_modoDemo) { P.arranques++; g_nvsSucio = true; }
      float dip = (g_vMinArranque < 90) ? g_vMinArranque : NAN;
      registrarEvento(EVT_ARRANQUE, isnan(dip) ? 0 : dip);
      g_arranqueDebil = !isnan(dip) && dip < ARRANQUE_DEBIL_V;
      avanzadoArranque(dip);
      g_vMinArranque = 99;
    }
  } else {
    g_rpmAltoDesde = 0;
    if (g_rpmBajoDesde == 0) g_rpmBajoDesde = ms;
    if (g_motorEnc && ms - g_rpmBajoDesde > 2000) { g_motorEnc = false; g_ralentiDesde = 0; }
  }

  if (rpm > RPM_ROJO) registrarEvento(EVT_SOBRE_RPM, rpm);

  // Ralentí: motor caliente (o 3 min encendido), parada y en neutral
  float v = isnan(datos.vel) ? 0 : datos.vel;
  bool caliente = !isnan(datos.tempC) ? datos.tempC > 60 : (g_rpmAltoDesde && ms - g_rpmAltoDesde > 180000);
  if (g_motorEnc && v < 1 && datos.marcha == 0 && caliente) {
    if (g_ralentiDesde == 0) { g_ralentiDesde = ms; g_ralenti = rpm; }
    g_ralenti = g_ralenti * 0.98f + rpm * 0.02f;
    if (ms - g_ralentiDesde > 10000) g_ralentiMedido = true;
  } else g_ralentiDesde = 0;

  // Alternador: con el motor arriba de 2500 rpm debe cargar
  if (g_motorEnc && rpm > 2500 && !isnan(datos.vMoto)) {
    uint8_t estado = (datos.vMoto < CARGA_MIN_V) ? 2 : (datos.vMoto > CARGA_MAX_V) ? 3 : 1;
    if (estado == 1) { g_cargaMalaDesde = 0; g_estadoCarga = 1; }
    else {
      if (g_cargaMalaDesde == 0) g_cargaMalaDesde = ms;
      if (ms - g_cargaMalaDesde > 20000) {
        if (g_estadoCarga != estado) registrarEvento(EVT_NO_CARGA, datos.vMoto);
        g_estadoCarga = estado;
      }
    }
  } else if (!g_motorEnc) g_estadoCarga = 0;
}

bool ralentiFuera() {
  return g_ralentiMedido && (g_ralenti < RALENTI_MIN || g_ralenti > RALENTI_MAX);
}

// ================================================================
// 18) BATERÍAS: salud y predicción
// ================================================================
void registrarReposoDiario(float v) {
  uint32_t d = ymd(ahora());
  if (!g_rtcOk || isnan(v) || P.diaReposo == d) return;
  P.vReposo[P.idxReposo] = v;
  P.idxReposo = (P.idxReposo + 1) % 7;
  P.diaReposo = d;
  g_nvsSucio = true;
}

uint8_t reposoCuantos() {
  uint8_t n = 0;
  for (uint8_t i = 0; i < 7; i++) if (P.vReposo[i] > 5) n++;
  return n;
}

// Pendiente en V/día con regresión lineal sobre los últimos 7 días
float reposoTendencia() {
  if (reposoCuantos() < 3) return 0;
  float sx = 0, sy = 0, sxx = 0, sxy = 0; uint8_t n = 0;
  for (uint8_t k = 0; k < 7; k++) {
    uint8_t i = (P.idxReposo + k) % 7;   // del más viejo al más nuevo
    if (P.vReposo[i] < 5) continue;
    float x = k, y = P.vReposo[i];
    sx += x; sy += y; sxx += x * x; sxy += x * y; n++;
  }
  float den = n * sxx - sx * sx;
  return fabs(den) < 1e-6 ? 0 : (n * sxy - sx * sy) / den;
}

float reposoUltimo() {
  uint8_t i = (P.idxReposo + 6) % 7;
  return P.vReposo[i];
}

// Días estimados hasta que la batería quede débil (<12.2V en reposo)
int diasHastaBateriaDebil() {
  float m = reposoTendencia();
  float u = reposoUltimo();
  if (m > -0.005f || u < 5) return -1;
  float d = (u - BAT_REPOSO_DEBIL) / -m;
  return d < 0 ? 0 : (int)d;
}

const char* estadoBateriaMoto() {
  float v = datos.vMoto;
  if (isnan(v)) return "SIN DATO";
  if (g_motorEnc) {
    if (g_estadoCarga == 2) return "NO CARGA";
    if (g_estadoCarga == 3) return "SOBRECARGA";
    return "CARGANDO";
  }
  if (v >= BAT_REPOSO_BUENA) return "BUENA";
  if (v >= BAT_REPOSO_DEBIL) return "MEDIA";
  return "DEBIL";
}

// Al despertar: ¿cuánto bajó el voltaje por hora mientras estuvo dormida?
void revisarAutodescarga() {
  if (P.epochDormir == 0 || !g_rtcOk) return;
  uint32_t a = ahoraEpoch();
  if (a <= P.epochDormir) return;
  float horas = (a - P.epochDormir) / 3600.0f;
  if (horas < 6) return;
  float vm = voltajeMoto(), vl = voltajeLipo();
  if (!isnan(vm) && P.vMotoDormir > 5) {
    float tasa = max((P.vMotoDormir - vm) / horas, 0.0f);
    if (P.descMotoBase <= 0) P.descMotoBase = max(tasa, 0.002f);
    else {
      g_alertaDescMoto = tasa > 2.5f * P.descMotoBase && tasa > 0.01f;
      P.descMotoBase = P.descMotoBase * 0.9f + tasa * 0.1f;
    }
  }
  if (!isnan(vl) && P.vLipoDormir > 2) {
    float tasa = max((P.vLipoDormir - vl) / horas, 0.0f);
    if (P.descLipoBase <= 0) P.descLipoBase = max(tasa, 0.001f);
    else {
      g_alertaDescLipo = tasa > 2.5f * P.descLipoBase && tasa > 0.005f;
      P.descLipoBase = P.descLipoBase * 0.9f + tasa * 0.1f;
    }
  }
  P.epochDormir = 0;
  g_nvsSucio = true;
}

// ================================================================
// 19) SHIFT LIGHT CON APRENDIZAJE Y PID
// ================================================================
// Por cada marcha aprende en qué rpm la moto acelera más. El punto de
// cambio óptimo es donde la aceleración cae al 85 % del pico. Un PID
// lleva suavemente el punto de cambio actual hacia ese objetivo, para
// que no brinque de golpe con cada lectura.
void shiftInit() {
  for (uint8_t m = 0; m < NUM_MARCHAS; m++) {
    g_shiftActual[m] = constrain(P.shiftAprendido[m] * PERFIL_FACTOR[P.perfil], SHIFT_MIN, SHIFT_MAX);
    g_pidInt[m] = 0;
    g_pidErrPrev[m] = 0;
    for (uint8_t b = 0; b < BINS_RPM; b++) { g_accBin[m][b] = 0; g_accCnt[m][b] = 0; }
  }
}

float shiftObjetivo(uint8_t m) {
  int pico = -1;
  for (uint8_t b = 0; b < BINS_RPM; b++)
    if (g_accCnt[m][b] >= 3 && (pico < 0 || g_accBin[m][b] > g_accBin[m][pico])) pico = b;
  if (pico < 0) return P.shiftAprendido[m];
  float limite = g_accBin[m][pico] * 0.85f;
  for (uint8_t b = pico + 1; b < BINS_RPM; b++)
    if (g_accCnt[m][b] >= 3 && g_accBin[m][b] < limite) return b * 500.0f;
  int ultimo = pico;
  for (uint8_t b = pico; b < BINS_RPM; b++) if (g_accCnt[m][b] >= 3) ultimo = b;
  return (ultimo + 1) * 500.0f;
}

void shiftAprender(float dtS) {
  float v = isnan(datos.vel) ? 0 : datos.vel;
  float a = (v - g_velPrev) / dtS;
  g_velPrev = v;
  g_accelKmhs = g_accelKmhs * 0.7f + a * 0.3f;

  int m = datos.marcha;
  if (m >= 1 && m <= NUM_MARCHAS && datos.rpm > 2500 && g_accelKmhs > 0.8f) {
    uint8_t b = constrain(datos.rpm / 500, 0, BINS_RPM - 1);
    uint8_t i = m - 1;
    g_accBin[i][b] = (g_accCnt[i][b] == 0) ? g_accelKmhs : g_accBin[i][b] * 0.8f + g_accelKmhs * 0.2f;
    if (g_accCnt[i][b] < 250) g_accCnt[i][b]++;
  }

  for (uint8_t i = 0; i < NUM_MARCHAS; i++) {
    float obj = constrain(shiftObjetivo(i) * PERFIL_FACTOR[P.perfil], SHIFT_MIN, SHIFT_MAX);
    float err = obj - g_shiftActual[i];
    g_pidInt[i] = constrain(g_pidInt[i] + err * dtS, -5000.0f, 5000.0f);
    float der = (err - g_pidErrPrev[i]) / dtS;
    g_pidErrPrev[i] = err;
    float salida = PID_KP * err + PID_KI * g_pidInt[i] + PID_KD * der;
    g_shiftActual[i] = constrain(g_shiftActual[i] + salida * dtS, SHIFT_MIN, SHIFT_MAX);
  }
}

float puntoCambioActual() {
  int m = datos.marcha;
  if (m >= 1 && m <= NUM_MARCHAS) return g_shiftActual[m - 1];
  return SHIFT_DEF * PERFIL_FACTOR[P.perfil];
}

void ledsActualizar() {
  uint32_t ms = millis();
  if (ms - g_ultLeds < 30) return;
  g_ultLeds = ms;
  int rpm = datos.rpm;
  // Apagada (motor apagado o sin llave): se manda a la tira una sola vez, no 33 veces por segundo
  static bool apagada = false;
  // Direccional olvidada: toda la tira parpadea en ámbar (se ve aunque no veas el LCD ni el teléfono)
  bool avisoDir = datos.dirOlvidada && (datos.ignicion || g_modoDemo);
  bool encender = (rpm > 0 && (datos.ignicion || g_modoDemo)) || avisoDir;
  if (!encender && apagada) return;
  apagada = !encender;
  leds.clear();
  if (avisoDir) {
    leds.setBrightness(120);
    if ((ms / 250) % 2) for (uint8_t i = 0; i < NUM_LEDS; i++) leds.setPixelColor(i, leds.Color(255, 140, 0));
    leds.show();
    return;
  }
  if (encender) {
    uint8_t brillo = 80;
    if (P.autoBrillo && datos.luz >= 0) brillo = map(datos.luz, 0, 100, 10, 120);
    leds.setBrightness(brillo);
    float sp = puntoCambioActual();
    float inicio = sp * 0.6f;
    if (rpm >= sp) {
      if ((ms / 62) % 2) for (uint8_t i = 0; i < NUM_LEDS; i++) leds.setPixelColor(i, leds.Color(255, 0, 0));
    } else if (rpm > inicio) {
      int n = (int)((rpm - inicio) / (sp - inicio) * NUM_LEDS + 0.5f);
      for (int i = 0; i < n && i < NUM_LEDS; i++) {
        uint32_t c;
        if (i < NUM_LEDS * 0.5f)        c = leds.Color(0, 255, 0);       // verde
        else if (i < NUM_LEDS * 0.875f) c = leds.Color(255, 255, 255);   // blanco
        else                            c = leds.Color(255, 0, 0);       // rojo
        leds.setPixelColor(i, c);
      }
    }
  }
  leds.show();
}

// ================================================================
// 20) MODO PISTA
// ================================================================
void pistaActualizar() {
  if (!g_pistaActiva) return;
  float v = isnan(datos.vel) ? 0 : datos.vel;
  g_pistaVmax = max(g_pistaVmax, v);
  g_pistaRpmMax = max(g_pistaRpmMax, datos.rpm);
  g_pistaGmax = max(g_pistaGmax, fabs(datos.aFwd));
  if (!g_pistaCorriendo && v < 1) g_pistaT0 = 0;
  if (!g_pistaCorriendo && g_pistaT0 == 0 && v < 1) g_pistaT0 = 1;  // armado
  if (!g_pistaCorriendo && g_pistaT0 == 1 && v >= 1) { g_pistaCorriendo = true; g_pistaT0 = millis(); }
  if (g_pistaCorriendo && v >= PISTA_OBJETIVO_KMH) {
    g_pistaCorriendo = false;
    g_pistaUltimo = (millis() - g_pistaT0) / 1000.0f;
    g_pistaT0 = 2;   // terminado, espera a volver a 0
    if (!g_modoDemo && (P.pistaMejor <= 0 || g_pistaUltimo < P.pistaMejor)) { P.pistaMejor = g_pistaUltimo; nvsGuardar(); }
    char f[24], l[96];
    fechaTexto(f, sizeof f, ahora());
    snprintf(l, sizeof l, "%s,%.2f,%.0f,%d,%.2f", f, g_pistaUltimo, g_pistaVmax, g_pistaRpmMax, g_pistaGmax);
    sdAgregar("/pista.csv", "fecha,t_0_60,vmax,rpm_max,g_max", l);
  }
  if (g_pistaCorriendo && millis() - g_pistaT0 > 30000) { g_pistaCorriendo = false; g_pistaT0 = 2; }  // abortado
}

void pistaReset() {
  g_pistaUltimo = 0; g_pistaVmax = 0; g_pistaGmax = 0; g_pistaRpmMax = 0;
  g_pistaCorriendo = false; g_pistaT0 = 0;
}

// ================================================================
// 21) CORTE DE MOTOR (relevador)
// ================================================================
extern bool g_llaveCerrada;
bool g_paroLlavero = false;   // botón de paro del llavero TamaXOF: solo en RAM, se quita con "Permitir" o al quitar la llave
void releAplicar() {
  bool cortar = P.corteActivo || g_corteCaida || g_llaveCerrada || g_paroLlavero;   // llave de proximidad: hasta que llegue tu teléfono o tu llavero
  digitalWrite(PIN_RELE, (cortar == RELE_ACTIVO_ALTO) ? HIGH : LOW);
}

bool corteCambiar(bool activar, Print& out) {
  float v = isnan(datos.vel) ? 0 : datos.vel;
  if (activar && v > VEL_MAX_CORTE) { out.println(F("No se puede cortar en movimiento.")); return false; }
  P.corteActivo = activar;
  if (!activar) g_corteCaida = false;
  releAplicar();
  nvsGuardar();
  registrarEvento(EVT_CORTE, activar ? 1 : 0);
  out.println(activar ? F("Motor BLOQUEADO.") : F("Motor desbloqueado."));
  return true;
}

// ================================================================
// 21b) FUNCIONES AVANZADAS (todas apagadas de fábrica)
// ================================================================
// Limitador de RPM, launch control y quickshifter cortan la chispa unos milisegundos
// poniendo a tierra el cable de paro del CDI con un MOSFET (ver HARDWARE-CORTE-CHISPA.md).
// El relevador de PIN_RELE NO sirve para esto: es mecánico, tarda 5-15 ms y se gasta.
// Reglas de seguridad (no se pueden quitar desde la app):
//   - Sin USAR_CORTE_CHISPA 1 y un pin válido no se toca nada.
//   - Nada corta en modo demo, con la llave apagada o con el motor apagado.
//   - Ningún corte dura más de CORTE_MAX_MS; después la chispa vuelve al menos CORTE_PAUSA_MIN_MS.
//   - Si la tarjeta se reinicia o se cuelga, el pin queda sin señal y el MOSFET suelta (la moto
//     sigue con chispa normal): el corte falla "abierto".
//   - Prender cualquiera pide enlace cifrado, la moto parada y la palabra "confirmar".
// El diagnóstico de motor y batería solo mide (no corta nada) y también arranca apagado.
const uint16_t LIM_RPM_MIN = 6000, LIM_RPM_MAX = 11000, LIM_RPM_DEF = 9500;
const uint16_t LC_RPM_MIN  = 3000, LC_RPM_MAX  = 8000,  LC_RPM_DEF  = 6000;
const uint8_t  QS_MS_MIN   = 30,   QS_MS_MAX   = 100,   QS_MS_DEF   = 60;
const uint16_t QS_RPM_MIN  = 3000, QS_RPM_MAX  = 9000,  QS_RPM_DEF  = 4500;
const uint16_t CORTE_MAX_MS       = 120;   // tope de un corte seguido
const uint16_t CORTE_PAUSA_MIN_MS = 40;    // chispa obligada entre cortes
const uint16_t LIM_CORTE_MS       = 20;    // golpe del limitador (unas 3 vueltas a 9500)
const uint16_t QS_BLOQUEO_MS      = 400;   // tiempo mínimo entre dos cambios
const float    QS_VEL_MIN         = 15.0f; // el quickshifter solo rodando
const float    LC_VEL_FIN         = 15.0f; // el launch se suelta al pasar esta velocidad
const uint8_t  NUM_ARRANQUES_DIAG = 5;

struct Avanzado {
  uint32_t magic;
  bool lim; uint16_t limRpm;
  bool lc;  uint16_t lcRpm;
  bool qs;  uint8_t qsMs; uint16_t qsRpm;
  bool diag;
  float arranques[NUM_ARRANQUES_DIAG];   // voltaje mínimo de los últimos arranques
  uint8_t idxArr;
};
const uint32_t MAGIC_AVANZADO = 0xF150AD01;
Avanzado A;
uint32_t g_cortesLim = 0, g_cortesQs = 0;
bool g_lcListo = false;            // launch armado: parado, fuera de neutral

#if USAR_CORTE_CHISPA
const bool HAY_CORTE_CHISPA = PIN_CORTE_CHISPA >= 0;
#else
const bool HAY_CORTE_CHISPA = false;
#endif

void avanzadoDefaults() {
  memset(&A, 0, sizeof(A));
  A.magic = MAGIC_AVANZADO;
  A.limRpm = LIM_RPM_DEF; A.lcRpm = LC_RPM_DEF; A.qsMs = QS_MS_DEF; A.qsRpm = QS_RPM_DEF;
  for (uint8_t i = 0; i < NUM_ARRANQUES_DIAG; i++) A.arranques[i] = NAN;
}

void avanzadoGuardar() {
  Preferences s;
  s.begin("avanzado", false);
  s.putBytes("a", &A, sizeof(A));
  s.end();
}

void avanzadoCargar() {
  Preferences s;
  s.begin("avanzado", true);
  bool ok = s.getBytesLength("a") == sizeof(A) && s.getBytes("a", &A, sizeof(A)) == sizeof(A) && A.magic == MAGIC_AVANZADO;
  s.end();
  if (!ok) avanzadoDefaults();
  A.limRpm = constrain(A.limRpm, LIM_RPM_MIN, LIM_RPM_MAX);
  A.lcRpm = constrain(A.lcRpm, LC_RPM_MIN, LC_RPM_MAX);
  A.qsMs = constrain(A.qsMs, QS_MS_MIN, QS_MS_MAX);
  A.qsRpm = constrain(A.qsRpm, QS_RPM_MIN, QS_RPM_MAX);
  if (!HAY_CORTE_CHISPA) { A.lim = false; A.lc = false; A.qs = false; }
}

// Lo llama motorActualizar al detectar un arranque (con diagnóstico prendido)
void avanzadoArranque(float dip) {
  if (!A.diag || isnan(dip)) return;
  A.arranques[A.idxArr % NUM_ARRANQUES_DIAG] = dip;
  A.idxArr = (A.idxArr + 1) % NUM_ARRANQUES_DIAG;
  avanzadoGuardar();
}

#if USAR_CORTE_CHISPA
void chispaPin(bool cortar) {
  g_cortandoChispa = cortar;
  digitalWrite(PIN_CORTE_CHISPA, (cortar == CHISPA_ACTIVO_ALTO) ? HIGH : LOW);
}

bool qsPisado() {
  if (PIN_QS_SENSOR < 0) return false;
  return (digitalRead(PIN_QS_SENSOR) == LOW) == QS_ACTIVO_BAJO;
}

// Tarea propia (cada 1 ms) para que el corte no dependa de lo que tarde loop() con el LCD.
void tareaChispa(void*) {
  uint32_t cortaDesde = 0, cortaHasta = 0, libreDesde = 0;
  uint32_t pulsosAlSoltar = 0, ultQs = 0;
  uint8_t qsCuenta = 0;
  bool qsSuelto = true;
  for (;;) {
    uint32_t ms = millis();
    bool cortando = cortaHasta != 0;
    float v = isnan(datos.vel) ? 0 : datos.vel;
    bool permitido = !g_modoDemo && datos.ignicion && g_motorEnc && (A.lim || A.lc || A.qs);

    if (cortando) {
      // Fin del golpe, tope de seguridad o algo dejó de permitirlo
      if (!permitido || (int32_t)(ms - cortaHasta) >= 0 || ms - cortaDesde >= CORTE_MAX_MS) {
        chispaPin(false);
        cortaHasta = 0;
        libreDesde = ms;
        pulsosAlSoltar = g_pulsos;
      }
    } else if (permitido && ms - libreDesde >= CORTE_PAUSA_MIN_MS) {
      uint16_t duracion = 0;

      // Quickshifter: flanco del sensor (2 lecturas seguidas), rodando, en 1a a 4a
      bool pisado = qsPisado();
      qsCuenta = pisado ? min(qsCuenta + 1, 3) : 0;
      if (!pisado) qsSuelto = true;
      if (A.qs && qsSuelto && qsCuenta >= 2 && v > QS_VEL_MIN && datos.marcha >= 1 &&
          datos.marcha < NUM_MARCHAS && datos.rpm >= A.qsRpm && ms - ultQs > QS_BLOQUEO_MS) {
        duracion = A.qsMs;
        qsSuelto = false;
        ultQs = ms;
        g_cortesQs++;
      }

      // Limitador / launch: solo con RPM recién medidas (2 chispas después del último corte,
      // porque mientras se corta no hay pulsos y la lectura se queda vieja)
      if (!duracion && g_pulsos - pulsosAlSoltar >= 2) {
        uint16_t tope = 0;
        if (A.lim) tope = A.limRpm;
        if (A.lc && g_lcListo) tope = tope ? min(tope, A.lcRpm) : A.lcRpm;
        int rpm = rpmInstantanea();
        if (tope && rpm > tope) { duracion = LIM_CORTE_MS; g_cortesLim++; }
      }

      if (duracion) {
        chispaPin(true);
        cortaDesde = ms;
        cortaHasta = ms + duracion;
      }
    }
    vTaskDelay(1);
  }
}
#endif

void avanzadoBegin() {
  avanzadoCargar();
#if USAR_CORTE_CHISPA
  if (PIN_CORTE_CHISPA >= 0) {
    pinMode(PIN_CORTE_CHISPA, OUTPUT);
    chispaPin(false);
    if (PIN_QS_SENSOR >= 0) pinMode(PIN_QS_SENSOR, INPUT_PULLUP);
    // Núcleo 1 (el de loop), prioridad arriba de loop
    xTaskCreatePinnedToCore(tareaChispa, "chispa", 3072, nullptr, 3, nullptr, 1);
  }
#endif
}

// Cada tick (100 ms): arma o suelta el launch control
void avanzadoTick() {
  float v = isnan(datos.vel) ? 0 : datos.vel;
  if (!A.lc) g_lcListo = false;
  else if (v < VEL_MAX_CORTE && !datos.neutral && g_motorEnc) g_lcListo = true;
  else if (v > LC_VEL_FIN || !g_motorEnc) g_lcListo = false;
}

void avanzadoJson(Print& out) {
  out.printf("{\"av\":1,\"hw\":%d,\"qsh\":%d,\"lim\":%d,\"lr\":%u,\"lc\":%d,\"lcr\":%u,\"qs\":%d,\"qm\":%u,\"qr\":%u,\"dg\":%d}\n",
             HAY_CORTE_CHISPA ? 1 : 0, (HAY_CORTE_CHISPA && PIN_QS_SENSOR >= 0) ? 1 : 0,
             A.lim, A.limRpm, A.lc, A.lcRpm, A.qs, A.qsMs, A.qsRpm, A.diag);
}

//  av                              estado en JSON (la app lo lee)
//  av lim on 9500 confirmar | off  limitador de RPM
//  av lc on 6000 confirmar | off   launch control
//  av qs on 60 4500 confirmar | off  quickshifter (ms de corte, rpm mínimas)
//  av diag on|off                  diagnóstico de motor y batería
void avanzadoComando(const String& low, Print& out) {
  String c1 = palabra(low, 1), c2 = palabra(low, 2);
  if (c1 == "") { avanzadoJson(out); return; }
  if (c1 == "diag") {
    A.diag = (c2 == "on");
    if (A.diag) { noInterrupts(); g_chispaFaltas = 0; g_irrSuma = 0; g_irrN = 0; interrupts(); }
    avanzadoGuardar();
    avanzadoJson(out);
    return;
  }
  bool esCorte = c1 == "lim" || c1 == "lc" || c1 == "qs";
  if (!esCorte) { out.println(F("Usa: av | av lim|lc|qs on ... confirmar | off | av diag on|off")); return; }
  if (c2 == "off") {
    if (c1 == "lim") A.lim = false; else if (c1 == "lc") A.lc = false; else A.qs = false;
    avanzadoGuardar();
    avanzadoJson(out);
    return;
  }
  if (c2 != "on" || low.indexOf("confirmar") < 0) { out.println(F("Falta 'confirmar'.")); return; }
  if (!HAY_CORTE_CHISPA) { out.println(F("Sin hardware: arma el corte de chispa y compila con USAR_CORTE_CHISPA 1.")); return; }
  float v = isnan(datos.vel) ? 0 : datos.vel;
  if (v > VEL_MAX_CORTE) { out.println(F("Solo con la moto parada.")); return; }
  int n1 = palabra(low, 3).toInt(), n2 = palabra(low, 4).toInt();
  if (c1 == "lim") { if (n1 > 0) A.limRpm = constrain(n1, LIM_RPM_MIN, LIM_RPM_MAX); A.lim = true; }
  else if (c1 == "lc") { if (n1 > 0) A.lcRpm = constrain(n1, LC_RPM_MIN, LC_RPM_MAX); A.lc = true; }
  else {
    if (PIN_QS_SENSOR < 0) { out.println(F("Sin sensor de quickshifter (PIN_QS_SENSOR).")); return; }
    if (n1 > 0) A.qsMs = constrain(n1, QS_MS_MIN, QS_MS_MAX);
    if (n2 > 0) A.qsRpm = constrain(n2, QS_RPM_MIN, QS_RPM_MAX);
    A.qs = true;
  }
  avanzadoGuardar();
  avanzadoJson(out);
}

// Mensaje "d" para la app (cada 3 s con el diagnóstico prendido)
int jsonDiagnostico(char* b, size_t n) {
  noInterrupts();
  uint32_t faltas = g_chispaFaltas, suma = g_irrSuma, cuenta = g_irrN, pulsos = g_pulsos;
  interrupts();
  char arr[48] = "";
  size_t k = 0;
  for (uint8_t i = 0; i < NUM_ARRANQUES_DIAG; i++) {
    float x = A.arranques[(A.idxArr + i) % NUM_ARRANQUES_DIAG];   // del más viejo al más nuevo
    if (isnan(x)) continue;
    k += snprintf(arr + k, sizeof(arr) - k, "%s%.2f", k ? "," : "", x);
  }
  return snprintf(b, n,
    "{\"k\":\"d\",\"cf\":%lu,\"pu\":%lu,\"ir\":%lu,\"ar\":[%s],\"ad\":%d,\"ca\":%d,\"ra\":%d,\"cl\":%lu,\"cq\":%lu,\"lc\":%d}",
    (unsigned long)faltas, (unsigned long)pulsos, (unsigned long)(cuenta ? suma / cuenta : 0), arr,
    g_arranqueDebil ? 1 : 0, g_estadoCarga, g_ralentiMedido ? (int)g_ralenti : 0,
    (unsigned long)g_cortesLim, (unsigned long)g_cortesQs, g_lcListo ? 1 : 0);
}

// ================================================================
// 21c) PLACA B: ENTRADAS AISLADAS, RELEVADORES 2 Y 3, SALIDA AISLADA Y CARGA DE LA CELDA
// ================================================================
void placaBegin() {
  pinMode(PIN_ENT2, INPUT_PULLUP);       // el PC817 jala a tierra cuando el cable tiene voltaje
  pinMode(PIN_ENT3, INPUT_PULLUP);
  pinMode(PIN_RELE2, OUTPUT);  digitalWrite(PIN_RELE2, LOW);
  pinMode(PIN_RELE3, OUTPUT);  digitalWrite(PIN_RELE3, LOW);
  pinMode(PIN_SALIDA, OUTPUT); digitalWrite(PIN_SALIDA, LOW);
  pinMode(PIN_CARGA, OUTPUT);  digitalWrite(PIN_CARGA, LOW);
  if (PIN_MPU_INT >= 0) pinMode(PIN_MPU_INT, INPUT);   // la 10k de J11 lo deja en bajo
}

// Cada tick (100 ms): freno, direccionales y "dejaste la direccional"
void entradasActualizar(uint32_t dt) {
  uint32_t ms = millis();
  const uint8_t pines[2] = {PIN_ENT2, PIN_ENT3};
  const FuncionEntrada funciones[2] = {FUNCION_ENT2, FUNCION_ENT3};
  bool freno = false;
  for (uint8_t i = 0; i < 2; i++) {
    bool voltaje = digitalRead(pines[i]) == LOW;
    if (funciones[i] == ENT_FRENO && voltaje) freno = true;
    if (funciones[i] == ENT_DIRECCIONAL && voltaje) g_dirUltPulso = ms;
  }
  placaEEntradas(freno, ms);             // entradas de la placa E con función de freno o direccional
  if (g_modoDemo) return;                // el demo pone sus propios valores
  datos.freno = freno;
  if (freno) g_frenoUltimo = ms;
  if (freno && !g_frenoAntes) g_frenadas++;
  g_frenoAntes = freno;
  // La direccional parpadea (~1.5 por segundo): cuenta como prendida si hubo destello en el último 1.2 s
  datos.direccional = g_dirUltPulso != 0 && ms - g_dirUltPulso < 1200;
  float v = isnan(datos.vel) ? 0 : datos.vel;
  if (!datos.direccional) g_dirRodandoMs = 0;
  else if (v > DIR_VEL_MIN) g_dirRodandoMs += dt;   // esperando en un alto no cuenta
  datos.dirOlvidada = g_dirRodandoMs > DIR_OLVIDADA_MS;
}

/** ¿Hay sensor de freno? (para no contar baches como frenadas fuertes) */
bool hayFreno() { return FUNCION_ENT2 == ENT_FRENO || FUNCION_ENT3 == ENT_FRENO; }

bool alarmaSirenaAhora();
uint8_t alarmaSirenaEn();

// Relevadores 2 y 3 y la salida aislada: tuyos (luces, claxon...), desde la app. La alarma puede usar uno de sirena.
void salidasAplicar() {
  uint32_t ms = millis();
  if (g_rele2Hasta && (int32_t)(ms - g_rele2Hasta) >= 0) { g_rele2 = false; g_rele2Hasta = 0; }
  if (g_rele3Hasta && (int32_t)(ms - g_rele3Hasta) >= 0) { g_rele3 = false; g_rele3Hasta = 0; }
  if (g_salidaHasta && (int32_t)(ms - g_salidaHasta) >= 0) { g_salida = false; g_salidaHasta = 0; }
  bool sirena = alarmaSirenaAhora();
  uint8_t s = alarmaSirenaEn();
  digitalWrite(PIN_RELE2, (g_rele2 || (sirena && s == 2)) ? HIGH : LOW);
  digitalWrite(PIN_RELE3, (g_rele3 || (sirena && s == 3)) ? HIGH : LOW);
  digitalWrite(PIN_SALIDA, (g_salida || (sirena && s == 4)) ? HIGH : LOW);
}

void releJson(Print& out) { out.printf("{\"rl\":[%d,%d,%d]}\n", g_rele2, g_rele3, g_salida); }

//  rele                          estado {"rl":[relevador2, relevador3, salida]}
//  rele 2|3|s on [segundos] | off  (con segundos se apaga solo; el relevador 1 es el bloqueo: "corte")
void releComando(const String& low, Print& out) {
  String c1 = palabra(low, 1), c2 = palabra(low, 2);
  if (c1 == "") { releJson(out); return; }
  bool* est; uint32_t* hasta;
  if (c1 == "2") { est = &g_rele2; hasta = &g_rele2Hasta; }
  else if (c1 == "3") { est = &g_rele3; hasta = &g_rele3Hasta; }
  else if (c1 == "s" || c1 == "salida") { est = &g_salida; hasta = &g_salidaHasta; }
  else { out.println(F("Usa: rele 2|3|s on [segundos] | off")); return; }
  if (c2 == "on") {
    uint32_t s = (uint32_t)palabra(low, 3).toInt();
    *est = true;
    *hasta = s ? millis() + min(s, (uint32_t)86400) * 1000UL : 0;
  } else if (c2 == "off") { *est = false; *hasta = 0; }
  else { out.println(F("Usa: rele 2|3|s on [segundos] | off")); return; }
  salidasAplicar();
  releJson(out);
}

// Carga de la celda (BD140 -> TP4056). Con el motor prendido el alternador sobra; sin motor solo si la batería de la
// moto está bien y la celda baja. El TP4056 se corta solo al llenarla. Dormida, la 10k de la base la deja apagada.
void cargaActualizar() {
  float vl = datos.vLipo, vm = datos.vMoto;
  if (g_modoDemo || isnan(vl) || isnan(vm)) g_cargando = false;
  else if (!g_cargando) g_cargando = (g_motorEnc && vl < 4.10f) || (vm > 12.5f && vl < 3.80f);
  else if (!(g_motorEnc || vm > 12.3f)) g_cargando = false;   // cargando, la celda marca el voltaje del cargador
  digitalWrite(PIN_CARGA, g_cargando ? HIGH : LOW);
}

// ================================================================
// 21d) ALARMA DE MOVIMIENTO (MPU6050 + su pin INT en J11)
// ================================================================
// Estacionada (sin llave 2 min) el MPU vigila solo: si alguien mueve la moto, su pin INT despierta a la tarjeta
// (aunque esté dormida). Espera 20 s: si gira la llave eres tú. Si no: evento, mensaje por Telegram (si estás en el
// WiFi de casa) y, si quieres, sirena con un relevador o la salida. Máximo una alarma cada 5 min.
// Dormido, el MPU se queda en "modo ciclo" (mide 5 veces por segundo, ~70 µA).
struct Alarma { uint32_t magic; bool activa; uint8_t sens; uint8_t sirena; };   // sirena: 0 nada, 2/3 relevador, 4 salida
const uint32_t MAGIC_ALARMA = 0xF150A1A2;
Alarma g_alarma;
RTC_DATA_ATTR bool g_alarmaPausa = false;     // acaba de sonar dormida: el siguiente sueño no vigila
RTC_DATA_ATTR bool g_mpuVigilando = false;    // el MPU quedó configurado para vigilar (sobrevive al sueño)
bool g_alarmaArmada = false;
uint32_t g_alarmaUltima = 0, g_sirenaHasta = 0, g_movidaDesde = 0;
const uint8_t MOT_UMBRAL[5] = {40, 25, 15, 10, 6};   // ×2 mg · sensibilidad 1 (poca) a 5 (mucha)

void alarmaCargar() {
  Preferences s;
  s.begin("alarma", true);
  bool ok = s.getBytesLength("a") == sizeof(Alarma) && s.getBytes("a", &g_alarma, sizeof(Alarma)) == sizeof(Alarma) &&
            g_alarma.magic == MAGIC_ALARMA;
  s.end();
  if (!ok) { g_alarma.magic = MAGIC_ALARMA; g_alarma.activa = true; g_alarma.sens = 3; g_alarma.sirena = 0; }
  g_alarma.sens = constrain(g_alarma.sens, 1, 5);
  if (g_alarma.sirena != 2 && g_alarma.sirena != 3 && g_alarma.sirena != 4) g_alarma.sirena = 0;
}

void alarmaGuardar() {
  Preferences s;
  s.begin("alarma", false);
  s.putBytes("a", &g_alarma, sizeof g_alarma);
  s.end();
}

uint8_t alarmaSirenaEn() { return g_alarma.sirena; }

/** Sirena intermitente (medio segundo sí, medio no) mientras dura. */
bool alarmaSirenaAhora() {
  return g_alarma.sirena && g_sirenaHasta && (int32_t)(g_sirenaHasta - millis()) > 0 && (millis() / 500) % 2 == 0;
}

/** Sirve vigilar si hay a quién avisar: Telegram o una sirena. */
bool alarmaUtil() { return PIN_MPU_INT >= 0 && g_alarma.activa && (tgListo() || g_alarma.sirena != 0); }

/** Detección de movimiento del MPU (interrupción en su pin INT) prendida o apagada. */
void imuMovimiento(bool on) {
  imuEscribir(0x1F, MOT_UMBRAL[g_alarma.sens - 1]);   // umbral
  imuEscribir(0x20, 40);                              // 40 ms seguidos
  imuEscribir(0x1C, on ? 0x09 : 0x08);                // ±4 g; con alarma, pasa altas de 5 Hz para el detector
  imuEscribir(0x38, on ? 0x40 : 0x00);                // MOT_EN
  imuLeer(0x3A);                                      // limpia la interrupción pendiente
}

bool tgEnviar(const String& texto);
bool casaWifiConectar(uint32_t esperaMs);

void alarmaDisparar(bool dormida) {
  uint32_t ms = millis();
  if (!dormida && g_alarmaUltima && ms - g_alarmaUltima < 300000) return;   // una cada 5 min
  g_alarmaUltima = ms;
  registrarEvento(EVT_MOVIDA, 1);
  aviso("MOTO MOVIDA");
  bleEvento("{\"k\":\"m\"}");              // el teléfono (si está conectado) manda fotos y audio
  if (g_alarma.sirena) g_sirenaHasta = ms + 6000;
#if USAR_WIFI
  if (tgListo() && casaWifiConectar(dormida ? 10000 : 3000))
    tgEnviar(String("🚨 Movieron la moto") + (dormida ? " (estaba dormida)" : "") + ". Escribe /ubicacion o /bloquear.");
#endif
}

// Cada tick, despierta: se arma estacionada y se desarma al girar la llave
void alarmaTick() {
  if (!g_imuOk || !alarmaUtil() || g_modoDemo) {
    if (g_alarmaArmada) { imuMovimiento(false); g_alarmaArmada = false; }
    return;
  }
  uint32_t ms = millis();
  bool estacionada = !datos.ignicion && !g_motorEnc && ms - g_ultIgnOn > 120000;
  if (estacionada != g_alarmaArmada) { imuMovimiento(estacionada); g_alarmaArmada = estacionada; g_movidaDesde = 0; }
  if (!g_alarmaArmada) return;
  if (digitalRead(PIN_MPU_INT) == HIGH) {
    imuLeer(0x3A);
    if (g_movidaDesde == 0) g_movidaDesde = ms;       // 20 s para ver si eres tú (giras la llave)
  }
  if (g_movidaDesde && ms - g_movidaDesde > 20000) { g_movidaDesde = 0; alarmaDisparar(false); }
}

/** Antes de dormir: el MPU queda vigilando solo y su pin INT puede despertar a la tarjeta. */
bool alarmaAlDormir() {
  if (!alarmaUtil() || g_alarmaPausa) return false;
  if (g_imuOk) {                                       // despierta normal: se configura
    imuMovimiento(true);
    imuEscribir(0x6C, 0x47);                           // PWR_MGMT_2: 5 lecturas por segundo, giroscopio dormido
    imuEscribir(0x6B, 0x28);                           // PWR_MGMT_1: modo ciclo, sin termómetro
    imuLeer(0x3A);
    g_mpuVigilando = true;
  } else if (g_mpuVigilando) {
    imuLeer(0x3A);                                     // despertó por el reloj: el MPU sigue configurado
  }
  if (!g_mpuVigilando) return false;
  esp_sleep_enable_ext0_wakeup((gpio_num_t)PIN_MPU_INT, 1);
  return true;
}

// Despertó porque la movieron: ¿eres tú? (giras la llave en 20 s) Si no, alarma y a dormir otra vez
void despertarPorMovimiento() {
  uint32_t t0 = millis();
  while (millis() - t0 < 20000) {
    if (leerIgnicion()) { g_mpuVigilando = false; return; }   // eres tú: arranque normal (imuBegin lo reinicia)
    delay(100);
  }
  for (uint8_t i = 0; i < 20; i++) { adcActualizar(); delay(20); }
  datos.vMoto = voltajeMoto();
  datos.vLipo = voltajeLipo();
  alarmaDisparar(true);
  while (g_alarma.sirena && (int32_t)(g_sirenaHasta - millis()) > 0) { salidasAplicar(); delay(50); }
  g_sirenaHasta = 0;
  salidasAplicar();
  g_alarmaPausa = true;                                // el siguiente sueño (5 min) no vigila: no suena en bucle
  irADormir(true);
}

//  alarma | alarma on|off | alarma sens 1-5 | alarma sirena 0|2|3|s | alarma prueba
void alarmaJson(Print& out) {
  out.printf("{\"alm\":%d,\"as\":%u,\"ar\":%u,\"aa\":%d,\"ok\":%d}\n", g_alarma.activa ? 1 : 0, g_alarma.sens,
             g_alarma.sirena, g_alarmaArmada ? 1 : 0, (PIN_MPU_INT >= 0 && g_imuOk) ? 1 : 0);
}

void alarmaComando(const String& low, Print& out) {
  String c1 = palabra(low, 1), c2 = palabra(low, 2);
  if (c1 == "on" || c1 == "off") g_alarma.activa = c1 == "on";
  else if (c1 == "sens") g_alarma.sens = constrain((int)c2.toInt(), 1, 5);
  else if (c1 == "sirena") g_alarma.sirena = c2 == "2" ? 2 : c2 == "3" ? 3 : (c2 == "s" || c2 == "salida") ? 4 : 0;
  else if (c1 == "prueba") { g_alarmaUltima = 0; alarmaDisparar(false); }
  if (c1 != "" && c1 != "prueba") {
    alarmaGuardar();
    if (g_alarmaArmada) imuMovimiento(true);           // nueva sensibilidad
  }
  alarmaJson(out);
}

// ================================================================
// 21e) IA DE VIBRACIONES: aprende cómo vibra TU moto sana y avisa cuando algo cambia
// ================================================================
// Sin internet ni modelo de fábrica: la tarjeta aprende sola mientras ruedas. Cada 1.28 s toma 128 lecturas del
// acelerómetro (100 por segundo, por la FIFO del MPU) y saca 4 "huellas":
//   - vibración total (RMS)
//   - energía a la frecuencia de las explosiones del motor (rpm/120 Hz)
//   - energía a la vuelta de la rueda y al doble (cadena, rueda desbalanceada, balero, rin)
// Por cada rango de 500 rpm guarda el promedio y la variación normal de cada huella. Cuando un rango ya conoce bien
// tu moto (2 min ahí), mide qué tan lejos está cada lectura de lo normal (desviaciones). Más de 3.5 seguido ~10 s =
// "VIBRACION RARA": cadena floja o seca, rueda o balero, tornillo o soporte suelto, motor raro.
// Con "vibra captura on" guarda todo en vibra.csv: con esos datos se puede entrenar después una red neuronal más fina.
const uint8_t VB_N = 128, VB_BINS = 20, VB_F = 4;
const float VB_HZ = 100.0f;
struct ModeloVibra { uint32_t magic; uint16_t n[VB_BINS]; float media[VB_BINS][VB_F]; float var[VB_BINS][VB_F]; };
const uint32_t MAGIC_VIBRA = 0xF150B1B1;
ModeloVibra g_vb;
bool g_vbActiva = false, g_vbCaptura = false, g_vbSucio = false, g_vbFifo = false;
float g_vbBuf[3][VB_N];
uint8_t g_vbI = 0;
float g_vbMedia[3] = {0, 0, 1};
float g_vbScore = 0;
float g_vbRuedaZ = 0;
uint8_t g_vbSeguidas = 0, g_vbBien = 0;
uint32_t g_vbGuardado = 0, g_vbVentanas = 0;

void vibraCargar() {
  Preferences s;
  s.begin("vibra", true);
  g_vbActiva = s.getBool("on", false);
  g_vbCaptura = s.getBool("cap", false);
  bool ok = s.getBytesLength("m") == sizeof(ModeloVibra) && s.getBytes("m", &g_vb, sizeof g_vb) == sizeof g_vb &&
            g_vb.magic == MAGIC_VIBRA;
  s.end();
  if (!ok) { memset(&g_vb, 0, sizeof g_vb); g_vb.magic = MAGIC_VIBRA; }
}

void vibraGuardar(bool modelo) {
  Preferences s;
  s.begin("vibra", false);
  s.putBool("on", g_vbActiva);
  s.putBool("cap", g_vbCaptura);
  if (modelo) { s.putBytes("m", &g_vb, sizeof g_vb); g_vbSucio = false; g_vbGuardado = millis(); }
  s.end();
}

void vibraFifo(bool on) {
  if (!g_imuOk || on == g_vbFifo) return;
  imuEscribir(0x6A, 0x04);                      // reinicia la FIFO
  imuEscribir(0x23, on ? 0x08 : 0x00);          // solo el acelerómetro
  imuEscribir(0x6A, on ? 0x40 : 0x00);          // FIFO prendida / apagada
  g_vbFifo = on;
  g_vbI = 0;
}

/** Energía de la frecuencia f (Hz) en x[0..n) (algoritmo de Goertzel), normalizada. */
float goertzel(const float* x, uint8_t n, float f) {
  float w = 2.0f * PI * f / VB_HZ, c = 2.0f * cosf(w), s1 = 0, s2 = 0;
  for (uint8_t i = 0; i < n; i++) { float s0 = x[i] + c * s1 - s2; s2 = s1; s1 = s0; }
  return (s1 * s1 + s2 * s2 - c * s1 * s2) / ((float)n * n);
}

float vibraEnergia(float f) {
  if (f < 1.5f || f > 45.0f) return NAN;        // fuera de lo que se puede medir a 100 por segundo con el filtro de 44 Hz
  return goertzel(g_vbBuf[0], VB_N, f) + goertzel(g_vbBuf[1], VB_N, f) + goertzel(g_vbBuf[2], VB_N, f);
}

void vibraVentana() {
  int rpm = datos.rpm;
  float v = isnan(datos.vel) ? 0 : datos.vel;
  if (!g_motorEnc || rpm < 1500 || rpm >= VB_BINS * 500 || v < 5) return;   // solo rodando
  float suma = 0;
  for (uint8_t i = 0; i < VB_N; i++) suma += g_vbBuf[0][i] * g_vbBuf[0][i] + g_vbBuf[1][i] * g_vbBuf[1][i] + g_vbBuf[2][i] * g_vbBuf[2][i];
  float rueda = v / 3.6f / (CIRCUNF_RUEDA_MM / 1000.0f);   // vueltas de la rueda por segundo
  float f[VB_F] = { sqrtf(suma / VB_N), vibraEnergia(rpm / 120.0f), vibraEnergia(rueda), vibraEnergia(rueda * 2) };
  uint8_t b = rpm / 500;
  uint16_t& n = g_vb.n[b];
  float z = 0, zr = 0; uint8_t k = 0, kr = 0;
  for (uint8_t j = 0; j < VB_F; j++) {
    if (isnan(f[j])) continue;
    float y = log10f(f[j] + 1e-7f);
    f[j] = y;
    if (n >= 120) {
      float zj = fabsf(y - g_vb.media[b][j]) / sqrtf(g_vb.var[b][j] + 1e-4f);
      z += zj; k++;
      if (j >= 2) { zr += zj; kr++; }              // huellas de la rueda (cadena, rin, balero)
    }
  }
  if (kr) g_vbRuedaZ += 0.05f * (zr / kr - g_vbRuedaZ);   // promedio lento: lo usa el estado de la cadena
  g_vbScore = k ? z / k : 0;
  g_vbVentanas++;
  // Aprende (lento: hasta 600 ventanas por rango ≈ 13 min, así se adapta a la moto con el tiempo), pero no de lo raro
  if (g_vbScore < 3.0f) {
    if (n < 600) n++;
    for (uint8_t j = 0; j < VB_F; j++) {
      if (isnan(f[j])) continue;
      float d = f[j] - g_vb.media[b][j];
      g_vb.media[b][j] += d / n;
      g_vb.var[b][j] += (d * (f[j] - g_vb.media[b][j]) - g_vb.var[b][j]) / n;
    }
    g_vbSucio = true;
  }
  // ~10 s seguidos raros = alerta; se quita después de ~40 s normales
  if (k && g_vbScore > 3.5f) { g_vbBien = 0; if (g_vbSeguidas < 255) g_vbSeguidas++; }
  else { g_vbSeguidas = 0; if (g_vbBien < 255) g_vbBien++; }
  if (!datos.vibraAlerta && g_vbSeguidas >= 8) { datos.vibraAlerta = true; registrarEvento(EVT_VIBRA, g_vbScore); }
  if (datos.vibraAlerta && g_vbBien >= 30) datos.vibraAlerta = false;
  if (g_vbCaptura) {
    char fe[24], l[128];
    fechaTexto(fe, sizeof fe, ahora());
    snprintf(l, sizeof l, "%s,%d,%.1f,%d,%.4f,%.3f,%.3f,%.3f,%.2f", fe, rpm, v, datos.marcha,
             f[0], f[1], f[2], f[3], g_vbScore);
    sdAgregar("/vibra.csv", "fecha,rpm,vel,marcha,log_rms,log_motor,log_rueda,log_rueda2,score", l);
  }
}

// En cada vuelta de loop: saca de la FIFO lo que haya (máx. 20 lecturas por llamada, ~11 ms del bus I2C)
void vibraActualizar() {
  bool usar = g_vbActiva && g_imuOk && !g_modoDemo && g_motorEnc;
  vibraFifo(usar);
  if (!usar) {
    if (g_vbSucio && millis() - g_vbGuardado > 300000) vibraGuardar(true);
    return;
  }
  static uint32_t ultima = 0;                   // cada 50 ms (se juntan ~5 lecturas): no ocupar el bus I2C de más
  if (millis() - ultima < 50) return;
  ultima = millis();
  uint16_t cuenta = ((uint16_t)imuLeer(0x72) << 8) | imuLeer(0x73);
  if (cuenta >= 1000) { vibraFifo(false); vibraFifo(true); return; }    // se llenó: se perdió el orden, empieza de nuevo
  uint8_t muestras = min((uint16_t)20, (uint16_t)(cuenta / 6));
  if (!muestras) return;
  Wire.beginTransmission(MPU_DIR);
  Wire.write(0x74);
  if (Wire.endTransmission(false) != 0) return;
  if (Wire.requestFrom((uint8_t)MPU_DIR, (uint8_t)(muestras * 6)) != muestras * 6) return;
  for (uint8_t m = 0; m < muestras; m++) {
    for (uint8_t e = 0; e < 3; e++) {
      int16_t raw = (Wire.read() << 8) | Wire.read();
      float g = raw / 8192.0f;
      g_vbMedia[e] += 0.02f * (g - g_vbMedia[e]);       // quita la gravedad y lo lento (pasa altas ~0.3 Hz)
      g_vbBuf[e][g_vbI] = g - g_vbMedia[e];
    }
    if (++g_vbI >= VB_N) { g_vbI = 0; vibraVentana(); }
  }
  if (g_vbSucio && millis() - g_vbGuardado > 300000) vibraGuardar(true);
}

uint8_t vibraMaduros() { uint8_t m = 0; for (uint8_t b = 0; b < VB_BINS; b++) if (g_vb.n[b] >= 120) m++; return m; }

//  vibra | vibra on|off | vibra captura on|off | vibra olvidar
void vibraJson(Print& out) {
  out.printf("{\"vb\":%d,\"vc\":%d,\"vm\":%u,\"vn\":%lu,\"vs\":%.2f,\"va\":%d}\n", g_vbActiva ? 1 : 0, g_vbCaptura ? 1 : 0,
             vibraMaduros(), (unsigned long)g_vbVentanas, g_vbScore, datos.vibraAlerta ? 1 : 0);
}

void vibraComando(const String& low, Print& out) {
  String c1 = palabra(low, 1), c2 = palabra(low, 2);
  if (c1 == "on" || c1 == "off") { g_vbActiva = c1 == "on"; vibraGuardar(false); }
  else if (c1 == "captura") { g_vbCaptura = c2 == "on"; vibraGuardar(false); }
  else if (c1 == "olvidar") { memset(&g_vb, 0, sizeof g_vb); g_vb.magic = MAGIC_VIBRA; datos.vibraAlerta = false; vibraGuardar(true); }
  vibraJson(out);
}

// ================================================================
// 21f) MÁS IA Y AYUDAS: baches, estado de los componentes, llave de proximidad y resumen semanal
// ================================================================
// --- IA de baches: un golpe vertical (en la dirección de la gravedad con la moto derecha) mucho más fuerte que la
// vibración normal de ese momento. Se compara contra la vibración que viene trayendo (adaptativo): en empedrado o a
// muchas RPM sube el umbral solo. Rodando a más de 15 km/h y con GPS. Va a baches.csv y a la app (su mapa de baches).
const float BACHE_MIN_G = 0.45f;       // nunca menos que esto
const float BACHE_VECES = 4.0f;        // ... ni menos de 4 veces la vibración normal
float g_vertRms = 0.1f;
uint32_t g_bacheUlt = 0;
uint16_t g_bachesHoy = 0;

void bachesRevisar() {
  if (g_modoSeguro) return;
  float nr = sqrtf(P.imuRef[0] * P.imuRef[0] + P.imuRef[1] * P.imuRef[1] + P.imuRef[2] * P.imuRef[2]);
  if (nr < 0.5f) return;
  float vert = (g_acc[0] * P.imuRef[0] + g_acc[1] * P.imuRef[1] + g_acc[2] * P.imuRef[2]) / nr - nr;   // g extra hacia arriba/abajo
  float v = isnan(datos.vel) ? 0 : datos.vel;
  float f = fabsf(vert);
  bool golpe = f > max(BACHE_MIN_G, BACHE_VECES * g_vertRms);
  g_vertRms = sqrtf(g_vertRms * g_vertRms * 0.98f + vert * vert * 0.02f);   // vibración normal (~1 s)
  if (!golpe || g_modoDemo || v < 15 || !datos.gpsFix || millis() - g_bacheUlt < 1500) return;
  g_bacheUlt = millis();
  g_bachesHoy++;
  float fuerza = f * 9.81f;            // en m/s², como los mide el teléfono
  char l[96];
  char fe[24];
  fechaTexto(fe, sizeof fe, ahora());
  snprintf(l, sizeof l, "%s,%.6f,%.6f,%.2f,%.0f", fe, datos.lat, datos.lon, fuerza, v);
  sdAgregar("/baches.csv", "fecha,lat,lon,fuerza_ms2,vel", l);
  snprintf(l, sizeof l, "{\"k\":\"b\",\"la\":%.6f,\"lo\":%.6f,\"f\":%.1f}", datos.lat, datos.lon, fuerza);
  bleEvento(l);
}

// --- Estado de los componentes: 0-100 y qué hacer, con lo que la tarjeta ya mide.
extern float g_vbRuedaZ;

float mantFraccion(uint8_t i) { return P.mant[i].intKm ? constrain(mantKmDesde(i) / P.mant[i].intKm, 0.0f, 1.5f) : 0; }

uint8_t saludCalcular(ItemSalud* it) {
  // Batería: voltaje en reposo, tendencia, último arranque y carga del alternador
  int p = 100; String c = "Bien.";
  float ur = reposoUltimo();
  if (ur > 5 && ur < 12.2f) { p -= 40; c = "En reposo está baja (" + String(ur, 2) + " V): cárgala o revísala."; }
  else if (ur > 5 && ur < 12.4f) { p -= 20; c = "En reposo está a media carga (" + String(ur, 2) + " V)."; }
  int dias = diasHastaBateriaDebil();
  if (dias >= 0 && dias < 30) { p -= 20; c = "Va bajando: en ~" + String(dias) + " días quedaría débil."; }
  float dip = NAN;
  for (uint8_t i = 0; i < NUM_ARRANQUES_DIAG; i++) { float x = A.arranques[(A.idxArr + NUM_ARRANQUES_DIAG - 1 - i) % NUM_ARRANQUES_DIAG]; if (!isnan(x)) { dip = x; break; } }
  if (!isnan(dip) && dip < 9.6f) { p -= 35; c = "Al dar marcha baja a " + String(dip, 1) + " V: la batería ya está cansada."; }
  else if (!isnan(dip) && dip < 10.2f) { p -= 15; c = "Al dar marcha baja a " + String(dip, 1) + " V: vigílala."; }
  if (g_estadoCarga == 2) { p -= 40; c = "El alternador no está cargando: revisa el regulador."; }
  if (g_estadoCarga == 3) { p -= 40; c = "Sobrecarga: el regulador está fallando."; }
  it[0] = {"Batería", constrain(p, 0, 100), c};
  // Cadena: km desde la última lubricada + vibración a la vuelta de la rueda (IA de vibraciones)
  float fr = mantFraccion(0);
  p = 100 - (int)(70 * min(fr, 1.0f)); c = fr >= 1 ? "Ya toca lubricarla y ajustarla." : fr > 0.7f ? "Pronto toca lubricarla." : "Bien.";
  if (g_vbRuedaZ > 2.5f) { p -= 25; c = "Vibra raro a la vuelta de la rueda: revisa la tensión de la cadena y el rin."; }
  it[1] = {"Cadena", constrain(p, 0, 100), c};
  // Encendido: chispas que faltan, irregularidad, ralentí y bujía
  p = 100; c = "Bien.";
  noInterrupts(); uint32_t pul = g_pulsos, fal = g_chispaFaltas, irs = g_irrSuma, irn = g_irrN; interrupts();
  float pf = pul > 2000 ? 100.0f * fal / pul : 0;
  if (pf > 2) { p -= 50; c = "Faltan chispas (" + String(pf, 1) + " %): revisa bujía, capuchón y cable."; }
  else if (pf > 0.5f) { p -= 25; c = "Se brinca alguna chispa: revisa la bujía."; }
  if (irn > 500 && irs / irn > 120) { p -= 20; if (c == "Bien.") c = "El motor va irregular."; }
  if (ralentiFuera()) { p -= 15; if (c == "Bien.") c = "Ralentí fuera de rango (" + String((int)g_ralenti) + " rpm)."; }
  if (mantFraccion(3) >= 1) { p -= 20; if (c == "Bien.") c = "Ya toca cambiar la bujía."; }
  it[2] = {"Encendido", constrain(p, 0, 100), c};
  // Frenos: km desde el último servicio
  fr = mantFraccion(4);
  it[3] = {"Frenos", constrain(100 - (int)(70 * min(fr, 1.0f)), 0, 100), fr >= 1 ? String("Ya toca revisar balatas.") : fr > 0.7f ? String("Pronto toca revisarlas.") : String("Bien.")};
  // Motor: aceite, temperatura y ralentí
  float frKm = mantFraccion(1), frEf = iaAceiteFraccion();        // km del odómetro vs km efectivos (uso pesado)
  fr = max(frKm, frEf);
  p = 100 - (int)(50 * min(fr, 1.0f)); c = fr >= 1 ? "Ya toca cambio de aceite." : fr > 0.7f ? "Pronto toca cambio de aceite." : "Bien.";
  if (fr > 0.7f && frEf > frKm + 0.1f) c += " (lo has exigido: muchas RPM, calor o viajes cortos)";
  if (!isnan(datos.tempC) && datos.tempC > TEMP_MAX_C) { p -= 40; c = "Se está calentando de más (" + String((int)datos.tempC) + " °C)."; }
  if (mantFraccion(2) >= 1) { p -= 10; if (c == "Bien.") c = "Ya toca cambiar el filtro."; }
  it[4] = {"Motor", constrain(p, 0, 100), c};
  // Embrague: IA del motor (21i)
  p = iaEmbraguePuntos(c);
  it[5] = {"Embrague", p, c};
  return 6;
}

//  salud      estado de los componentes en JSON (la app y Telegram)
void saludJson(Print& out) {
  ItemSalud it[6];
  uint8_t n = saludCalcular(it);
  out.print(F("{\"salud\":["));
  for (uint8_t i = 0; i < n; i++) {
    char cons[80];
    textoSeguro(cons, sizeof cons, it[i].consejo.c_str());
    out.printf("%s{\"c\":\"%s\",\"p\":%d,\"t\":\"%s\"}", i ? "," : "", it[i].nombre, it[i].puntos, cons);
  }
  out.println(F("]}"));
}

// --- Llave de proximidad (APAGADA de fábrica): al girar la llave con la moto parada, el bloqueo (relevador 1) se
// queda puesto hasta que tu teléfono vinculado (el POCO o el iPhone) se conecte cifrado, o escribas tu código con
// los 3 botones (de fábrica: arriba, arriba, abajo, OK). Nunca bloquea rodando; ya liberada no vuelve hasta apagar.
struct Llave { uint32_t magic; bool activa; uint8_t codigo[4]; };
const uint32_t MAGIC_LLAVE = 0xF150C1A1;
Llave g_llave;
bool g_llaveCerrada = false;
uint8_t g_llaveIdx = 0;

void llaveCargar() {
  Preferences s;
  s.begin("llave", true);
  bool ok = s.getBytesLength("l") == sizeof(Llave) && s.getBytes("l", &g_llave, sizeof(Llave)) == sizeof(Llave) && g_llave.magic == MAGIC_LLAVE;
  s.end();
  if (!ok) { g_llave = {MAGIC_LLAVE, false, {EV_ARRIBA, EV_ARRIBA, EV_ABAJO, EV_OK}}; }
}

void llaveGuardar() { Preferences s; s.begin("llave", false); s.putBytes("l", &g_llave, sizeof g_llave); s.end(); }

bool telefonoCerca();   // en la parte del Bluetooth (29b): un teléfono vinculado conectado y cifrado
bool llaveroPresente();  // llavero TamaXOF con la clave, hace menos de 15 s (sección del llavero, abajo)
void llaveroCambiar(bool on);
extern bool g_llaveroOn;

void llaveTick() {
  static bool ignAntes = false;
  bool ign = datos.ignicion;
  if (!ign && g_paroLlavero) { g_paroLlavero = false; releAplicar(); }   // el paro dura hasta quitar la llave
  if (!g_llave.activa || g_modoDemo) { g_llaveCerrada = false; ignAntes = ign; return; }
  float v = isnan(datos.vel) ? 0 : datos.vel;
  bool tuyo = telefonoCerca() || llaveroPresente();
  if (ign && !ignAntes && v < VEL_MAX_CORTE && !tuyo) { g_llaveCerrada = true; g_llaveIdx = 0; }
  if (!ign) g_llaveCerrada = false;
  if (g_llaveCerrada && tuyo) { g_llaveCerrada = false; aviso(telefonoCerca() ? "Telefono OK" : "Llavero OK"); }
  ignAntes = ign;
}

// --- Llavero TamaXOF (ESP-NOW cifrado, ver llavero/LEEME.md). PRENDIDO de fábrica; "llave llavero off" lo apaga.
// Mientras la tarjeta está despierta el WiFi se queda en STA (sin conectarse a nada) para poder oír al llavero.
// Órdenes: presencia (libera la llave de proximidad), bloquear (como /bloquear: solo parada), apagar (botón de
// paro: corta aunque vayas rodando, porque lo pides tú manteniendo OK 2 s; dura hasta "permitir" o quitar la
// llave), permitir (quita paro y bloqueo) y buscar (sirena 5 s si configuraste una en la alarma).
bool g_llaveroOn = true;

void llaveroCargar() { Preferences s; s.begin("llave", true); g_llaveroOn = s.getBool("tx", true); s.end(); }

#if USAR_LLAVERO
bool llaveroPresente() { return g_llaveroOn && llaveroCerca(); }

void llaveroCambiar(bool on) {
  g_llaveroOn = on;
  Preferences s; s.begin("llave", false); s.putBool("tx", on); s.end();
  if (on) txMotoIniciar(); else txMotoParar();
}

// Apaga el WiFi "de verdad" solo si el llavero no lo necesita; si no, nada más se desconecta y se queda en STA.
void wifiSoltar() {
  if (g_llaveroOn) { WiFi.disconnect(false); if (WiFi.getMode() == WIFI_OFF) WiFi.mode(WIFI_STA); }
  else WiFi.mode(WIFI_OFF);
}

bool txMotoEjecutar(uint8_t orden) {
  TextoPrint tp;
  switch (orden) {
    case OR_PRESENCIA:
      if (g_llaveCerrada) { g_llaveCerrada = false; g_llaveIdx = 0; aviso("Llavero OK"); releAplicar(); }
      return true;
    case OR_BLOQUEAR:
      return corteCambiar(true, tp);                     // igual que /bloquear: se niega rodando
    case OR_APAGAR:
      if (g_modoDemo) return false;
      g_paroLlavero = true;
      releAplicar();
      registrarEvento(EVT_CORTE, 2);
      aviso("PARO (llavero)");
      return true;
    case OR_PERMITIR:
      g_paroLlavero = false;
      if (g_llaveCerrada) { g_llaveCerrada = false; g_llaveIdx = 0; }
      if (P.corteActivo || g_corteCaida) corteCambiar(false, tp); else releAplicar();
      aviso("Motor libre (llavero)");
      return true;
    case OR_BUSCAR:
      if (!g_alarma.sirena) return false;
      g_sirenaHasta = millis() + 5000;
      return true;
    case OR_PRESTAR:                                     // "prestar moto": arranca con la pura llave
      g_llave.activa = false;
      g_llaveCerrada = false;
      llaveGuardar();
      releAplicar();
      aviso("Moto prestada");
      return true;
    case OR_DEVOLVER:                                    // vuelve la llave de proximidad
      g_llave.activa = true;
      llaveGuardar();
      aviso("Llave prox. ON");
      return true;
  }
  return false;
}

bool construirAlerta(char* txt, size_t n, Icono& icono);   // sección 22

// Telemetría para la pantalla "Tablero" del llavero (4 veces por segundo mientras la tiene abierta)
void txMotoTele(TxTele& t) {
  TxEstado e = {};
  txMotoLlenar(e);
  t.flags = e.flags;
  t.vel = e.vel;
  t.gas = e.gas;
  t.vMoto_cV = e.vMoto_cV;
  t.km10 = e.km10;
  t.epoch = e.epoch;
  t.rpm = datos.rpm < 0 ? -1 : (int16_t)min(datos.rpm, 30000);
  t.marcha = datos.neutral ? 0 : (int8_t)datos.marcha;
  t.temp10 = isnan(datos.tempC) ? INT16_MIN : (int16_t)lroundf(datos.tempC * 10);
  char txt[sizeof t.alerta];
  Icono ic;
  if (construirAlerta(txt, sizeof txt, ic)) {
    t.tipoAlerta = ic == ICO_BT ? TA_TEL : TA_MOTO;
    memcpy(t.alerta, txt, sizeof t.alerta);
    t.alerta[sizeof t.alerta - 1] = 0;
  }
}

void txMotoLlenar(TxEstado& e) {
  float v = isnan(datos.vel) ? 0 : datos.vel;
  e.flags = 0;
  if (P.corteActivo || g_corteCaida || g_llaveCerrada) e.flags |= EF_BLOQ;
  if (g_paroLlavero) e.flags |= EF_APAGADO;
  if (datos.ignicion) e.flags |= EF_IGN;
  if (v > VEL_MAX_CORTE) e.flags |= EF_RODANDO;
  if (g_llave.activa) e.flags |= EF_LLAVE;
  e.vMoto_cV = isnan(datos.vMoto) ? -1 : (int16_t)lroundf(datos.vMoto * 100);
  e.gas = datos.gasPct < 0 ? -1 : (int8_t)constrain(datos.gasPct, 0, 100);
  e.vel = (uint8_t)constrain((int)lroundf(v), 0, 255);
  e.km10 = (uint32_t)(P.odometro * 10);
  e.epoch = g_rtcOk ? ahoraEpoch() : 0;
}
#else
bool llaveroPresente() { return false; }
void llaveroCambiar(bool on) { g_llaveroOn = on; }
#endif

bool llaveBoton(uint8_t ev) {
  if (!g_llaveCerrada) return false;
  if (ev == EV_OK_LARGO) return true;
  if (ev == g_llave.codigo[g_llaveIdx]) {
    if (++g_llaveIdx >= 4) { g_llaveCerrada = false; g_llaveIdx = 0; aviso("Codigo OK"); releAplicar(); }
  } else g_llaveIdx = (ev == g_llave.codigo[0]) ? 1 : 0;
  return true;
}

//  llave | llave on|off | llave codigo <4 de a/b/o>  (a = arriba, b = abajo, o = OK)
void llaveComando(const String& low, Print& out) {
  String c1 = palabra(low, 1), c2 = palabra(low, 2);
  if (c1 == "on" || c1 == "off") { g_llave.activa = c1 == "on"; if (!g_llave.activa) g_llaveCerrada = false; llaveGuardar(); }
  else if (c1 == "llavero" && (c2 == "on" || c2 == "off")) { llaveroCambiar(c2 == "on"); }
  else if (c1 == "codigo") {
    if (c2.length() != 4) { out.println(F("Usa: llave codigo aabo (a arriba, b abajo, o OK)")); return; }
    for (uint8_t i = 0; i < 4; i++) {
      char x = c2[i];
      if (x != 'a' && x != 'b' && x != 'o') { out.println(F("Solo a, b u o.")); return; }
      g_llave.codigo[i] = x == 'a' ? EV_ARRIBA : x == 'b' ? EV_ABAJO : EV_OK;
    }
    llaveGuardar();
  }
  out.printf("{\"ll\":%d,\"lc\":%d,\"tel\":%d,\"tx\":%d,\"txc\":%d,\"paro\":%d}\n", g_llave.activa ? 1 : 0,
             g_llaveCerrada ? 1 : 0, telefonoCerca() ? 1 : 0, g_llaveroOn ? 1 : 0, llaveroPresente() ? 1 : 0, g_paroLlavero ? 1 : 0);
}

// --- Resumen semanal (Telegram, el lunes): km, viajes, gasolina, velocidad máxima y baches
struct Semana { uint32_t magic, id; float km, litros, vmax; uint16_t viajes, baches; };
const uint32_t MAGIC_SEMANA = 0xF150D1A1;
Semana g_semana;

uint32_t semanaId() { return g_rtcOk ? (ahoraEpoch() - 345600UL) / 604800UL : 0; }   // cambia los lunes a las 0:00

void semanaCargar() {
  Preferences s; s.begin("semana", true);
  bool ok = s.getBytesLength("s") == sizeof(Semana) && s.getBytes("s", &g_semana, sizeof g_semana) == sizeof g_semana && g_semana.magic == MAGIC_SEMANA;
  s.end();
  if (!ok) { memset(&g_semana, 0, sizeof g_semana); g_semana.magic = MAGIC_SEMANA; g_semana.id = semanaId(); }
}

void semanaGuardar() { Preferences s; s.begin("semana", false); s.putBytes("s", &g_semana, sizeof g_semana); s.end(); }

void semanaSumarViaje(float km, float litros, float vmax) {
  if (g_modoDemo) return;
  g_semana.km += km; g_semana.litros += litros; g_semana.viajes++;
  g_semana.vmax = max(g_semana.vmax, vmax);
  g_semana.baches += g_bachesHoy; g_bachesHoy = 0;
  semanaGuardar();
}

/** Texto del resumen de la semana que terminó ("" si no hubo viajes). */
String semanaTexto() {
  if (g_semana.viajes == 0) return "";
  String t = "📊 Tu semana en la FT150TS\n🛣️ " + String(g_semana.km, 1) + " km en " + String(g_semana.viajes) + " viajes\n";
  if (g_semana.litros > 0.1f) t += "⛽ ~" + String(g_semana.litros, 1) + " L (" + String(g_semana.km / g_semana.litros, 1) + " km/L)\n";
  t += "🏁 Máxima " + String((int)g_semana.vmax) + " km/h\n";
  if (g_semana.baches) t += "🕳️ " + String(g_semana.baches) + " baches\n";
  t += "🔧 Escribe /salud para ver cómo está la moto.";
  return t;
}

// ================================================================
// 21g) PLACA E: EXPANSIÓN I2C (PCF8574 en 0x20)
// ================================================================
// P0 = relevador 1 (BOMBA), P1/P2 = relevadores 2 y 3, P3 = salida aislada, P4..P7 = entradas 1..4. Todo activo en 0.
// Las entradas se leen solo si su bit está en 1 (el PCF solo jala a tierra), así que siempre se escriben en 1.
// La INT del PCF no llega a la placa B: se lee cada 100 ms. Sin la placa E todo sigue igual (se busca cada 5 s).
// Al arrancar y antes de dormir se escribe 0xFF: si la tarjeta se reinicia con la BOMBA prendida, se apaga en < 1 s.
const uint8_t  E_DIR             = 0x20;
const uint16_t E_BOMBA_MAX_S     = 600;    // tope de una inflada (10 min): casi todos los infladores piden descanso
const uint16_t E_BOMBA_DESCANSO_S = 300;   // después de llegar al tope, 5 min sin poder prenderla
const float    E_BOMBA_ARRANQUE_V = 11.8f; // motor apagado y batería abajo de esto: no arranca (prende el motor)
const float    E_BOMBA_CORTE_V   = 10.5f;  // inflando, si la batería cae abajo de esto 2 s: se apaga (batería o motor trabado)
// Qué hay en las 4 entradas de la placa E (las mismas opciones que ENT2/ENT3 de la placa B)
const FuncionEntrada FUNCION_E[4] = {ENT_LIBRE, ENT_LIBRE, ENT_LIBRE, ENT_LIBRE};

bool g_eHay = false;              // la placa E contesta
uint8_t g_eFallas = 0;            // errores I2C seguidos
uint8_t g_eSal = 0;               // bit 0 BOMBA, 1 relevador 2, 2 relevador 3, 3 salida (1 = prendido)
uint32_t g_eHasta[4] = {0, 0, 0, 0};
uint8_t g_eEnt = 0;               // bits 0..3: 1 = la entrada tiene voltaje
uint8_t g_eCorto = 0;             // salidas que se leen al revés (pista en corto o PCF dañado)
uint32_t g_eBombaDesde = 0, g_eDescansoHasta = 0, g_eBajoDesde = 0, g_eBuscar = 0;
String g_eMotivo = "";            // por qué se apagó la BOMBA la última vez

void guardianError(uint8_t cod, const String& texto);
extern uint32_t g_reiniciarEn;     // "reiniciar" (sección 28): el guardián la usa para reiniciar ordenadamente
const uint8_t ERR_PLACA_E = 10, ERR_BOMBA = 11, ERR_E_CORTO = 12;

bool pcfEscribir(uint8_t v) { Wire.beginTransmission(E_DIR); Wire.write(v); return Wire.endTransmission() == 0; }
int pcfLeer() { if (Wire.requestFrom(E_DIR, (uint8_t)1) != 1) return -1; return Wire.read(); }
uint8_t eByte() { return (uint8_t)(0xF0 | (~g_eSal & 0x0F)); }   // salidas activas en 0, entradas en 1

void placaEBegin() {
  g_eSal = 0;
#if !USAR_PLACA_E
  return;
#endif
  g_eHay = pcfEscribir(0xFF);
  Serial.printf("Placa E (0x%02X): %s\n", E_DIR, g_eHay ? "si" : "no esta");
}

/** Todo apagado (antes de dormir o si algo falla). */
void placaEApagar() {
  g_eSal = 0;
  for (uint8_t i = 0; i < 4; i++) g_eHasta[i] = 0;
  if (g_eHay) pcfEscribir(0xFF);
}

void eBombaParar(const String& motivo) {
  if (!(g_eSal & 1)) return;
  g_eSal &= ~1;
  g_eHasta[0] = 0;
  g_eMotivo = motivo;
  Serial.println("BOMBA apagada: " + motivo);
}

void placaETick() {
#if !USAR_PLACA_E
  return;
#endif
  uint32_t ms = millis();
  if (!g_eHay) {
    if (ms - g_eBuscar < 5000) return;
    g_eBuscar = ms;
    if (!pcfEscribir(0xFF)) return;
    g_eHay = true; g_eFallas = 0; g_eSal = 0;
    Serial.println(F("Placa E conectada"));
  }
  for (uint8_t i = 0; i < 4; i++)
    if (g_eHasta[i] && (int32_t)(ms - g_eHasta[i]) >= 0) {
      if (i == 0) eBombaParar("terminó el tiempo");
      else g_eSal &= ~(1 << i);
      g_eHasta[i] = 0;
    }
  // BOMBA: tope de tiempo, batería y moto en movimiento
  if (g_eSal & 1) {
    float v = datos.vMoto, vel = isnan(datos.vel) ? 0 : datos.vel;
    if (ms - g_eBombaDesde > E_BOMBA_MAX_S * 1000UL) {
      eBombaParar("llegó al tope de " + String(E_BOMBA_MAX_S / 60) + " min (descansa " + String(E_BOMBA_DESCANSO_S / 60) + " min)");
      g_eDescansoHasta = ms + E_BOMBA_DESCANSO_S * 1000UL;
    } else if (vel > 5) eBombaParar("la moto empezó a moverse");
    else if (!isnan(v) && v > 5 && v < E_BOMBA_CORTE_V) {
      if (!g_eBajoDesde) g_eBajoDesde = ms;
      else if (ms - g_eBajoDesde > 2000) {
        eBombaParar("la batería cayó a " + String(v, 1) + " V");
        guardianError(ERR_BOMBA, "La BOMBA se apagó sola: la batería cayó a " + String(v, 1) + " V (batería débil o el motor de la bomba se trabó)");
      }
    } else g_eBajoDesde = 0;
  } else g_eBajoDesde = 0;

  uint8_t b = eByte();
  int r = pcfEscribir(b) ? pcfLeer() : -1;
  if (r < 0) {
    if (++g_eFallas >= 3) {
      g_eHay = false;
      bool habia = g_eSal != 0;
      g_eSal = 0;
      guardianError(ERR_PLACA_E, habia ? "La placa E dejó de contestar con algo prendido: revisa el cable I2C (sus relevadores pueden quedarse como estaban)"
                                       : "La placa E dejó de contestar: revisa el cable I2C");
    }
    return;
  }
  g_eFallas = 0;
  // Una salida apagada (1) que se lee en 0 = algo la jala a tierra: corto. Se apaga y se avisa una vez.
  uint8_t corto = (uint8_t)(b & ~r & 0x0F);
  if (corto && corto != g_eCorto) guardianError(ERR_E_CORTO, "Placa E: la salida P" + String(__builtin_ctz(corto)) + " se lee al revés (corto en la pista o el PCF8574 dañado)");
  g_eCorto = corto;
  g_eEnt = (uint8_t)((~r >> 4) & 0x0F);
}

/** Entradas de la placa E con función de freno o direccional (las lee entradasActualizar). */
void placaEEntradas(bool& freno, uint32_t ms) {
  if (!g_eHay) return;
  for (uint8_t i = 0; i < 4; i++) {
    if (!(g_eEnt & (1 << i))) continue;
    if (FUNCION_E[i] == ENT_FRENO) freno = true;
    if (FUNCION_E[i] == ENT_DIRECCIONAL) g_dirUltPulso = ms;
  }
}

void placaEJson(Print& out) {
  uint32_t ms = millis();
  long resta = (g_eSal & 1) && g_eHasta[0] ? (long)(g_eHasta[0] - ms) / 1000 : -1;
  long descanso = g_eDescansoHasta && (int32_t)(g_eDescansoHasta - ms) > 0 ? (long)(g_eDescansoHasta - ms) / 1000 : 0;
  char mot[64];
  textoSeguro(mot, sizeof mot, g_eMotivo.c_str());
  out.printf("{\"e\":{\"hay\":%d,\"s\":[%d,%d,%d,%d],\"in\":[%d,%d,%d,%d],\"bt\":%ld,\"des\":%ld,\"corto\":%u,\"mot\":\"%s\"}}\n",
             g_eHay, g_eSal & 1, (g_eSal >> 1) & 1, (g_eSal >> 2) & 1, (g_eSal >> 3) & 1,
             g_eEnt & 1, (g_eEnt >> 1) & 1, (g_eEnt >> 2) & 1, (g_eEnt >> 3) & 1, resta, descanso, g_eCorto, mot);
}

//  e                                   estado de la placa E
//  e bomba on [segundos] | off         BOMBA (de fábrica 3 min; tope 10 min)
//  e 2|3|s on [segundos] | off         relevadores 2 y 3 de la placa E y su salida aislada
void placaEComando(const String& low, Print& out) {
  String c1 = palabra(low, 1), c2 = palabra(low, 2);
  if (c1 == "") { placaEJson(out); return; }
  if (!g_eHay) { out.println(F("La placa E no contesta (revisa el cable I2C y que su dirección sea 0x20).")); return; }
  int8_t i = c1 == "bomba" || c1 == "1" ? 0 : c1 == "2" ? 1 : c1 == "3" ? 2 : (c1 == "s" || c1 == "salida") ? 3 : -1;
  if (i < 0 || (c2 != "on" && c2 != "off")) { out.println(F("Usa: e bomba|2|3|s on [segundos] | off")); return; }
  uint32_t ms = millis();
  if (c2 == "off") {
    if (i == 0) eBombaParar("la apagaste");
    else { g_eSal &= ~(1 << i); g_eHasta[i] = 0; }
  } else {
    uint32_t s = (uint32_t)palabra(low, 3).toInt();
    if (i == 0) {
      float v = datos.vMoto, vel = isnan(datos.vel) ? 0 : datos.vel;
      if (g_eDescansoHasta && (int32_t)(g_eDescansoHasta - ms) > 0) { out.printf("La BOMBA descansa %ld s más.\n", (long)(g_eDescansoHasta - ms) / 1000); return; }
      if (vel > 3) { out.println(F("Con la moto en movimiento no.")); return; }
      if (!g_motorEnc && !isnan(v) && v > 5 && v < E_BOMBA_ARRANQUE_V) {
        out.printf("Batería a %.1f V: prende el motor para inflar.\n", v); return;
      }
      s = constrain(s ? s : 180, (uint32_t)5, (uint32_t)E_BOMBA_MAX_S);
      if (!(g_eSal & 1)) g_eBombaDesde = ms;
      g_eMotivo = "";
    } else if (s) s = min(s, (uint32_t)86400);
    g_eSal |= (1 << i);
    g_eHasta[i] = s ? ms + s * 1000UL : 0;
  }
  placaETick();
  placaEJson(out);
}
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
void loop() {
  uint32_t ms = millis();

  adcActualizar();
  gpsActualizar();
  imuActualizar();
  tempActualizar();
  manejarBotones();
  leerConsola();
  notifRevisar();
#if USAR_BLE
  bleActualizar();
#endif
#if USAR_WIFI
  if (g_wifiIniciado) server.handleClient();
#endif
#if USAR_LLAVERO
  txMotoTick();
#endif

  if (ms - g_ultTick >= TICK_MS) {
    uint32_t dt = ms - g_ultTick;
    g_ultTick = ms;
    if (g_modoDemo) demoGenerar(); else actualizarDatosReales();
    brilloActualizar();
    revisarCaidasYFrenadas();
    motorActualizar();
    viajeActualizar(dt);
    iaMotorTick(dt);
    pistaActualizar();
    tempHistorial();
    static uint8_t cuenta = 0;
    if (++cuenta >= 2) { cuenta = 0; shiftAprender(dt * 2 / 1000.0f); }
    avanzadoTick();
    releAplicar();
    entradasActualizar(dt);
    cargaActualizar();
    salidasAplicar();
    placaETick();
    alarmaTick();
    llaveTick();
  }
  if (!g_modoSeguro) vibraActualizar();

  if (!g_modoSeguro) ledsActualizar();

  if (g_reiniciarEn && (int32_t)(ms - g_reiniciarEn) >= 0) ESP.restart();

  if (ms - g_ultLcd >= REFRESCO_LCD_MS) {
    g_ultLcd = ms;
    pantallaMostrar();
  }

  static uint32_t ultMin = 0;
  if (ms - ultMin > 60000) {
    ultMin = ms;
    revisarCambioDia();
    if (!datos.ignicion && !g_motorEnc && P.epochDormir == 0 && ms - g_ultIgnOn > 7200000UL)
      registrarReposoDiario(datos.vMoto);
    backupAutomatico();
    guardianTick();
  }
  if (ms - g_ultLogBat > LOG_BAT_MS) { g_ultLogBat = ms; logBaterias(); }
  if (g_nvsSucio && ms - g_ultimoGuardado > 300000) nvsGuardar();

  otaVigilar();
  casaTick();
  revisarDormir();
}
