z-XOF-z/FT150TS/(commit log)

2026-10-11 FT150TS Dashboard v2.8.1: app de Android, firmware ESP32 y portada
    - App de Android (Kotlin + Jetpack Compose): tablero LCD Sport y Clásico con
    aguja PID, RPM por vibración, marcha por velocidad + RPM, mapa con brújula,
    modo moto, modo sueño, launcher, mantenimiento, gasolina, dashcam y temas
    (Carbono, Vidrio, Filo, Pixel, Táctico) con neón y colores personalizados.
    - Firmware del ESP32-S3 en firmware/ft150ts_dashboard.
    - Portada: README con banner animado (docs/banner.svg), GIF de la entrada al
    tablero e imagen para la vista previa del repo.
    Claude-Session: https://claude.ai/code/session_01Ck17HfihiuCr3k5acbhfyu
2026-10-11 v2.9: rodadas, arrancones, lluvia en tu ruta, velocímetro, respaldo y logros
    - Rodadas: grabación automática, mapa pintado por velocidad con repetición
    x10/x30/x60, GPX y aviso de descanso cada 1.5 h.
    - Modo arrancones: salida por acelerómetro (filtro que ignora la vibración del
    motor), 0-40/60/80, 100 m y 1/8 de milla interpolando el GPS, semáforo con
    tiempo de reacción y prueba de frenado 40→0.
    - Lluvia en tu ruta: pronóstico de Open-Meteo 4-16 km adelante según rumbo y
    velocidad, aviso en el tablero y por voz.
    - Velocímetro vs GPS: medición por toque o por voz ("marca cuarenta").
    - Respaldo y restaurar de todos los datos (guardar, compartir, semanal).
    - Sorpresas: 14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
2026-10-11 Publica el APK de la v2.9 y el botón de descarga en la portada
    - releases/FT150TS-v2.9.apk: build release (com.xof.ft150ts 2.9).
    - releases/NOTAS-v2.9.md: notas de la versión.
    - README: botón "Descargar la app" e instalación rápida.
    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
2026-10-11 v2.9.1: el GPS muestra los satélites con buena señal y avisa bajo techo
    - Cuenta satélites con 25 dB-Hz o más; 'en uso' engañaba en chips Qualcomm/Xiaomi
    - 'señal débil (bajo techo)' en el mapa, chip, barra y página Moto
    - Detecta cuando el chip tiene posición pero Android no la entrega y la vuelve a pedir
    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
2026-10-11 v2.9.2: el GPS se reconecta solo y usa el GPS de Google de respaldo
    - Si hay buena señal y no llegan posiciones, renueva la petición sin apagar el chip
    (10/20/40 s y luego cada minuto, sin límite); antes se rendía a los 5 intentos
    - Al regresar a la app revive el GPS si estaba congelado
    - Respaldo con el fusionado de Google en alta precisión (Android 12+)
    - El servicio recupera el permiso de ubicación al abrir la app
    - Una hora mala en una posición ya no bloquea las siguientes
    - 'Perdida hace 1 h 59 min' en vez de segundos; precisión vieja oculta
    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
2026-10-12 v3.0: tema Vértice, modo reposo, medidor de fluidez y auditoría de seguridad
    - Tema Vértice con riel lateral en horizontal; temas Holo, Ácido y Circuito; 4 acentos fluorescentes
    - Modo reposo con la moto parada y cargando; atajos del ícono; baches por cuadra; resumen de rodada por voz
    - Seguridad: la app solo se conecta a la tarjeta verificada y fijada; respaldo validado (sin root, sin rutas raras)
    - Firmware 1.4: clave WiFi propia por tarjeta y comandos delicados solo desde un teléfono vinculado
    - Pruebas unitarias (11) e informe SEGURIDAD.md
2026-10-26 v3.10.0: código al día (v3.1 a v3.10.0) y firmware v1.5
    - App: CarPlay en pestaña, actualizador, ahorro nocturno, modo rendimiento, rutinas,
    zona Wi-Fi, volumen automático, tableros instrumento y neón, tema Racing Morado,
    pantallas de inicio nuevas y funciones avanzadas (apagadas de fábrica).
    - Firmware v1.5: limitador, launch control, quickshifter y diagnóstico (todo apagado),
    guía del corte de chispa con PC817 + IRF840 y simulador Wokwi.
    - Módulo Magisk "sin barra", scripts de diagnóstico y notas de todas las versiones.
2026-10-26 Placa base v2.3, placas extra, piezas 3D y guía de armado
    - pcb/: diseño de la placa B (KiCad + generadores en Python), esquemático en PDF,
    gerbers para JLCPCB, lista de piezas y guía de armado con las conexiones a la moto.
    - pcb/extras: placas E (expansión I2C), F (fusibles) y P (perforada).
    - pcb/simulacion: 6 bloques simulados con ngspice.
    - carcasa/: soporte del teléfono y caja bajo el asiento (STL, STEP y planos).
    - CLAUDE.md y docs/MAPA.md: mapa del proyecto.
    [01_entrada_bobina.kicad_sch, 02_entrada_aislada.kicad_sch, 03_entrada_sensor.kicad_sch, 04_divisores.kicad_sch, 05_rele.kicad_sch, 06_carga_bd140.kicad_sch, bandeja.step, bandeja.stl]
2026-10-30 v3.11.0-beta.1 + firmware v1.6 (beta: placa B sin probar en hardware)
    App:
    - Antirrobo del teléfono: fotos de las 2 cámaras, audio y ubicación por Telegram
    - Estado de la moto (salud), gráficas de voltaje de 24 h, sección de la placa B
    - Actualizar la tarjeta por Bluetooth (OTA), telemetría binaria a 10/s, registros de la SD
    - WiFi de casa + Telegram en la tarjeta, alarma de movimiento, IA de vibraciones y de baches
    - Pantalla: CarPlay escondido ya no la deja prendida; la PC no cuenta como "en la moto"
    - Batería: GPS y búsqueda Bluetooth en ahorro fuera de la moto
    - Estabilidad: red de seguridad en todas las tareas de fondo (Seguro.kt)
    Firmware v1.6: pines de la placa B, freno/direc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
2026-11-08 v3.12.0: llavero TamaXOF, firmware v1.8 y caja de la placa B v5
    - App 3.12.0 (code 56): switch y estado del llavero en Placa B; junta las betas 3.11.0.
    - Firmware v1.8: ESP-NOW cifrado con el llavero, prestar moto, telemetría al llavero.
    - llavero/: firmware ESP32-C3, placa casera y carcasa (sin la clave secreta).
    - carcasa/caja_tablero v5: aberturas a la medida de cada bornera con cejas en la tapa.
    [caja_charola.step, caja_charola.stl, caja_charola_v4.stl, caja_ensamble.stl, caja_tapa.step, caja_tapa.stl, caja_tapa_v4.stl, cama_220_caja_ft150ts.stl]
